ptymek/projekt_obpla_wip/SCREENY/MATRYCA_AKSJONOMETRIA.jpg

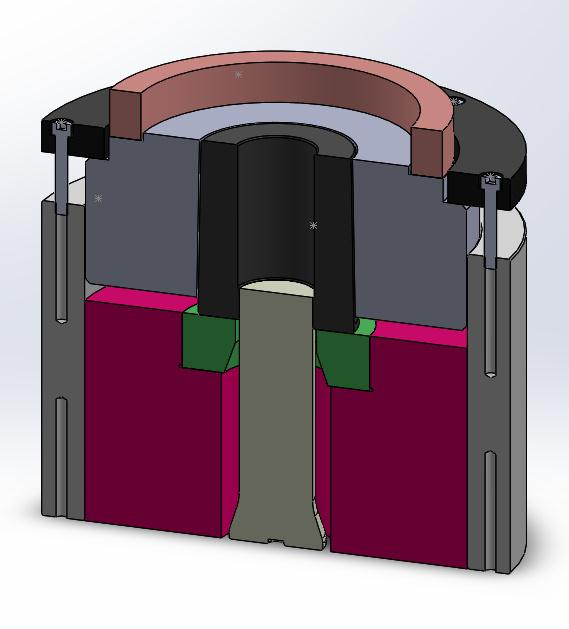
SCREENY/MATRYCA_AKSJONOMETRIA.jpg
