ptymek/projekt_obpla_wip/SCREENY/POZYCJA_WYPCHNIĘCIE_AKSJONOMETRIA.jpg

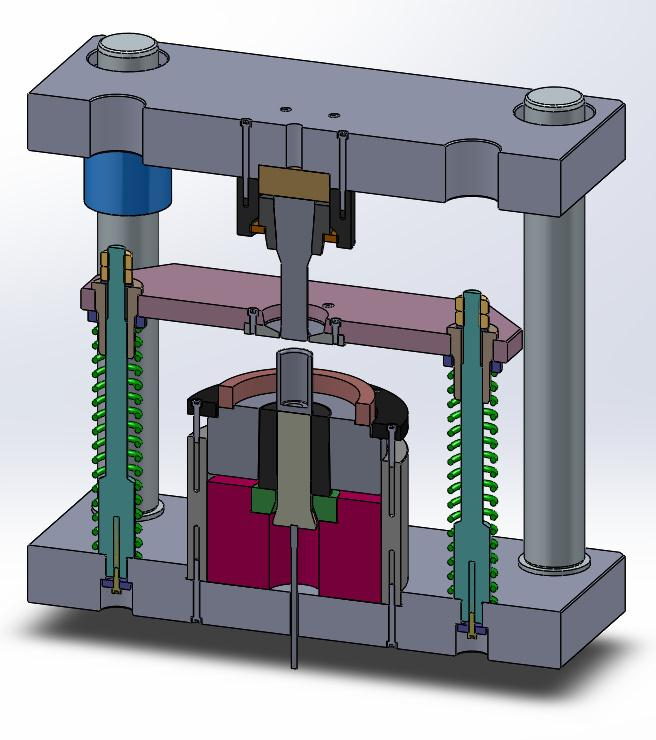
SCREENY/POZYCJA_WYPCHNIĘCIE_AKSJONOMETRIA.jpg
