ptymek/projekt_obpla_wip/PDF/PROiT-2014-bryly-r2.pdf

Projektowanie

TECHNOLOGIA KSZTAŁTOWANIA WYPRASEK NACZYNIOWYCH METODAMI OBRÓBKI PLASTYCZNEJ OBJĘTOŚCIOWEJ

### Materiały pomocnicze do projektowania

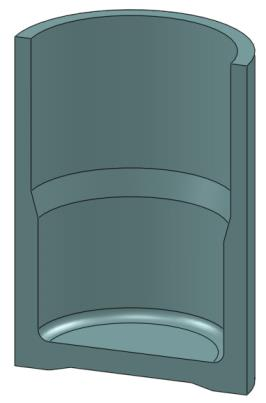
[picture p3: figure]
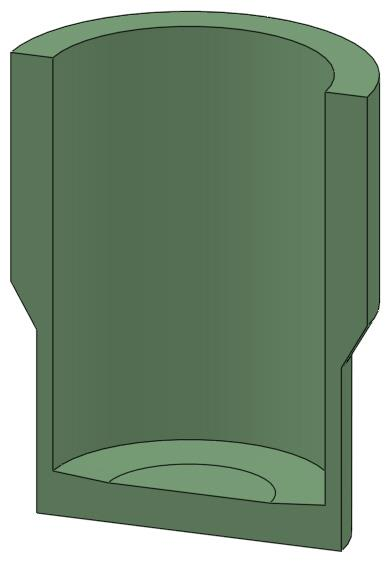
[picture p4: figure]

Wojciech Presz

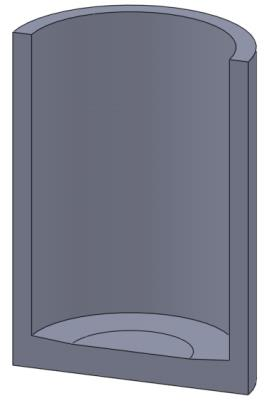
[picture p5: figure]
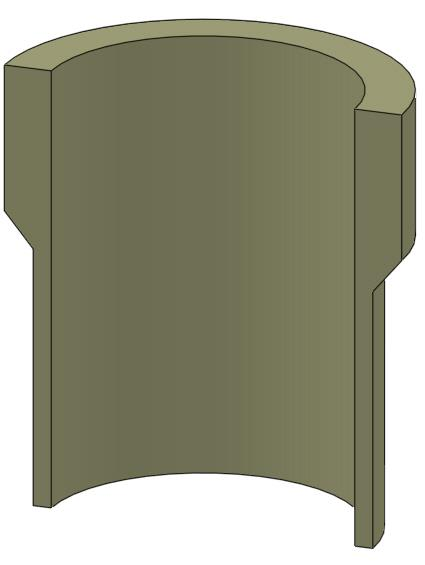
[picture p6: figure]

Uwaga! Dokument w fazie powstawania.

# Wersja 2014 r1

Instytut Technik Wytwarzania Politechniki Warszawskiej 2014

PROiT-2014-bryly-r2.doc | 2

Do realizacji projektu konieczny jest dostęp do programu SolidWorks wersja edukacyjna.

Nowoczesne projektowanie

Rysunek techniczny powstał jako forma zapisu otaczającego nas świata przestrzennego za pomocą rysunków płaskich. Umieszczane na papierze były następnie podstawą procesu wytwarzania na kolejnych stanowiskach roboczych. Konstruktor w przypadku złożonych urządzeń zmuszony był rozrysowywać wiele przekrojów, tak by zauważyć przestrzenne kolizje elementów. Umieszczane na rysunkach wykonawczych wymiary musiały być sprawdzane przez kolejne osoby, które starały się zauważyć często zdarzające się pomyłki. Na rysunkach zaznaczano także, inne prócz kształtu cechy przedmiotów: materiał, obróbkę cieplną, chropowatość poszczególnych powierzchni, tolerancje wymiarów i kształtów itp. Cechy te wiązane były z określonymi miejscami poszczególnych rysunków i przez niedopatrzenia mogły nie być przenoszone na kolejne arkusze.
Obecnie, stosowane jest powszechnie projektowanie parametryczne 3D, którego podstawą jest tworzenie konstrukcji przestrzennych w przestrzeni matematycznej. Tak zapisane konstrukcje umożliwiają automatyczne lub choćby wizualne wykrywanie kolizji przestrzennych, a więc praktycznie eliminują pomyłki rysunkowe i nie wymagają sprawdzania pod tym kątem. Automatyczne wymiarowanie eliminuje błędy wymiarowania poszczególnych rysunków wykonawczych, a cechy są przyporządkowywane poszczególnym powierzchniom lub bryłom, co powoduje ich automatyczne przenoszenie do tworów zależnych. Parametryzacja wymiarów i budowanie zależności pomiędzy nimi powoduje łatwość wprowadzania zmian konstrukcyjnych, a pakiety obliczeniowe podają wymagane parametry konstrukcji lub jej części: objętość, powierzchnię, ciężar itp. Przestrzenny zapis elementów konstrukcji: (poszczególnych części) pozwala także na bezpośrednie generowanie kodów do maszyn lub centrów obróbczych sterowanych numerycznie, co obecnie w niektórych wypadkach wręcz eliminuje konieczność powstawania tradycyjnych rysunków technicznych. Matematyczny zapis przestrzenny elementów pozwala także na bezpośrednie przenoszenie ich do programów obliczeniowych np. MES (metoda elementów skończonych) w celu obliczeń wytrzymałościowych.

Sposób realizacji projektu

Projekt ma być realizowany w oparciu o edukacyjną wersje programu SolidWorks (2013/2014) , w którym definiowane bryły posiadają łatwo zmienne parametry, co umożliwia proste wprowadzanie poprawek w trakcie procesu projektowania. Wybór akurat tego programu związany jest z jego powszechnością występowania i faktem, że posiada wymagane cechy. Nie oznacza natomiast jego wartościowania. Jest jednym z programów dobrze nadających się do nowoczesnego projektowania.
Wszystkie elementy oraz całość konstrukcji muszą być modelowane w przestrzeni i na tej podstawie sporządzane odpowiednie rysunki techniczne części. W trakcie projektowania Planu technologicznego (sekwencji kształtów procesu technologicznego) niezbędne jest obliczanie objętości kształtowanego materiału. Objętość ta obliczana (odczytywana) ma być za pomocą stosowanego programu.
Niedopuszczalne jest tworzenie rysunków, które nie są odwzorowaniem modeli przestrzennych.

### 1. Proces technologiczny

Wprowadzenie

W obrębie tego zadania przewidziane jest zaprojektowanie procesu technologicznego prowadzącego do powstania jednego z wyrobów reprezentatywnych pokazanych na rys. 1. Wyroby te zaliczane są do grupy wyrobów kształtowanych objętościowo.
Pierwszą | czynnością | przed | przystąpieniem | do | projektowania | procesu
technologicznego, jest zamodelowanie kształtu wyrobu według wymiarów podanych na stronie tytułowej, a następnie sporządzenie jego rysunku (odpowiedni zwymiarowany przekrój na płaszczyźnie rysunku z tabelką).
Procesy obróbki objętościowej rzadko prowadzą do uzyskania gotowego wyrobu. Najczęściej otrzymuje się wypraskę, która wymaga odpowiednich operacji dodatkowych takich jak obróbka (wyrównywanie) powierzchni swobodnych lub korygowanie wymiarów. Oznacza to, że końcowy kształt uzyskany w procesie technologicznym obróbki plastycznej różni się od kształtu wyrobu o odpowiednie naddatki technologiczne.
W następnym kroku projektowania należy więc kształt wyrobu odpowiednio zmodyfikować o naddatki i uzyskać kształt wypraski, która ma być końcowym efektem operacji plastycznego kształtowania.
Teraz na podstawie kształtu wypraski należy zaprojektować proces technologiczny składający się z następujących po sobie operacji technologicznych.
Operacja technologiczna związana jest z jednym stanowiskiem roboczym np. z prasą. Operacja może być prosta tzn. składać się z jednego zabiegu technologicznego lub złożona – składać się z kilku zabiegów technologicznych.
Zabieg technologiczny związany jest, z kolei, z kształtowaniem realizowanym pojedynczym narzędziem (lub ich parą np. stempel-matryca) w trakcie jednego ruchu roboczego maszyny.
Każda operacja technologiczna wymaga:
- zaprojektowania kształtu wejściowego do operacji oraz kształtu wyjściowego z niej,
- zaprojektowania narzędzi (np. stempel, matryca),
- zaprojektowania przyrządu umożliwiającego właściwą pracę narzędzi,
- doboru odpowiedniej maszyny (prasy).

Plan postępowania

1. Rysunek techniczny wyrobu
2. Rysunek techniczny planu operacyjnego z umieszczonym na końcu wyrobem
(na rysunku tym w miarę kolejnych faz procesu projektowania dodawane są kolejne kształty).
3. Analiza możliwości wykonania.
4. Obliczenie objętości materiału.
5. Ustalenie wymiarów wstępniaka i wrysowanie wstępniaka na początku planu operacyjnego.
6. Opracowanie procesu technologicznego (plan operacyjny)
7. Obliczenie sił i prac kształtowania w poszczególnych operacjach.
8. Rysunki narzędzi kształtujących.

9. Projekt przyrządu do wybranej operacji.
10. Dobór prasy do wybranej operacji.

Tablica 1. Klasy dokładności według ISO

Metoda
kształtowania | 5 | 6 | 7 | 8 | 9 | 10 | 11 | 12 | 13 | 14 | 15 | 16

Kucie matrycowe

Wyciskanie na gorąco | x | x | x | x | x | x | x
Wyciskanie na zimno | x | x | x | x | x | x
Wyciąganie | x | x | x | x | x
Dogniatanie | x | x | x | x | x | x
Matrycowanie | x | x | x | x
Młotkowanie | x | x | x | x | x | x
Toczenie | x | x | x | x | x | x | x
Szlifowanie | x | x | x | x

Tablica 2. Najmniejsza opłacalna produkcja technologią obróbki plastycznej

Masa wyrobu [kg] | Najmniejsza seria [szt.] | Rocznie [szt]
do 0.5 | 10000 | 30000
0.5 - 1 | 5000 | 15000
1.0 - 3.0 | 3000 | 9000
ponad 3.0 | 1000 | 2000

Przygotowanie wstępniaka

Cięcie plastyczne

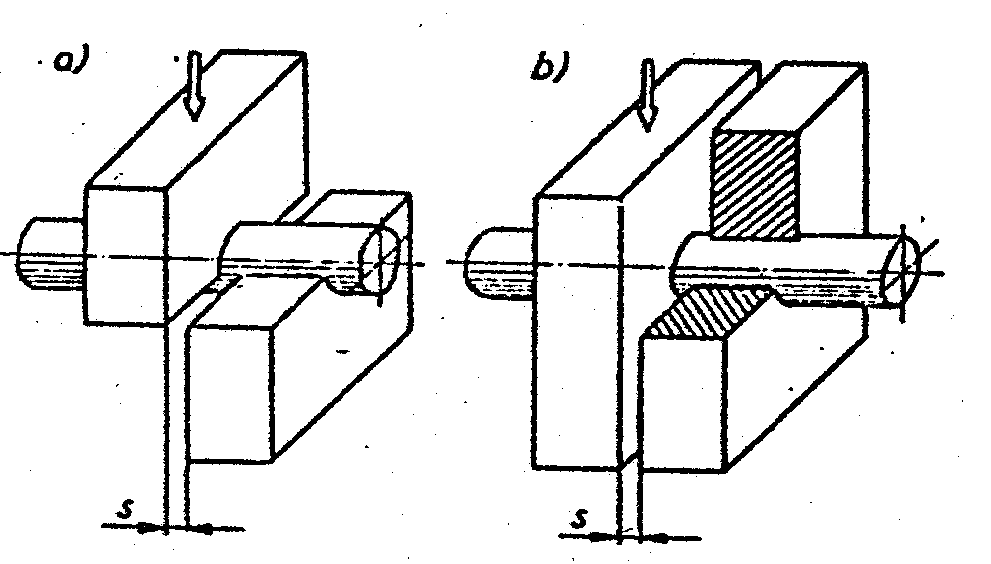
[picture p7: figure]

Wstępne spęczanie

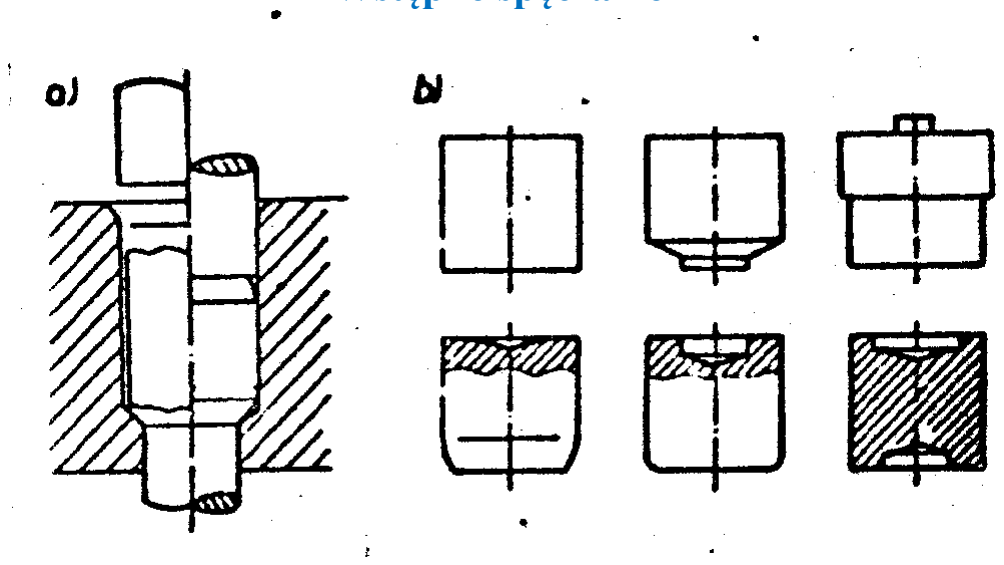
[picture p8: figure]

Toczenie

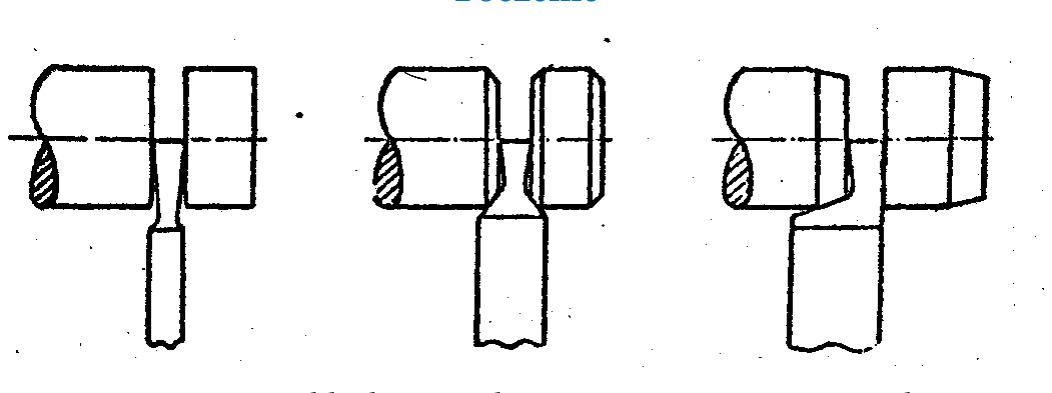
[picture p9: figure]

Rys..1. Przykłady metod przygotowania wstępniaka

Smarowanie

Dotyczy wstępniaka oraz w razie potrzeby, (trudne warunki) kształtów pośrednich.

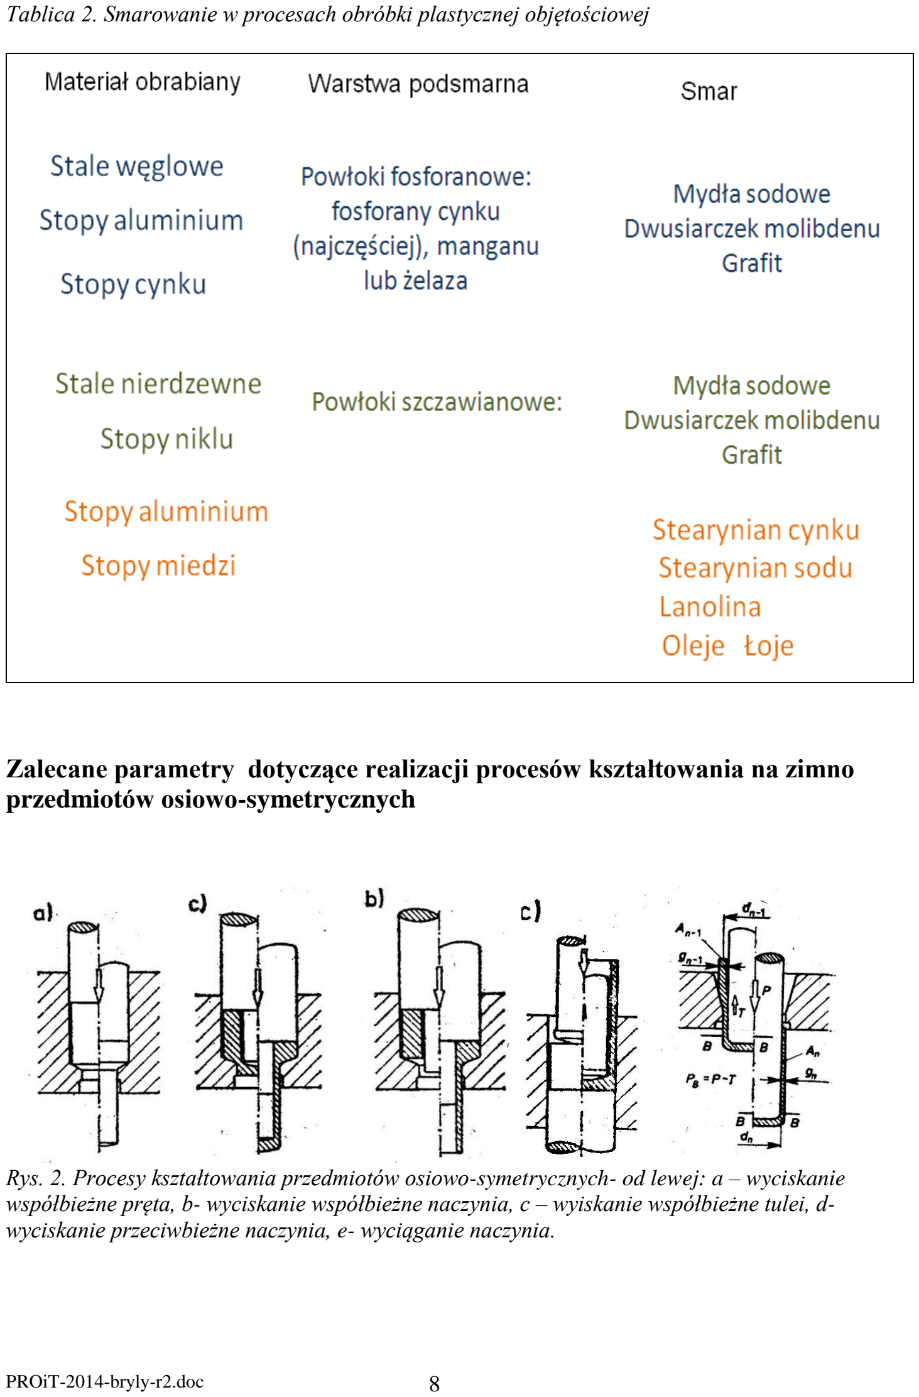
[picture p10: page 8]

Tablica 2. Smarowanie w procesach obróbki plastycznej objętościowej

Zalecane parametry dotyczące realizacji procesów kształtowania na zimno przedmiotów osiowo-symetrycznych

Rys. 2. Procesy kształtowania przedmiotów osiowo-symetrycznych- od lewej: a – wyciskanie współbieżne pręta, b- wyciskanie współbieżne naczynia, c – wyiskanie współbieżne tulei, d-wyciskanie przeciwbieżne naczynia, e- wyciąganie naczynia.

## Warunki ograniczające i sprawności procesów

Wyciskanie przeciwbieżne
Warunek 1: maksymalne odkształcenie

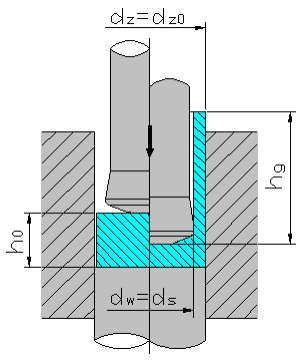
[picture p11: figure]
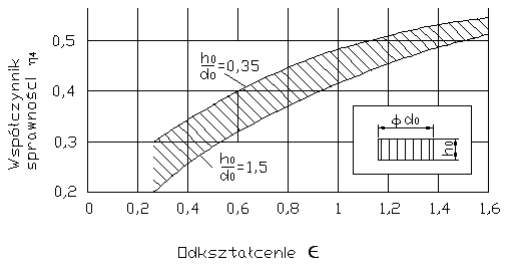
[picture p12: figure]

Rys. 3. Wpływ odkształcenia ε i względnej wysokości wstępniaka h0/d0 na wartość współczynnika sprawności η4 procesu przeciwbieżnego wyciskania stalowych naczyń.

d d

d
A A

A

S

S

2 | 2

0

2

0

0

0
ln | ln

=
ε = | (1)

Tablica.3. Orientacyjne wartości odkształcenia dla różnych materiałów możliwe do uzyskania w jednej operacji przeciwbieżnego wyciskania naczyń

Materiał | εA % | Materiał | εA %
max | min | | max | min
Aluminium: AR1, AR2, A00, A0, A1, A2 | 98 | 10 | Stale o szczególnie małej zawartości węgla: E04, E04A, E04J, E04JA | 70 | 15
Stopy aluminium: PA1, PA2, PA11, PA38, PA4, PA 43 | 95 | 10 | Stale niskowęglowe wyższej jakości: 08, 08YA, 10, 10YA, 15 | 65 | 20
Stopy aluminium: PA6, PA7, PA21, PA23, PA25, PA9 | 70 | 10 | Stale węglowe wyższej jakości: 20, 25, 35, 35YA | 65 | 20
Miedź: M1R, M1E, M2R, M2G, M3G, MOOB, MOB, MHDT | 75 | 30 | Stale stopowe:15H, 20H, 16HG, 15HGM, 15 HN | 60 | 20
Mosiądz: M90, M80, M70, M63, MN65 | 65 | 20
100% | 100% | 100% | 2

100%

| | | 0

2

0 | 0

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
- | = | • | =
= | • | =

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
A | n | S | S
ε A | (2)

Warunek 2: Zacieranie – powodujące przeciążenie narzędzi – ograniczenie względnej głębokości otworu

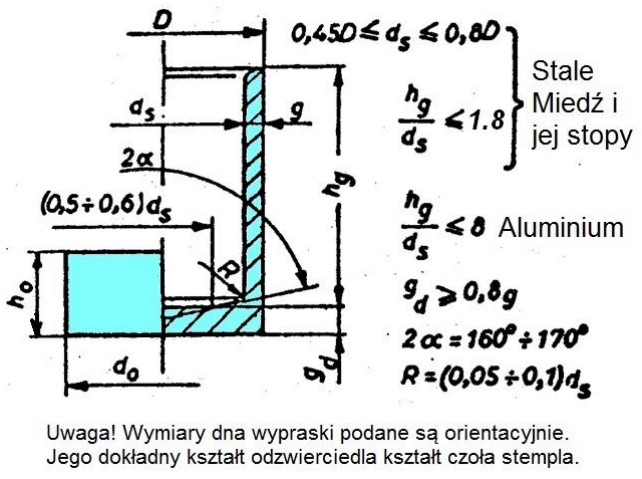
[picture p13: figure]

Rys.4. Zalecana względna głębokość otworu

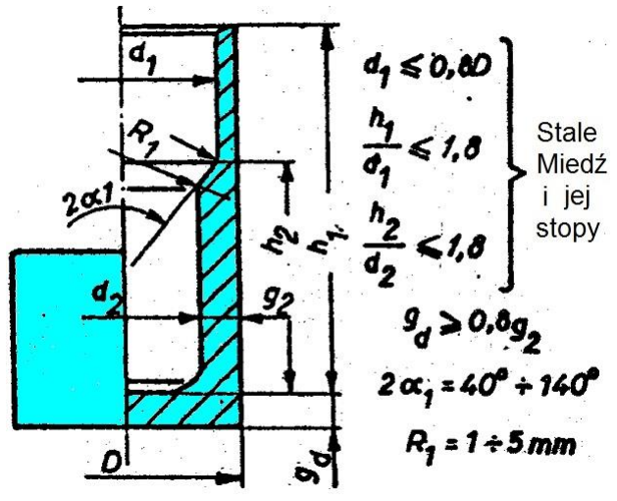
[picture p14: figure]

Rys.5. Zalecana względna głębokość otworu w wypadku stempla stopniowego

Wyciskanie współbieżne
Warunek 1: Maksymalne odkształcenie

Tablica 4. Przybliżone wartości współczynnika sprawności η2 dla współbieżnego wyciskania prętów i tulei za pomocą matrycy o kącie stożka roboczego 2α = 60° i przy bardzo dobrym smarowaniu /µ ≈ 0,03 ÷ 0,05/.

Strain ε | Efficiency η2 | Strain ε | Efficiency η2
h 0 = 1 d 0 | h 1 0 0 = d 0 | | h 0 = 1 d 0 | h 1 0 0 = d 0
0,4 0,6 0,8 1,0 1,2 | 0,54 0,61 0,67 0,71 0,73 | 0,46 0,52 0,56 0,59 0,61 | 1,4 1,6 1,8 2,0 2,2 | 0,75 0,77 0,78 0,79 0,80 | 0,63 0,65 0,66 0,67 0,68

Tablica 5. Maksymalne odkształcenia ((3) i (4)) możliwe do uzyskania w jednej operacji wyciskania współbieżnego
Material | εA % | ε | Material | εA % | ε

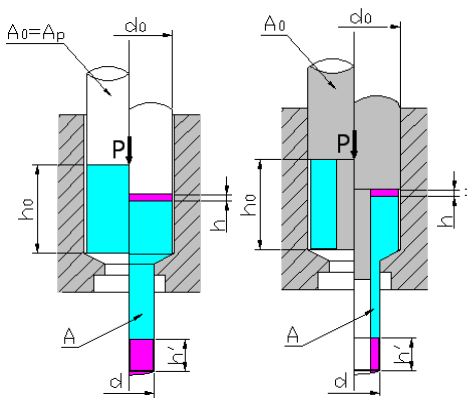
[picture p15: figure]

Aluminum: AR1, AR2, A00, A0, A1, A2 | 98 | 3,9 | Mild steel: E04, E04A, E04J, E04JA | 75 | 1,4
Aluminium alloy: PA1, PA2, PA11, PA38, PA4, PA 43 | 95 | 3,0 | Low carbon steel: 08, 08YA, 10, 10YA, 15 | 70 | 1,2
Aluminum alloy: PA6, PA7, PA21, PA23, PA25, PA9 | 70 | 1,2 | Low carbon steel: 20, 25, 35, 35YA | 60 | 0,9
Copper: M1R, M1E, M2R, M2G, M3G, MOOB, MOB, MHDT | 80 | 1,6 | Alloy steel:15H, 20H, 16HG, 15HGM, 15 HN | 55 | 0,8
Brass: M90, M80, M70, M63, MN65 | 70 | 1,2 | Alloy steel: 30H, 40H, 35HN, 1H13, 1H18N9T | 50 | 0,7

A

A0
ε = ln | (3)

100%

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
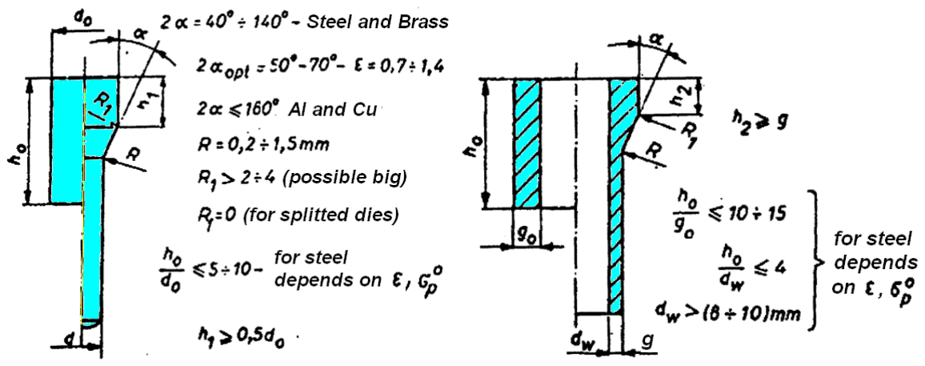
[picture p16: figure]

Rys.6. Zalecane wymiary narzędzi

Wyciąganie
Warunek 1: Maksymalne odkształcenie

Tablica 6. Odkształcenie (5,6) możliwe do uzyskania w jednej operacji

Material | εA % | ε | Material | εA % | ε
Aluminum: AR1, AR2, A00, A0, A1, A2 | 30 | 0,35 | Mild steel: E04, E04A, E04J, E04JA | 40 | 0,5
Aluminum alloy: PA1, PA2, PA11, PA38, PA4, PA 43 | 30 | 0,35 | Low carbon steel: 08, 08YA, 10, 10YA, 15 | 35 | 0,43
Aluminum alloy: PA6, PA7, PA21, PA23, PA25, PA9 | 30 | 0,35 | Low carbon steel: 20, 25, 35, 35YA | 35 | 0,43
Copper: M1R, M1E, M2R, M2G, M3G, MOOB, MOB, MHDT | 40 | 0,5 | Alloy steel:15H, 20H, 16HG, 15HGM, 15 HN | 30 | 0,35
Brass: M90, M80, M70, M63, MN65 | 35 | 0,43 | Alloy steel: 30H, 40H, 35HN, 1H13, 1H18N9T | 30 | 0,35

d d

d d
A

A

w

w
2 | 2
2 | 2
0 | 0
ln | ln

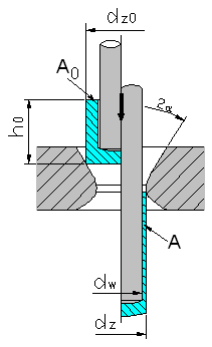
[picture p17: figure]

ε = | = | (5)
100 | 1 | 100 | 1 | 100 2

0

2 | 2
0 | 0

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
- | = | -
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
- | = | -
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
Sprawność η3 zależy od wartości odkształcenia ε, kąta matrycy 2α oraz współczynnika tarcia µ. Podobnie jak dla przepychania i wyciskania, zwiększenie wartości odkształcenia ε powoduje wzrost η3.
Dla wyciągania stalowych naczyń o fosforanowanych i namydlanych powierzchniach współczynnik sprawności procesu wynosi:
η3 = 0,35 ÷ 0,6 – przy odkształceniu ε=0,15
η3 = 0,6 ÷ 0,85 – przy odkształceniu ε=0,5
Większe wartości η3 odpowiadają wyciąganiu przy optymalnym kącie /2α/opt , dla którego siła wyciągania jest najmniejsza. Kąt ten zależy również od ε, a jego wartość wynosi: /2α/opt = 12° -przy odkształceniu ε = 0,15
/2α/opt = 30° -przy odkształceniu ε = 0,5
W praktyce może wystąpić konieczność przeprowadzenia procesu wyciągania przy kątach 2α > /2α/opt .Dolne granice η3 odpowiadają w przybliżeniu dwukrotnemu powiększeniu kąta stożka roboczego matrycy.
Uwaga! W wypadku wyciągania innych materiałów niż stal przyjąć można te same wartości sprawności.

Wyciąganie dwuzabiegowe

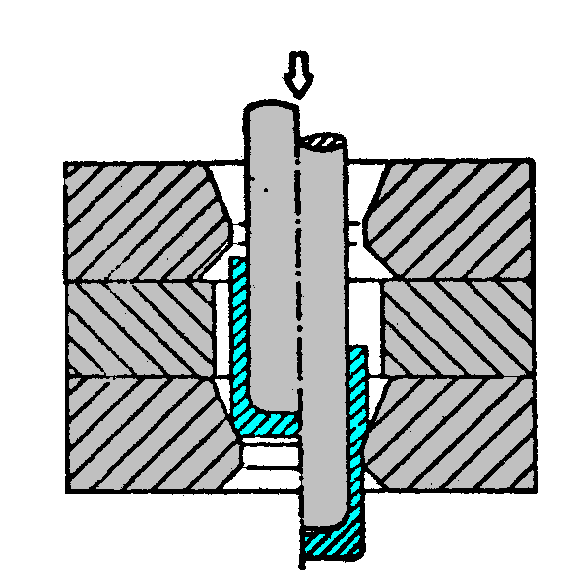
[picture p18: figure]
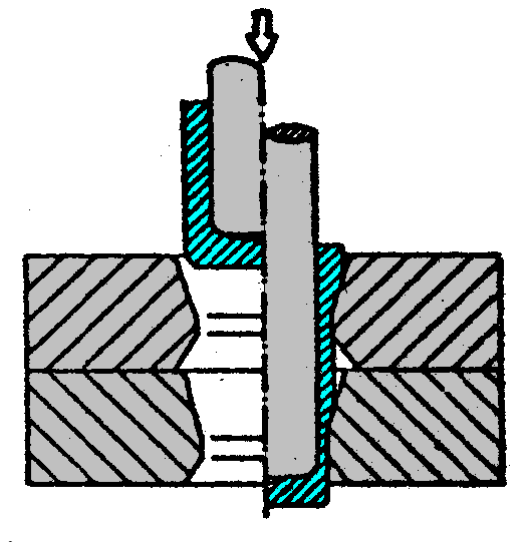
[picture p19: figure]

Fig. 11. Two steps drawing processes.

Większość materiałów w tablicy można kształtować w dwóch operacjach wyciągania bez zastosowania wyżarzania rekrystalizującego. Całkowite odkształcenie możliwe do uzyskania jest wówczas większe i np. dla stali niskowęglowej wynosi około εA = 50%, ε = 0,7. Stosuję się zwykle równy podział tego odkształcenia. Dobre wyniki uzyskuje się również, wtedy gdy w pierwszej operacji odkształcenie jest nieco większe – np. podział 0.4 i 0.3.

`

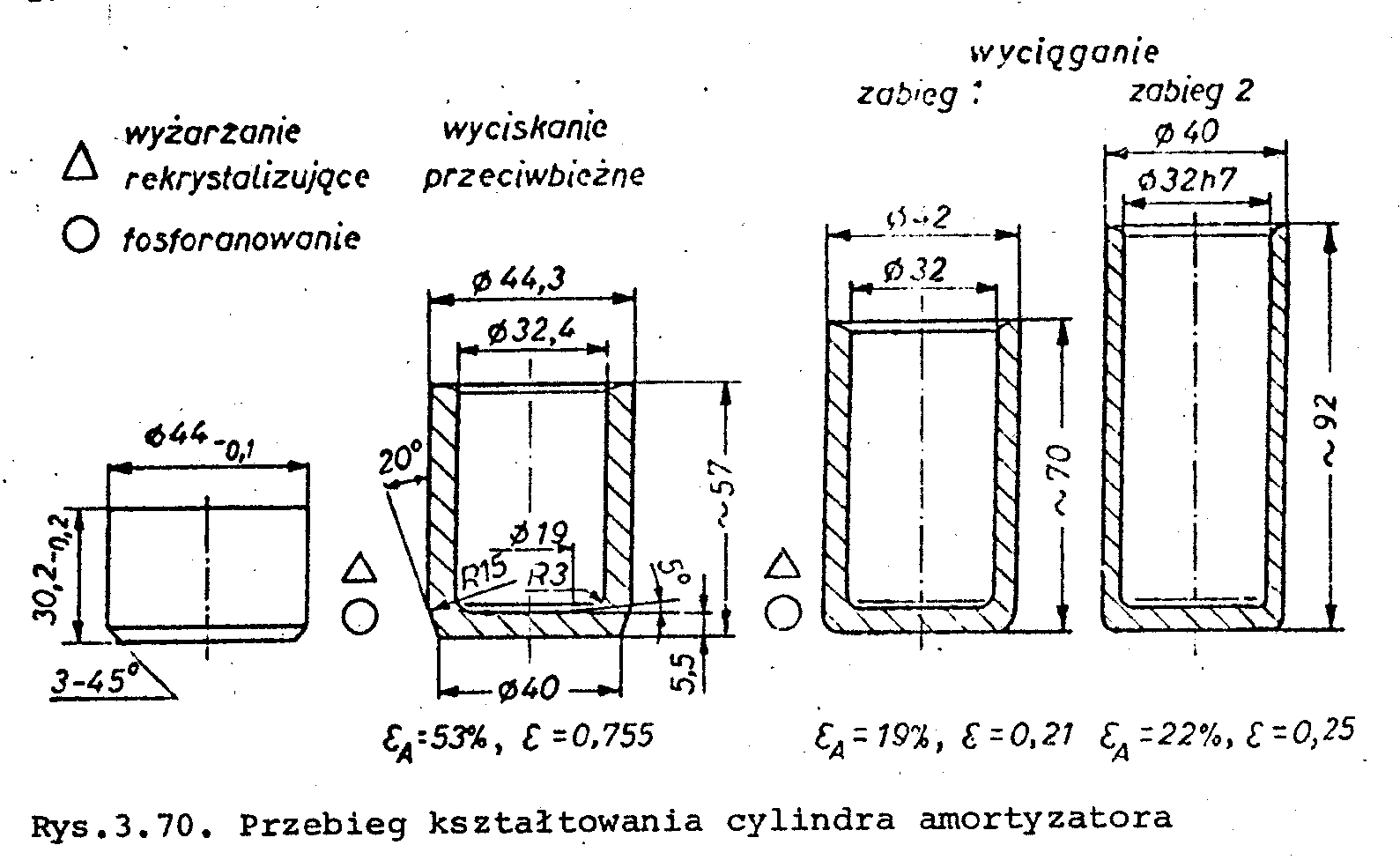
[picture p20: figure]

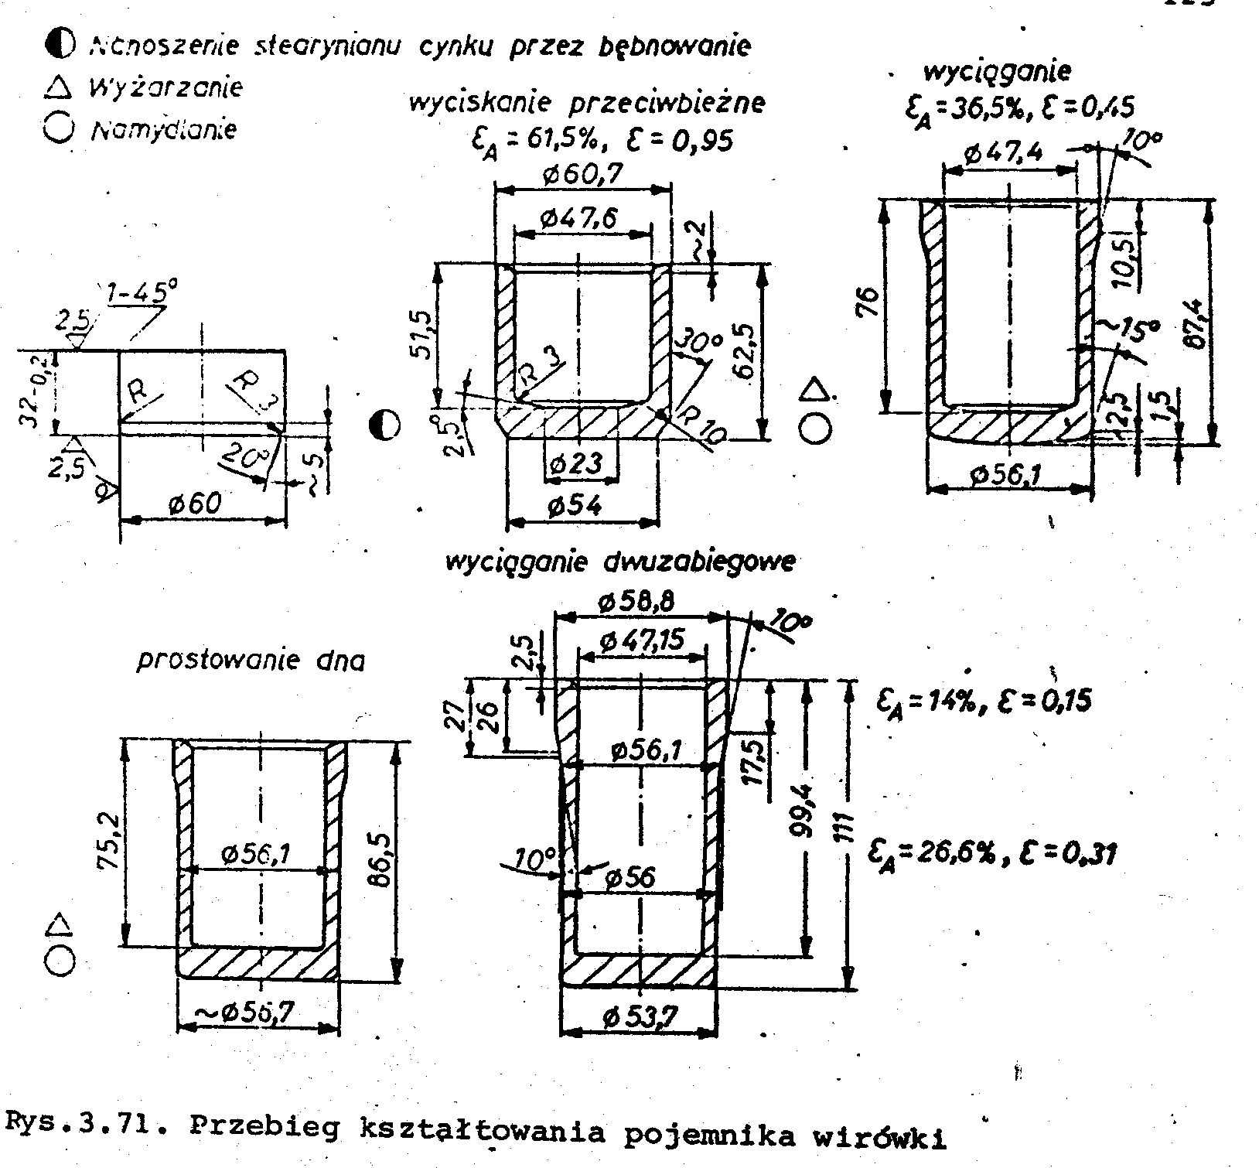
[picture p21: figure]

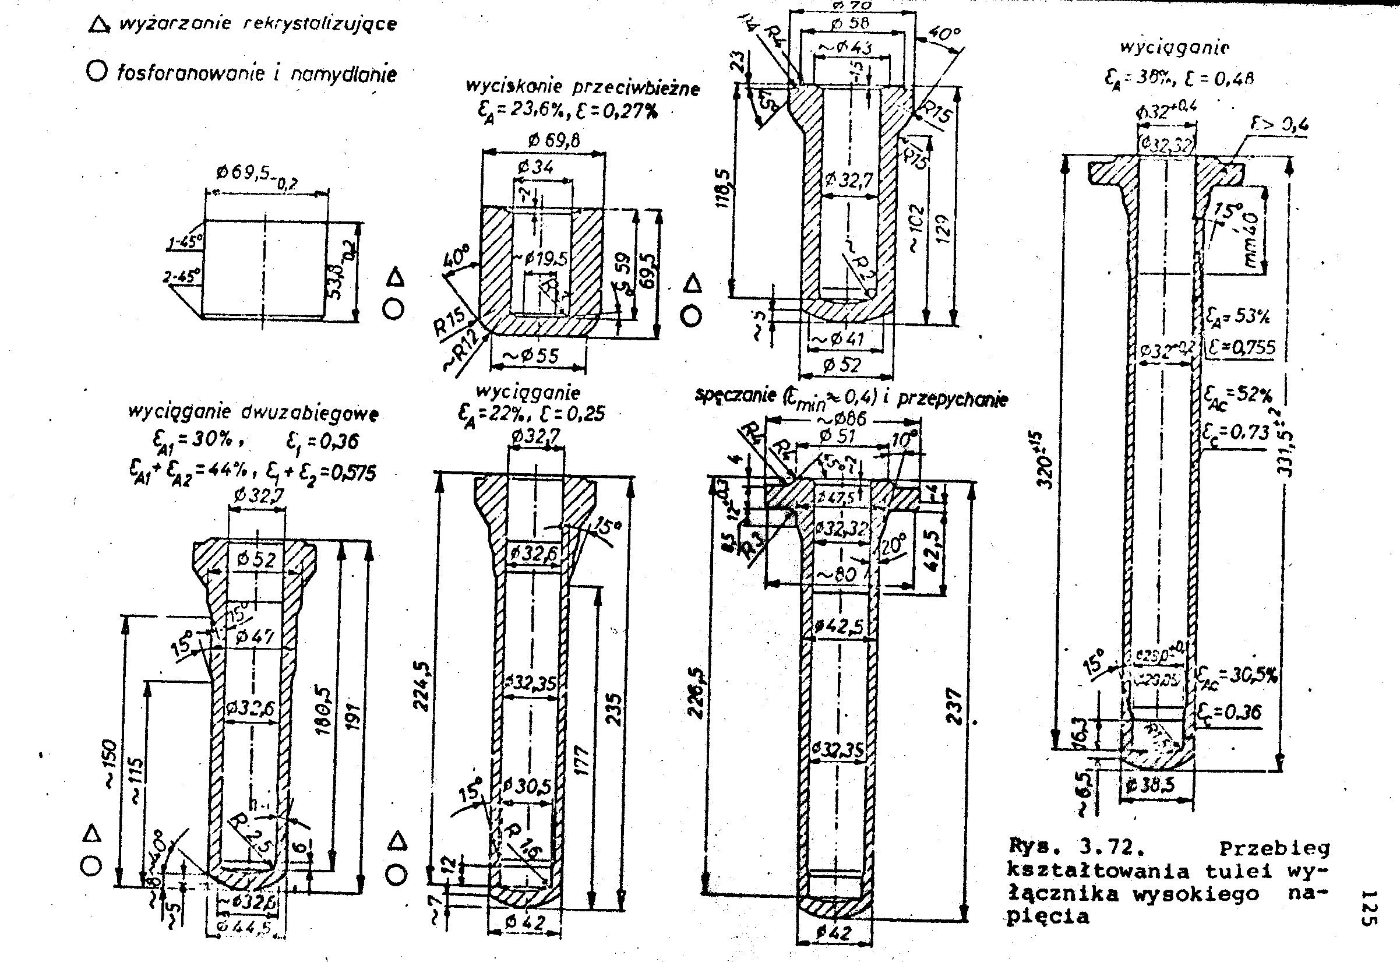
[picture p22: figure]

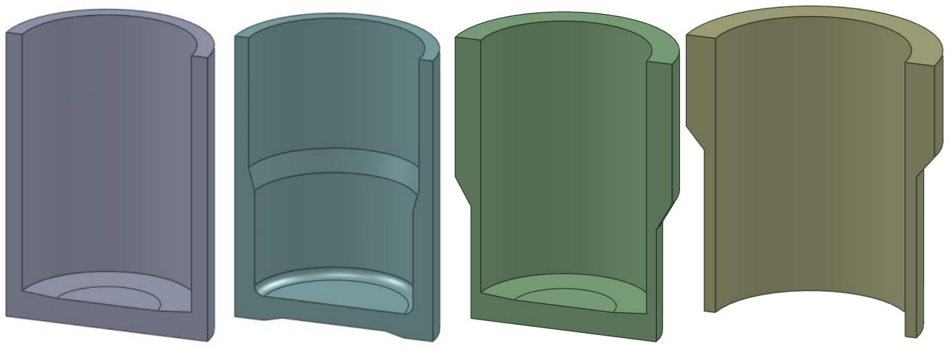
[picture p23: figure]
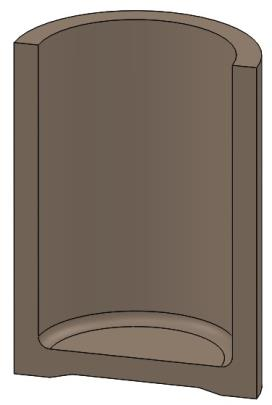
[picture p24: figure]

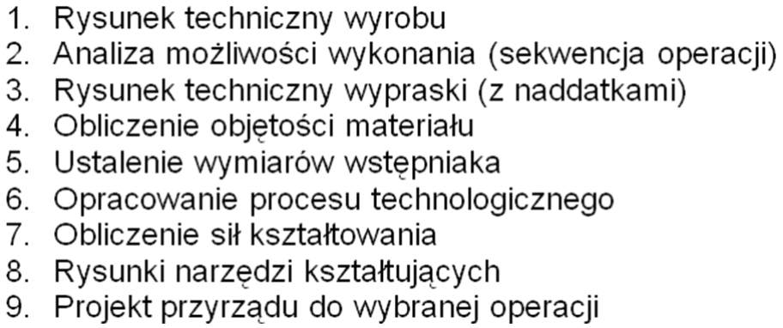
[picture p25: figure]
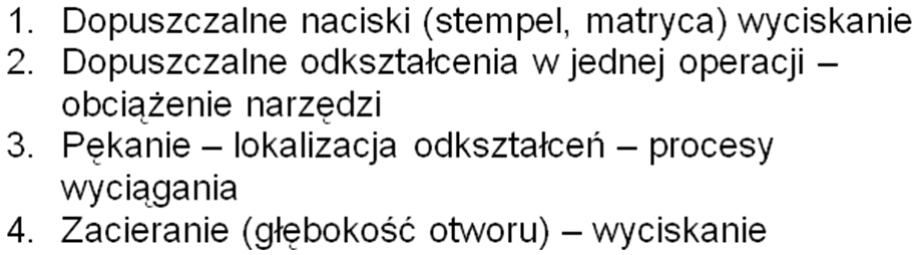
[picture p26: figure]

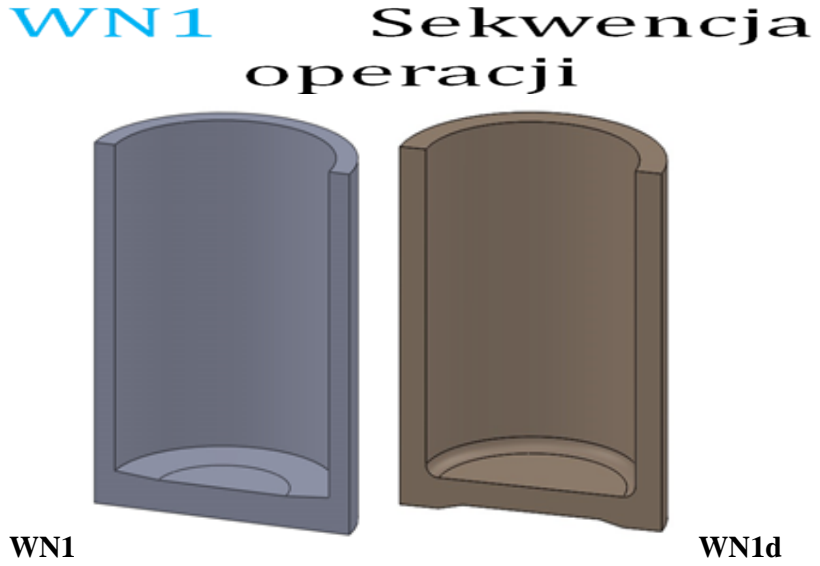
[picture p27: figure]
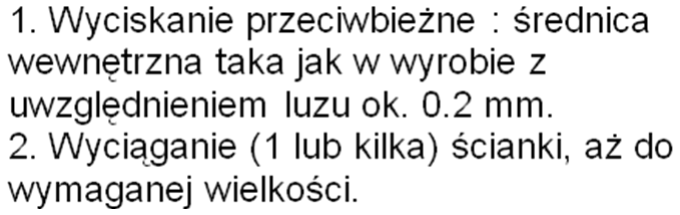
[picture p28: figure]

W wersji WN1d dodatkowo: Prostowanie dna.

Wyciskanie przeciwbieżne naczyń

Liczba

Nacisk na
stempel

przy
l/d | [MPa]
wyprasek | 1 | 2 | 3 | 4
do 1000 | 2800 | 2600 | 2300 | 1900
1000 do 3000 | 2600 | 2400 | 2100 | 1700
3000 do 5000 | 2300 | 2150 | 1900 | 1600
5000 do 10000 | 2000 | 1900 | 1700 | 1500
10000 do 20000 | 1700 | 1600 | 1500 | 1350
20000 do 40000 | 1500 | 1450 | 1300 | 1200

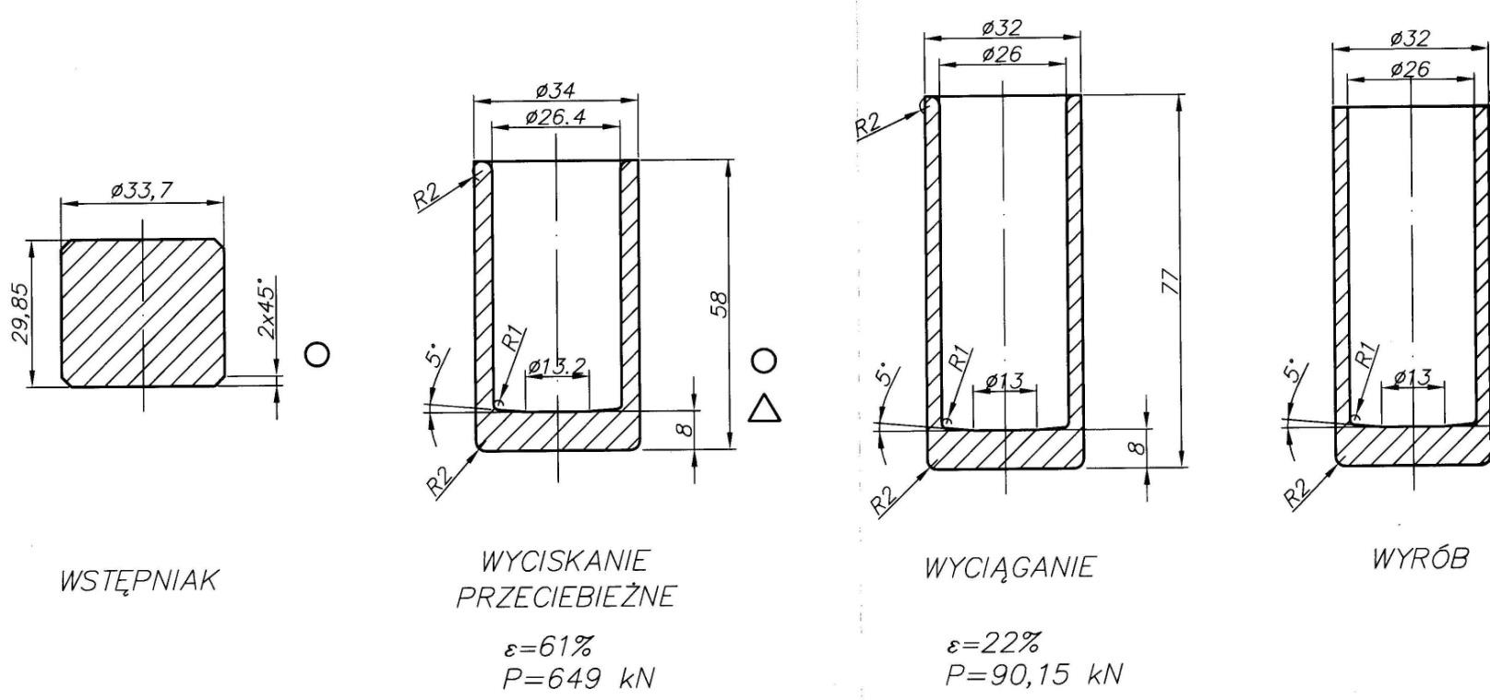
[picture p29: figure]
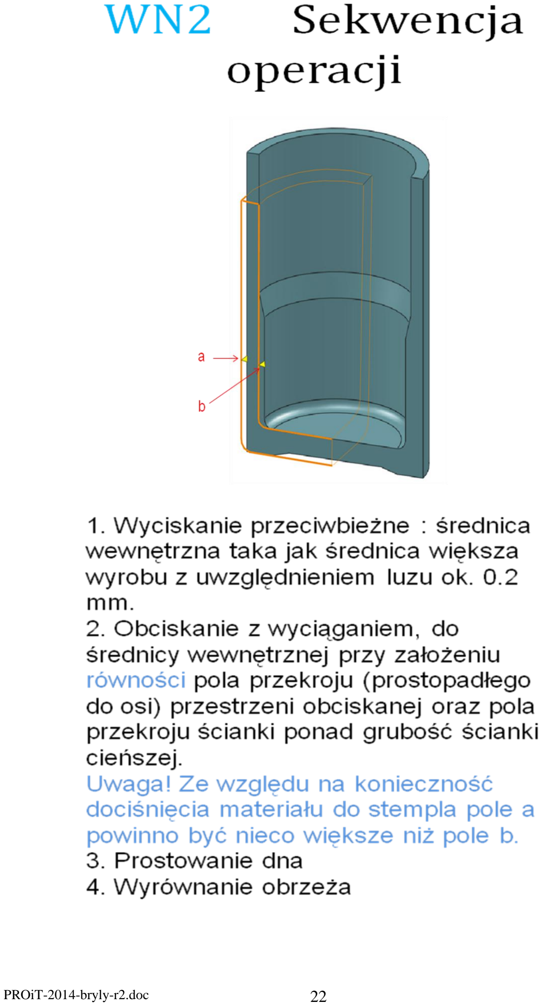
[picture p30: page 22]

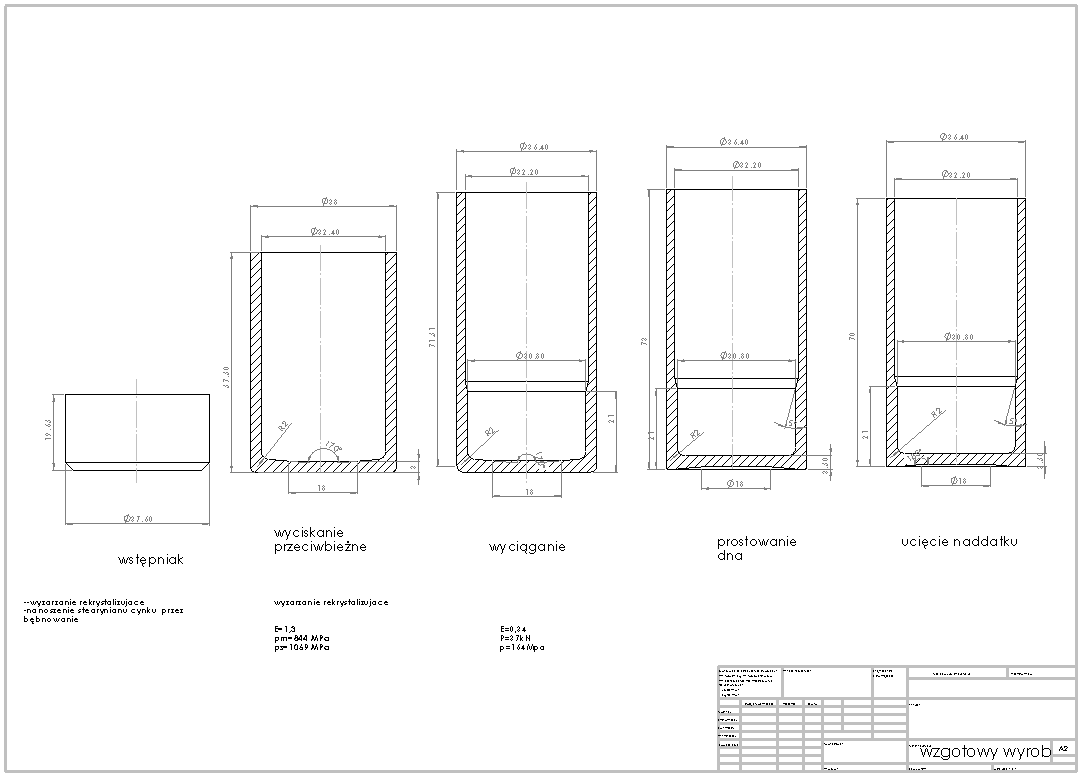
[picture p31: figure]

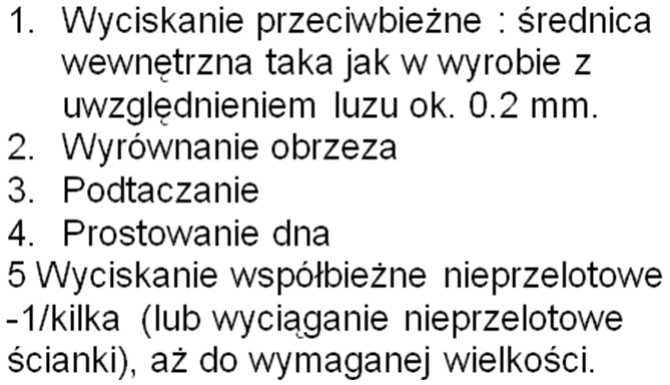
[picture p32: figure]

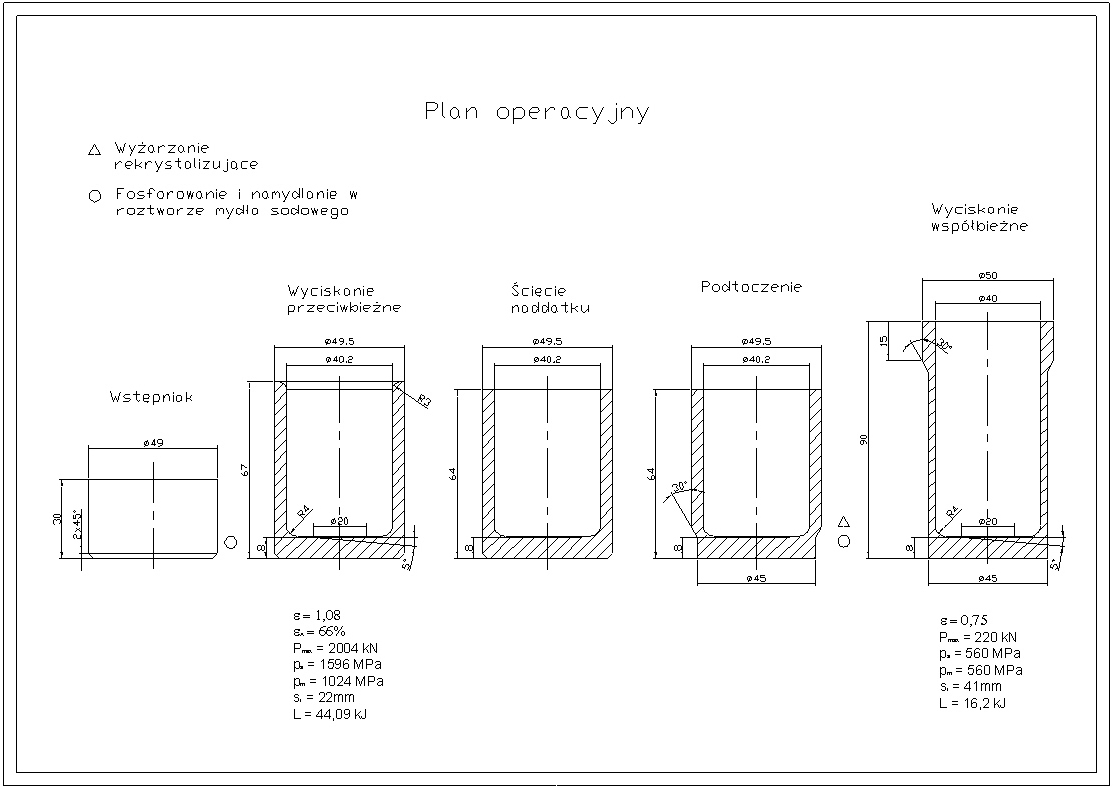
[picture p33: figure]

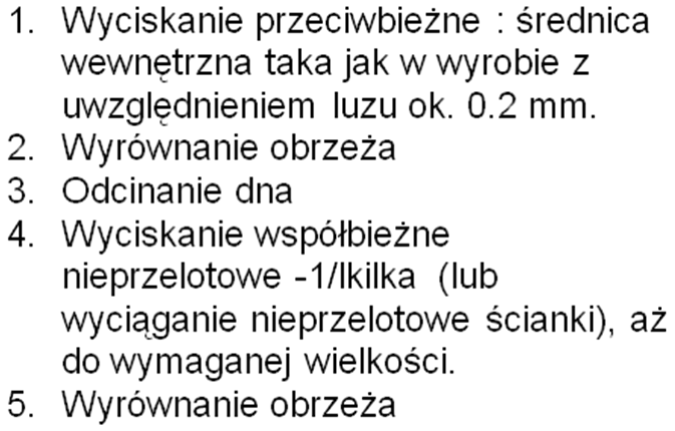
[picture p34: figure]

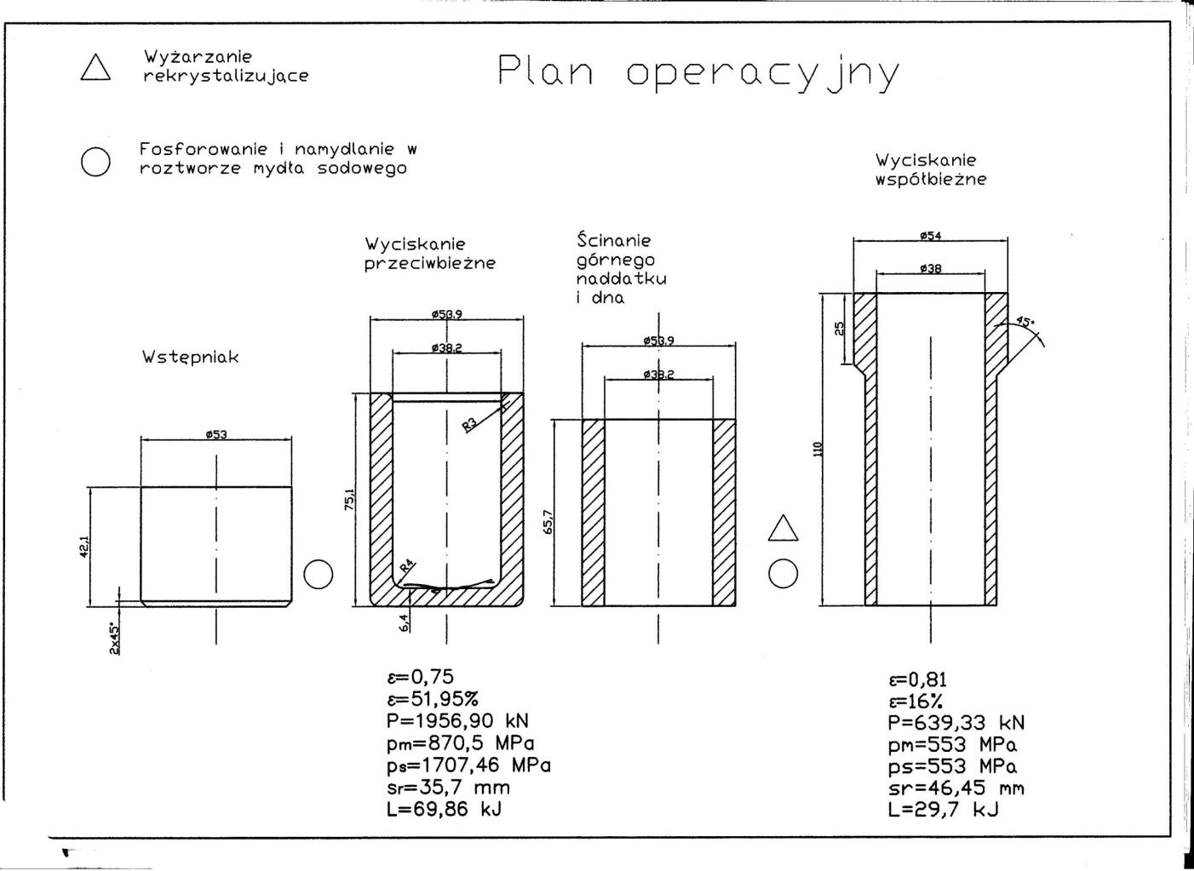
[picture p35: figure]

Uwaga! Na rysunku brakuje operacji wyrównania obrzeża. Ostatni kształt jest kształtem po wyrównaniu, to znaczy, że nie ma kształtu po wyciskaniu współbieżnym.

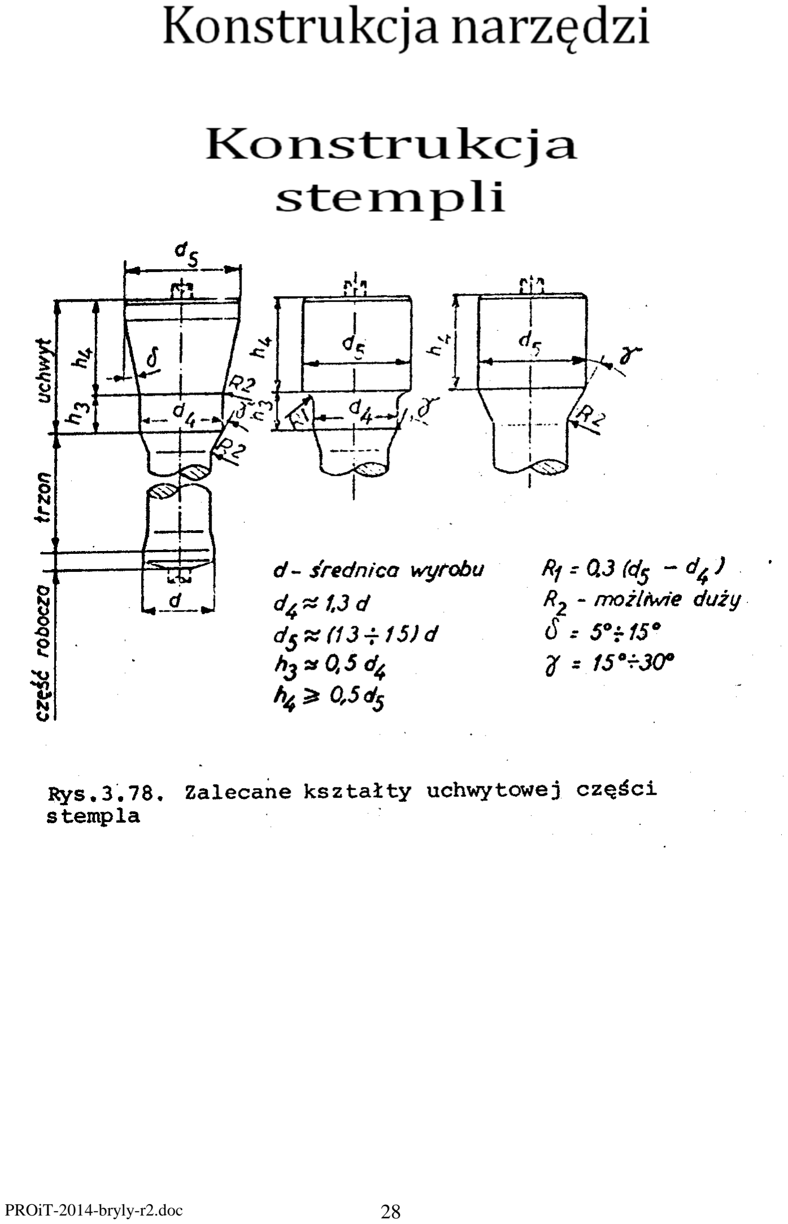
[picture p36: page 28]
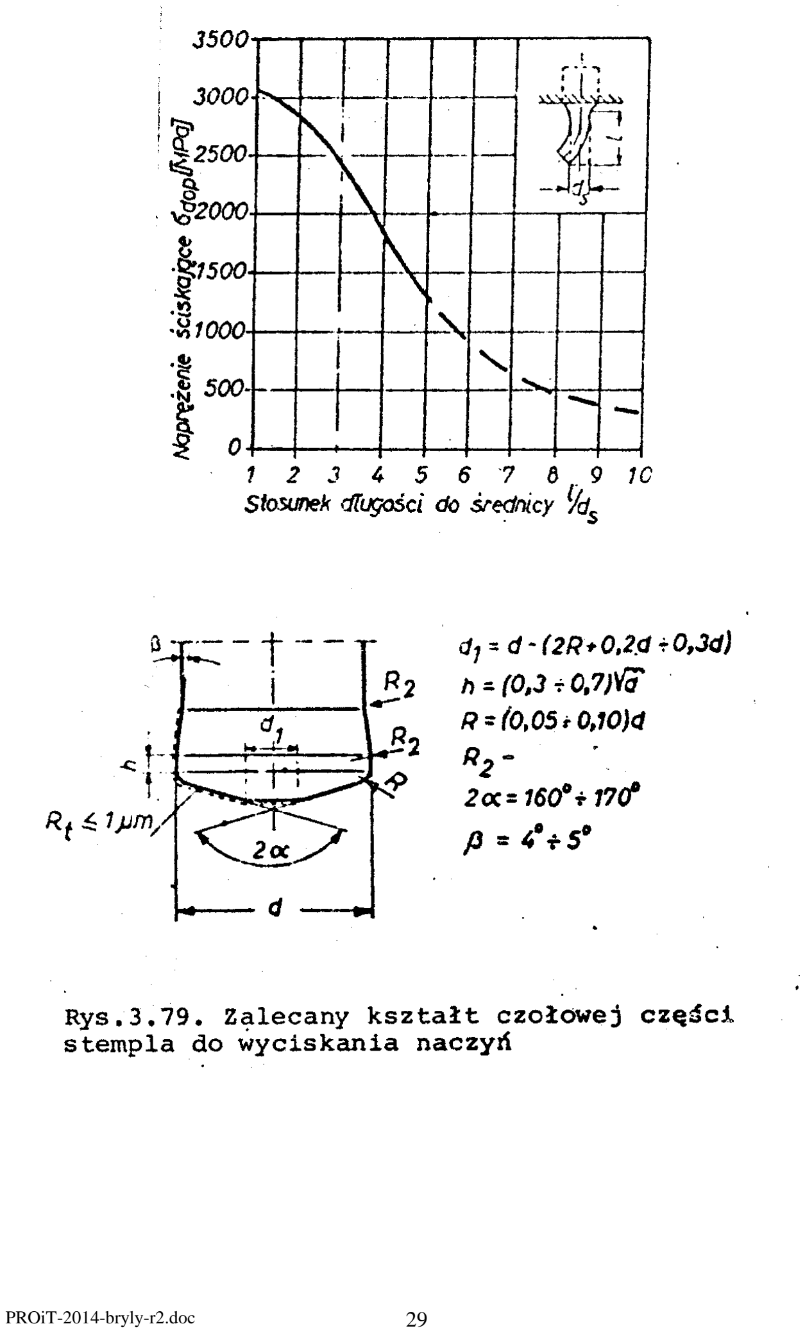
[picture p37: page 29]

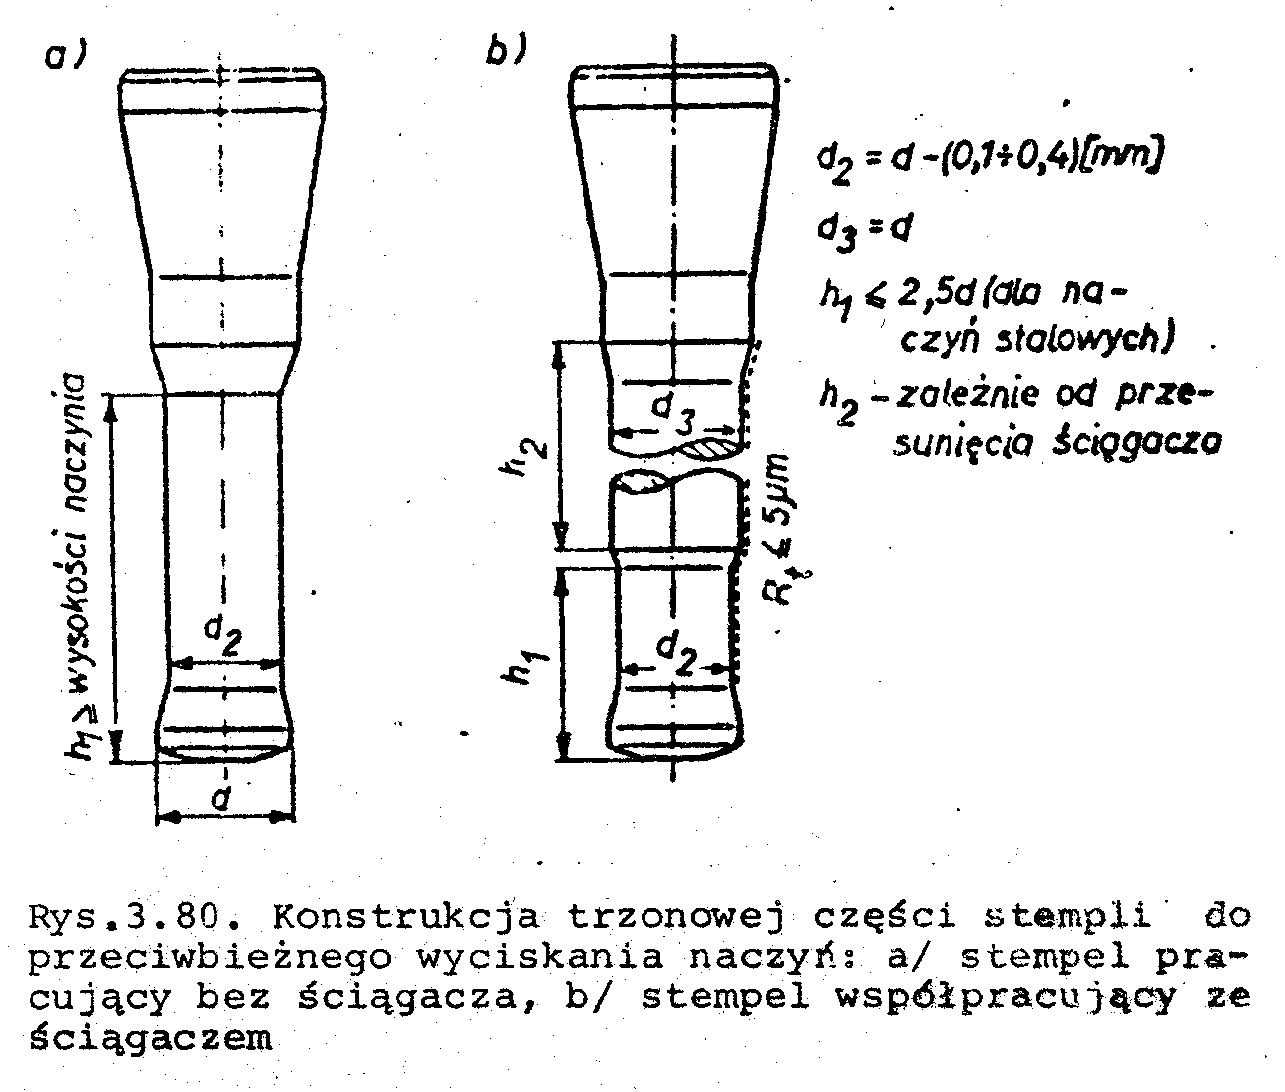
[picture p38: figure]

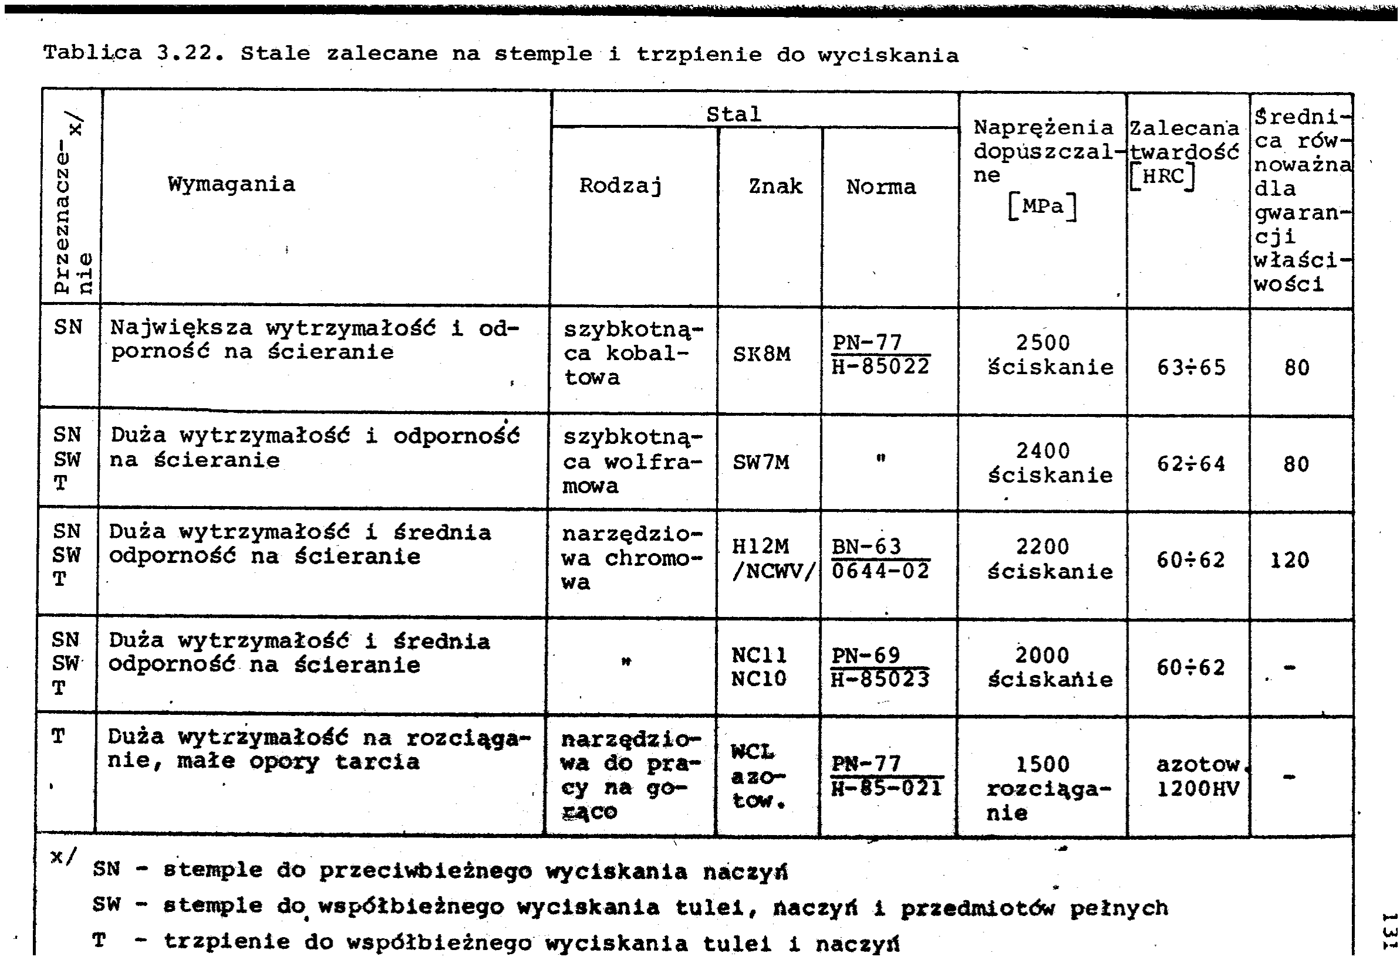
[picture p39: figure]

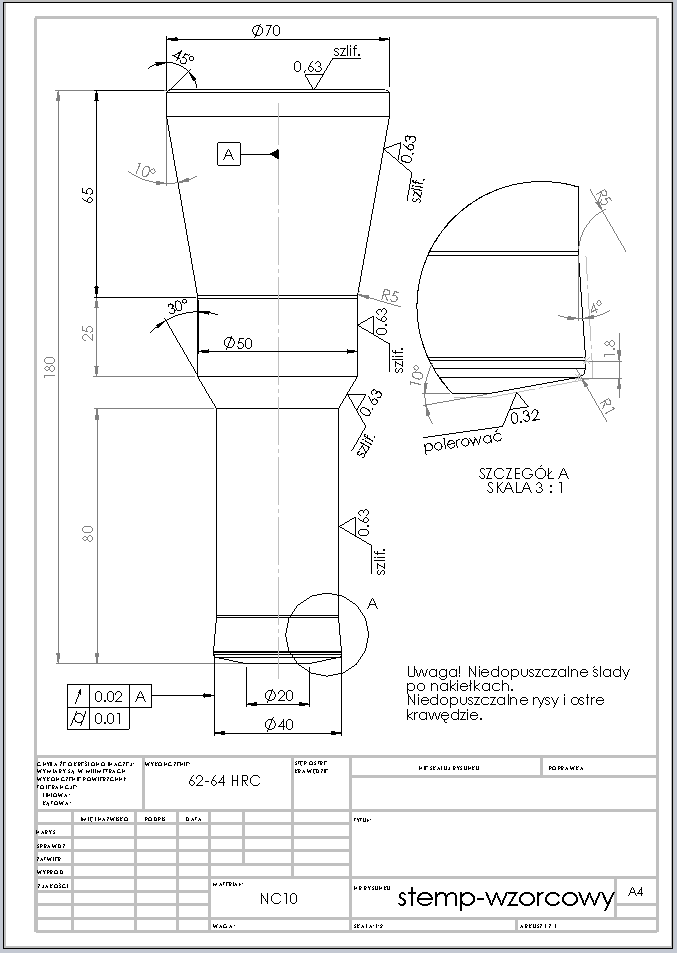
[picture p40: figure]
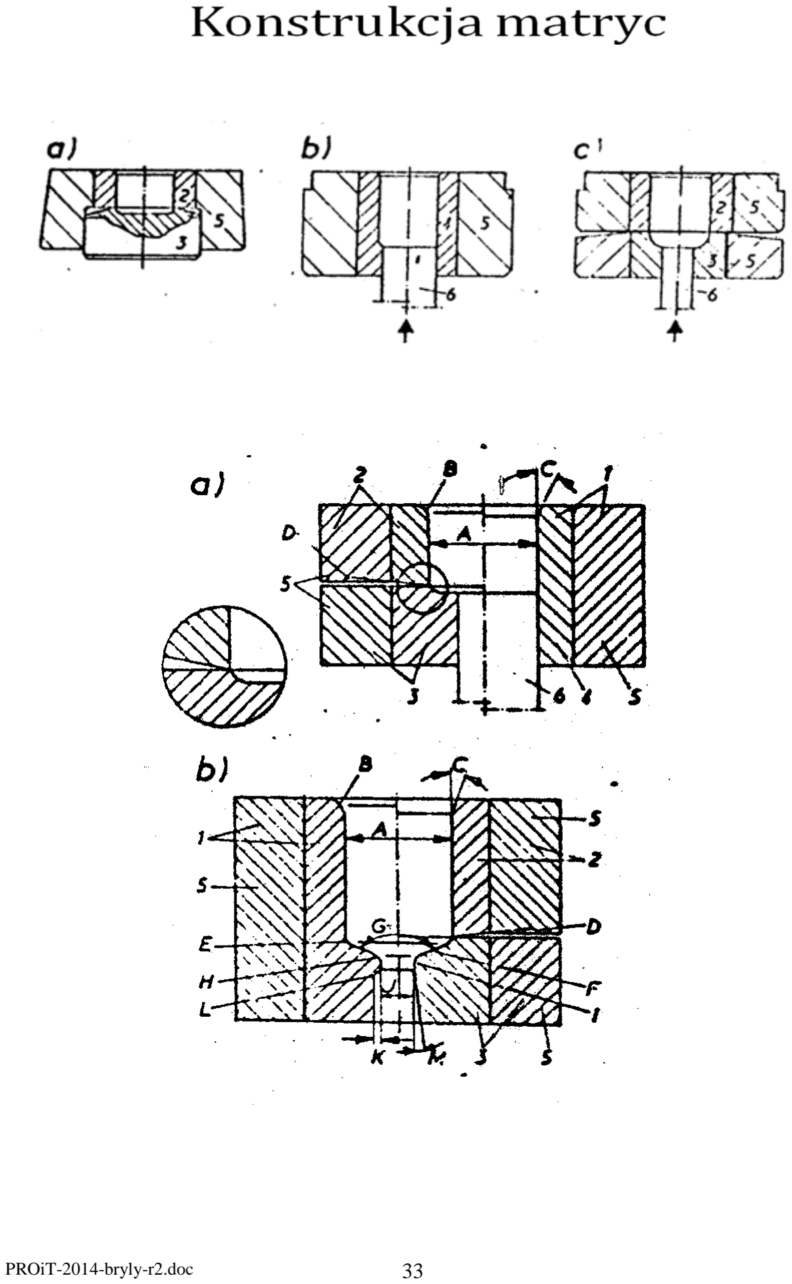
[picture p41: page 33]
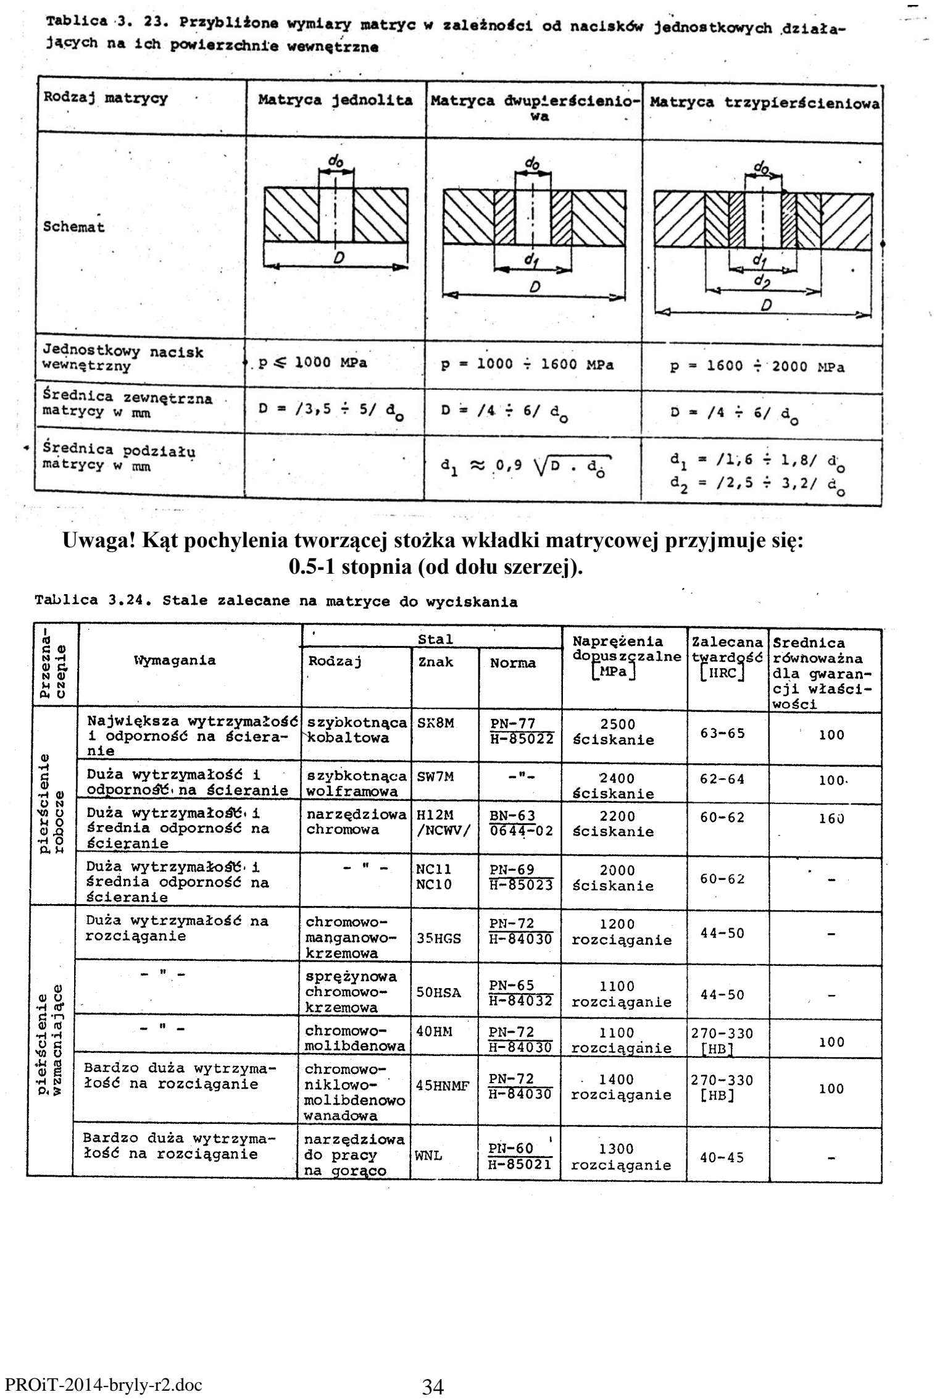
[picture p42: page 34]

Uwaga! Kąt pochylenia tworzącej stożka wkładki matrycowej przyjmuje się: 0.5-1 stopnia (od dołu szerzej).

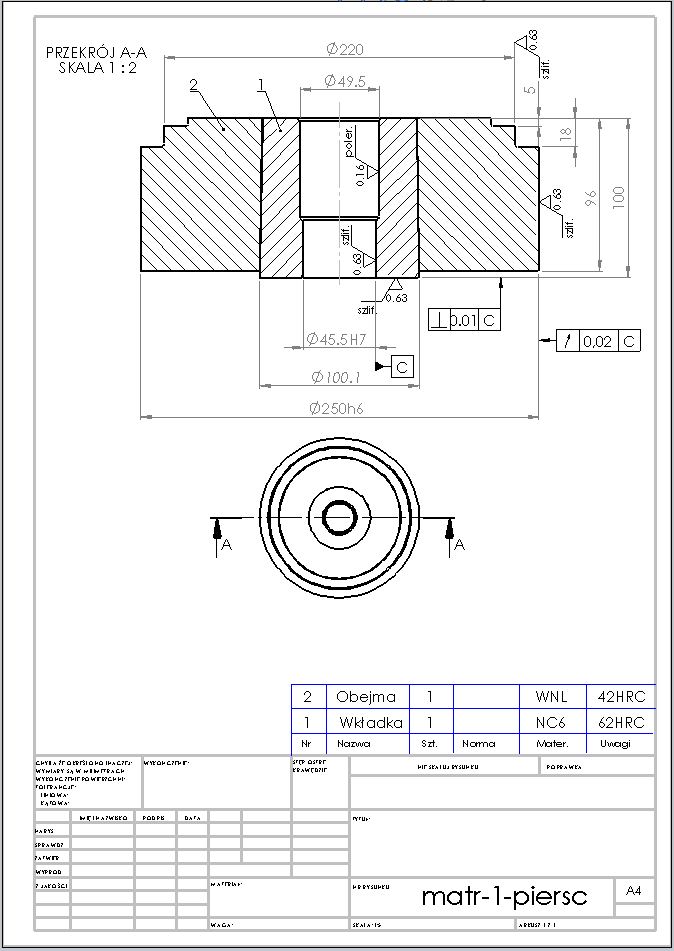
[picture p43: figure]

Przedstawiony powyżej rysunek wykonawczy jest rysunkiem odnoszącym się do końcowych wymiarów zmontowanej matrycy. Proces montażu powoduje nieznaczne i trudne do przewidzenia zmiany jej wymiarów. Po montażu następuje więc korekta ostatecznym szlifowaniem.

Konstrukcja przyrządów

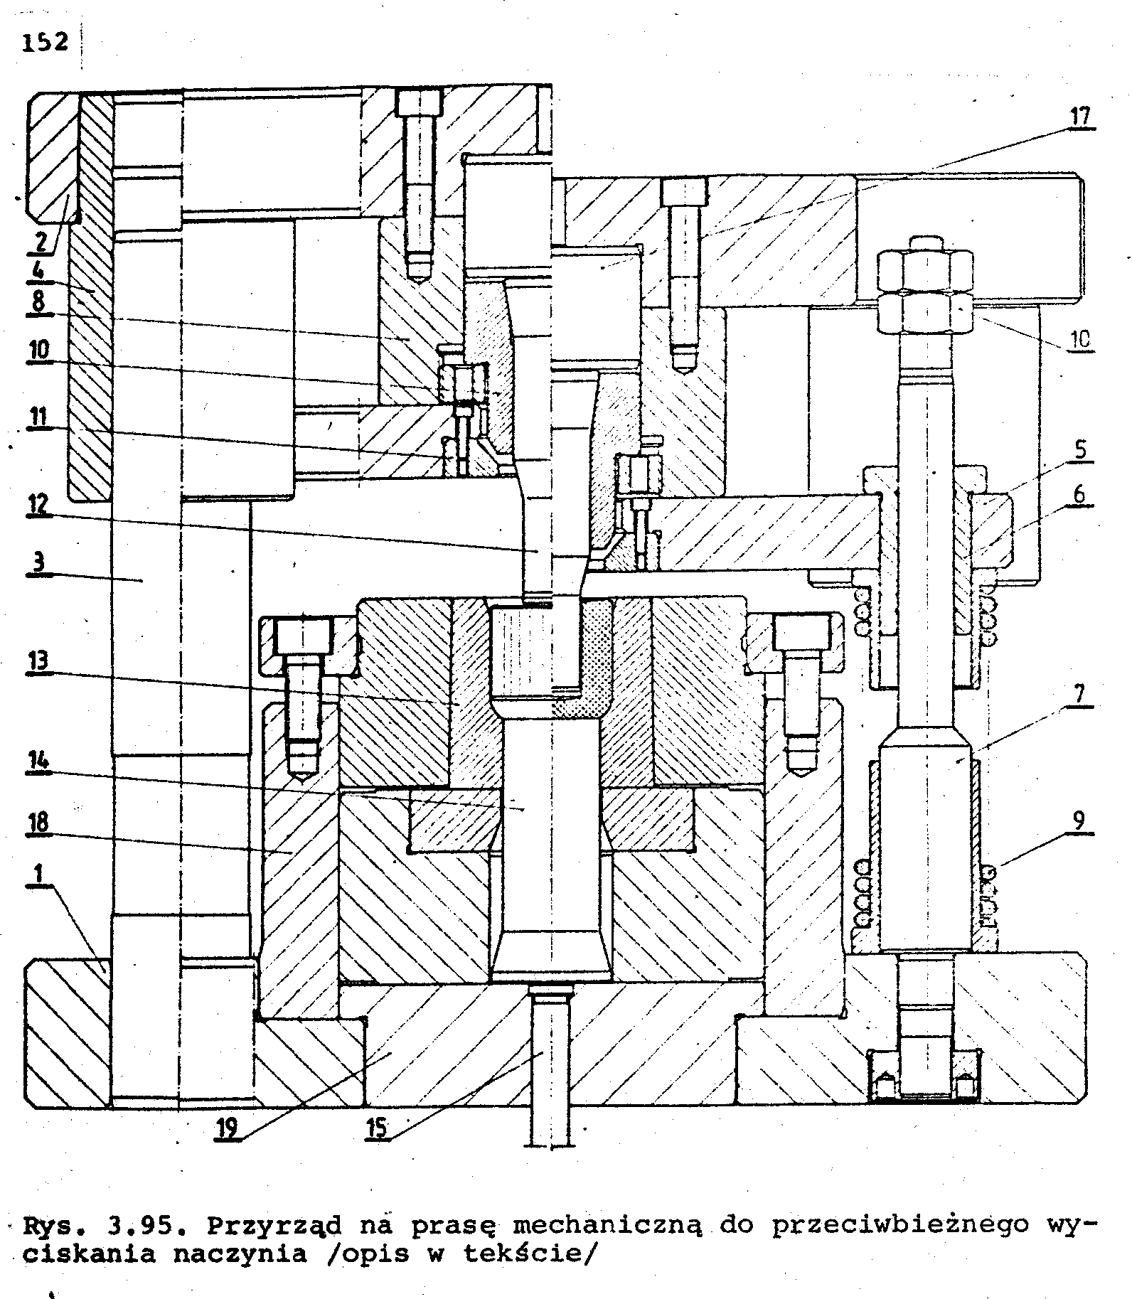
[picture p44: figure]

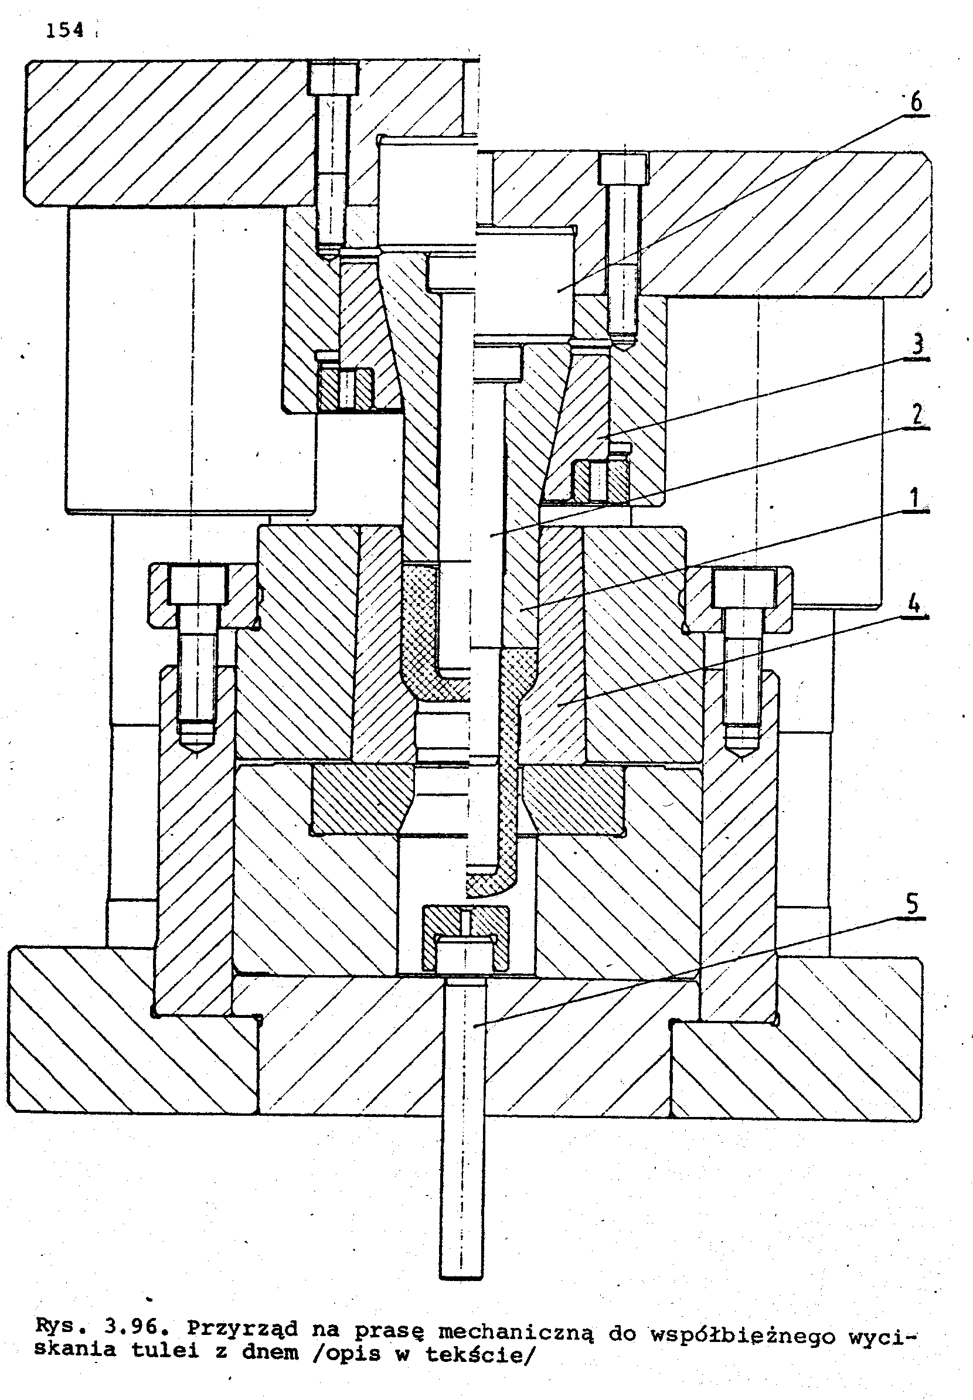
[picture p45: figure]

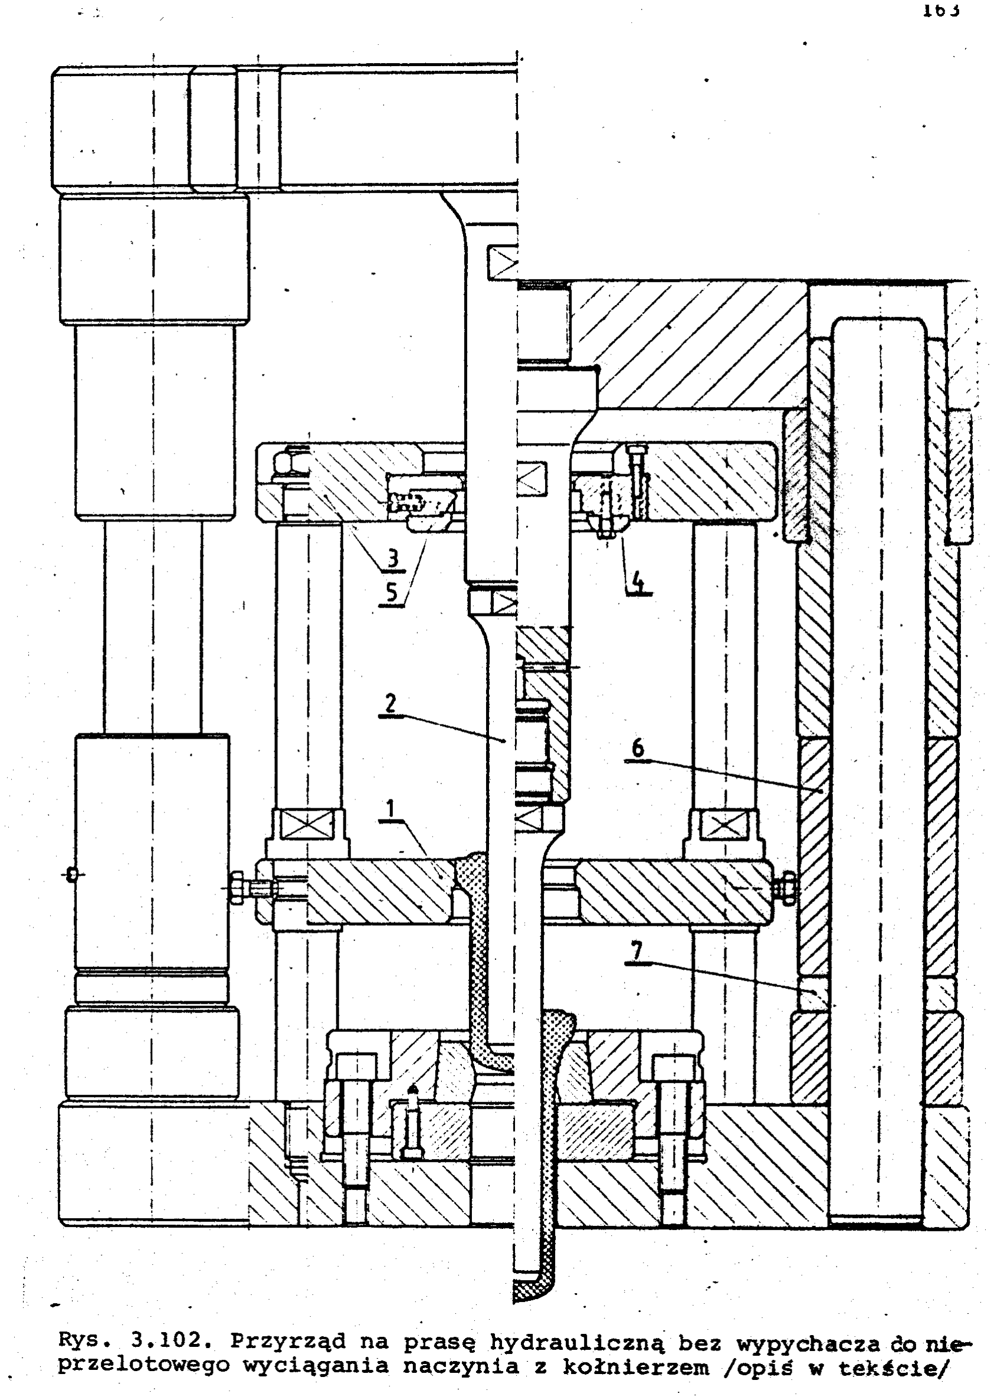
[picture p46: figure]

# Przykładowy projekt

# Wypraska typ WN3

### 1 Dane wstępne

Wyrób – wypraska naczyniowa

Typ wypraski – WN 3

- Średnica zewnętrzna w części kołnierza – d1=50 mm
- Średnica zewnętrzna wypraski - d2 = 45mm
- Średnica wewnętrzna wypraski - d3 = 40mm
- Wysokość całkowita wypraski – h1 = 90 mm
- Wysokość kołnierza – h2 = 15mm
- Grubość dna – g = 8mm

Materiał S10C (stal niskowęglowa)

Stal S10C charakteryzuje się krzywą umocnienia: σp=580•ε

0,28

### 1.1 Rysunek gotowego wyrobu

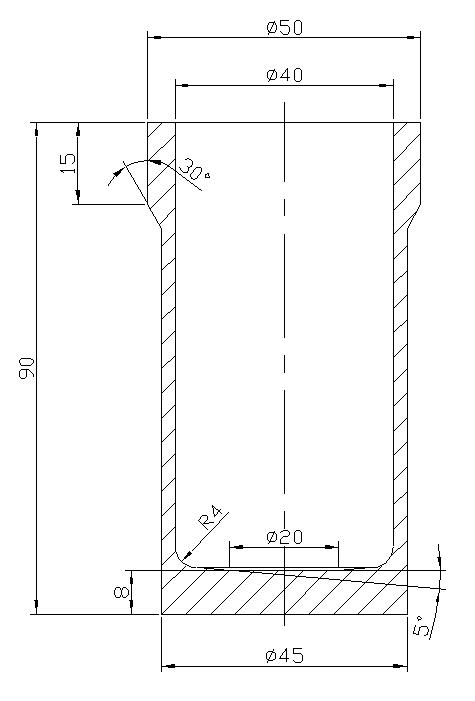
[picture p47: figure]

Rys. 2. Rysunek wykonawczy wypraski naczyniowej

### 1.2 Dobranie procesów technologicznych

Aby uzyskać gotowy wyrób należało rozważyć zastosowanie procesu wyciskania przeciwbieżnego naczynia, a następnie proces wyciskania współbieżnego. Naczynie otrzymane w procesie wyciskania przeciwbieżnego powinno mieć średnicę wewnętrzną dw równą średnicy wewnętrznej gotowego wyrobu ( z zachowaniem luzu dla wykonania operacji wyciskania współbieżnego), a średnicą zewnętrzną równą średnicy zewnętrznej kołnierza wyrobu (pomniejszonej o luz umożliwiający włożenie do matrycy w przyrządzie do wyciskania współbieżnego)

### 2 Założenia do projektu procesu plastycznego kształtowania na zimno

W celu zaprojektowania procesu kształtowania plastycznego obliczono objętość gotowego wyrobu, wysokość wstępniaka, oraz dobrano najmniejszą liczbę operacji.

### 2.1 Obliczanie objętości wypraski

### 2.1.1 Obliczanie objętości gotowego wyrobu (V)

Obliczono objętość gotowego wyrobu (na podstawie modelu 3d)
V= 46478 mm³

### 2.1.2 Obliczanie objętości wypraski z której ukształtowano gotowy wyrób (V wypraski 1)

Z uwagi na zachodzący proces wyżarzania rekrystalizacyjnego i straty na utlenianie powiększono objętość materiału, z którego zostanie ukształtowany wyrób o 5%.
V wypraski 1 = 1,05 V = 48802 mm³
2.1.3 | Obliczanie | wysokości | wypraski | uzyskanej | w | procesie | wyciskania
przeciwbieżnego (hg)

Wypraska uzyskana w procesie technologicznym zostaje poddana operacjom ścięcia naddatku wypraski oraz podtoczenia. Poniżej przedstawiono rysunek wypraski poddanej tym operacjom, z której zostanie wykonany wyrób gotowy. Wymiary jej obliczono z warunku stałej objętości.

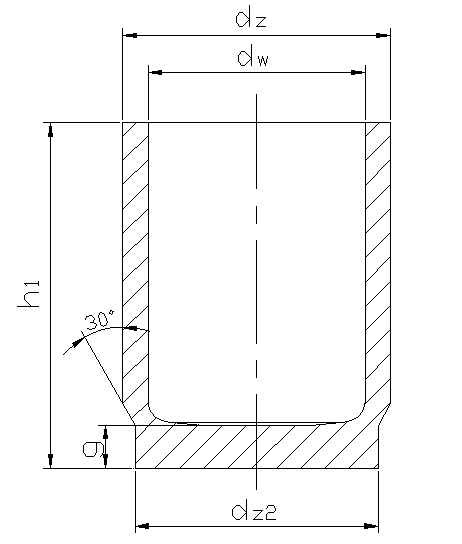
[picture p48: figure]

Rysunek 3. Rysunek wypraski przygotowanej do wyciskania współbieżnego.
W celu obliczenia wysokości wypraski założono wartości dz i dw, które powinny odpowiadać wymiarom gotowej wypraski w części kołnierzowej, z zachowaniem niezbędnych luzów dla wykonania wyciskania współbieżnego:

dz = 49,5 mm

dw = 40,2 mm

dz2=45 mm

g= 8 mm

Z warunku stałości objętości obliczono wysokość wypraski:

Wysokość wypraski wynosi: hg= 56 mm

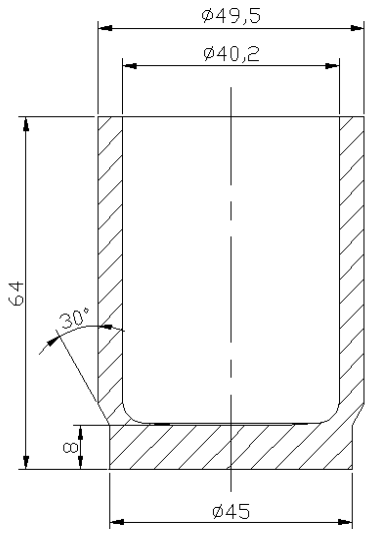
[picture p49: figure]

Rysunek 4. Rysunek wypraski przygotowanej do operacji wyciskania współbieżnego.

### 2.1.3 Obliczanie objętości wypraski uzyskanej w wyniku wyciskania

przeciwbieżnego (Vwypraski2)

Ponieważ w wyniku procesu wyciskania przeciwbieżnego materiał wypływa do góry powstaje nierówna górna powierzchnia wyrobu, założono operacje planowania nierównej powierzchni.

Obliczono objętość naddatku, zakładając wysokość naddatku równą 3mm.

Vnaddatku= 1966 mm³

Aby wypraskę uzyskaną w operacji wyciskania przeciwbieżnego dalej kształtować w procesie wyciskania współbieżnego należy podtoczyć ją tak, aby możliwe było poprawne ułożenie w matrycy.

Obliczono objętość podtoczonego naddatku:

Vpodtoczenia=5902 mm³

Poniżej pokazano rysunek wypraski uzyskanej w wyniku operacji wyciskania przeciwbieżnego, przed operacjami usunięcia naddatku i podtoczenia.

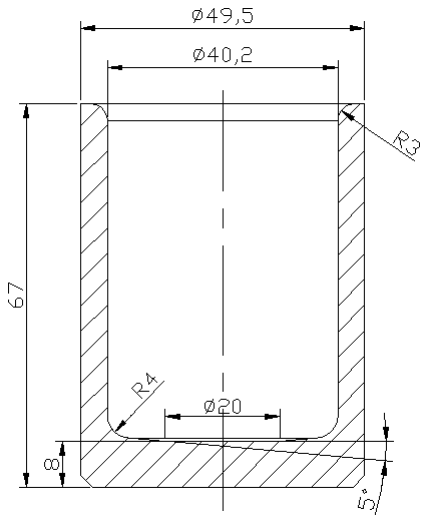
[picture p50: figure]

Rysunek 5. Wypraska uzyskana w wyniku procesu wyciskania przeciwbieżnego wraz z naddatkami. Objętość powyższej wypraski wynosi:

Vwypraski2=56670 mm³

### 2.1.3 Obliczanie wysokości wstępniaka (h0)

Założono średnicę wstępniaka z uwzględnieniem luzu na włożenie do matrycy:
d0 = 49 mm oraz jednostronną fazę 2-45.

Obliczono wysokość wstępniaka z warunku stałej objętości:

Vw=Vwypraski2 h0 = 30mm

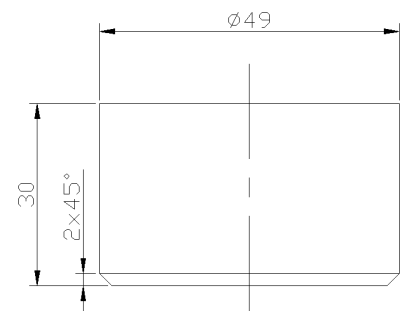
[picture p51: figure]

Rysunek 6. Wstępniak.

### 2.2 Dobór liczby operacji

Aby | uzyskać | wymagany | wyrób | należy | zastosować | operacje | wyciskania
przeciwbieżnego, ścięcia naddatku, podtoczenia oraz wyciskania współbieżnego. Poniżej rozpatrzono warunki wykonania operacji wyciskania przeciwbieżnego i współbieżnego.

### 2.1.3 Operacja wyciskania przeciwbieżnego

Aby wypraska została wykonana w jednej operacji musi być spełniony warunek względnej

głębokości gniazda wypraski:
≤ 1,8
d

h

s

g

1,39
40,2

56
= | =
d

h

s

g

Warunek został spełniony.
Ponadto odkształcenie względne procesu nie może przekroczyć wartości dopuszczalnych

εAproc≤εAdop

100 | 100 66% | 70%
49,5

40,2

2

2

2

0

2
ε = | · | = | · | = | < ε = Adop

s
A
d

d

Warunek został spełniony. Wypraska zostanie wykonana w jednej operacji.

### 2.1.3 Operacja wyciskania współbieżnego

Aby wypraska mogła być wykonana w jednej operacji musi być spełniony następujący warunek: εproc≤εdop

ln | ln | 0,75
45 40,2

50 40

2 | 2
2 | 2
2 | 2

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
d | d
z | w
z | w
ε proc

### εdop=1,2

Warunek został spełniony

### 3 Obliczenia do poszczególnych operacji

W kolejnej części projektu wykonano obliczenia odkształcenia plastycznego, wartości sił kształtowania, jednostkowych nacisków oraz pracy plastycznego odkształcenia dla przewidywanych operacji.

### 3.1 Operacja wyciskania przeciwbieżnego

### 3.1.1 Obliczenie odkształcenia plastycznego

Odkształcenie w mierze logarytmicznej:

ln | ln | ln 2,9 1,08
49,5 40,2

49,5

2 | 2

2

2 | 2

0

2
0 | = | =

=

=
d d

d

s

ε procesu

### 3.1.2 Obliczenie siły kształtowania (P)

η

W
P Ap
=

W – praca jednostkowa odkształcenia plastycznego η - sprawność procesu
Ap – przekrój wypychacza (na niego działa siła) Ap=A0 – dla operacji wyciskania przeciwbieżnego gdzie A0 – przekrój otworu matrycy
A | d | 49,5 1924mm
2 | 2 | 2
0 | 0 4 | 4
= | · | = | · | =
π | π

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
+ | +
mm

Nmm
n

c
w

n
3
1 | 0,28 1
500
1 0,28

580
1
ε | 1,08

Uwzględniając ε=1,08
Na podstawie wykresu z [1] : η=0,48;

0,61
49

30

0

0
= =
d

h

Siła w operacji wyciskania przeciwbieżnego będzie równa:

2004167[ ] 2004[ ]
0,48
500 P =1924· | = | N = | kN

### 3.1.3 Obliczenie nacisków na matrycę (pm) i na stempel (ps)

Obliczenie nacisków na matrycę (pm)

MPa W
pm
1042
0,48

500
= | = | =
η
Ponieważ pm >1000 – stosujemy jeden pierścień wzmacniający [1] D= (4÷6) d0
D=(198 ÷294) mm
Założono w przyrządzie gniazdo pod matrycę o średnicy 250 mm
Następnie obliczono średnicę podziałową między pierścieniem roboczym i wzmacniającym:
0,9 | 99,6 100[ | ]
1 | 0 d = | D·d = | ≅ | mm

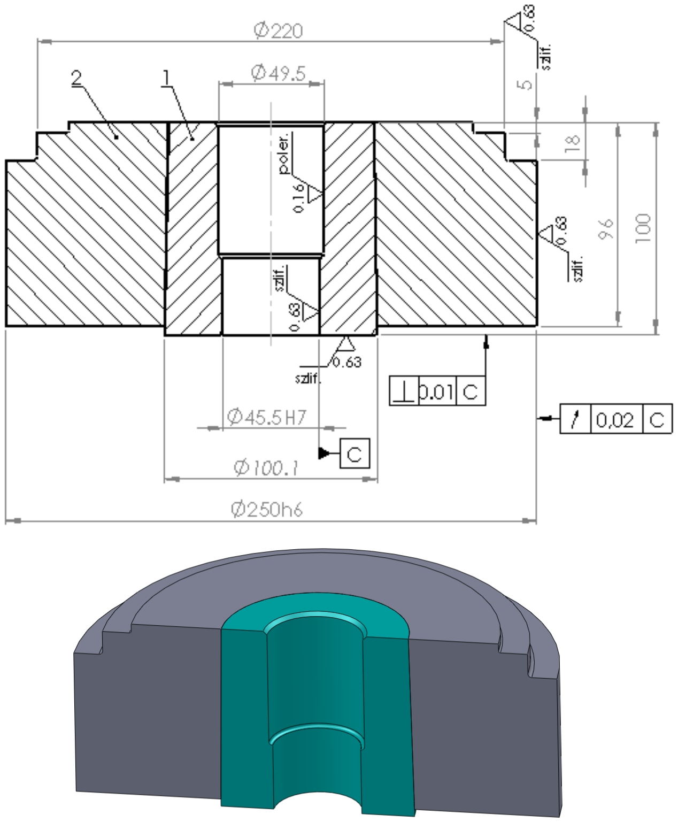
[picture p52: figure]

Rysunek 7. Matryca do wyciskania przeciwbieżnego.

Obliczenie nacisków na stempel (ps) Z warunku równowagi sił:

MPa
d

d
p p

s

s | m
1042 | 1596
40

49,5

2

2

2

2

0
= | = | =

gdzie psdop =1600 MPa przy wykonywaniu 20 000 sztuk wyrobu (z uwzględnieniem wytrzymałości zmęczeniowej stempla)

### 3.2 Operacja wyciskania współbieżnego

### 3.2.1 Obliczenie odkształcenia plastycznego

Odkształcenie w mierze logarytmicznej:
εproc=0,75
3.2.2 Obliczenie siły kształtowania (P) w opercji wyciskania współbieżnego.

η

W
P Ap
=

Przekrój na który działa siła :
Ap

## (dz d w

) (50 40 ) 707mm
2 | 2 | 2 | 2 | 2
4 | 4
= | - | = | - | =
π | π

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
+ | +
mm

Nmm
n

c
w

n
3
1 | 0,28 1
313,6
1 0,28

580
1
ε | 0,75

η=0,56

396[ ]
0,56

313,6
P = 707 · | = | kN

### 3.2.3 Obliczenie nacisków na matrycę (pm) i na stempel (ps)

Dla wyciskania współbieżnego pm = ps
Obliczenie nacisków na matrycę:
MPa W
pm
| | 560
| 0,56

313,6
= | = | =
η
pm = ps =560 MPa

### 3.3 Obliczenie pracy całkowitej

Pracę obliczono ze wzoru:
L = P sr

### 3.3.1 Obliczenie pracy przy wyciskaniu przeciwbieżnym

Do obliczenia pracy wyznaczono wielkość skoku roboczego: sr = h0 – gd = 30 – 8 =22 mm
L = 2004167 22 = 44092 J = 44,09 kJ

### 3.3.1 Obliczenie pracy przy wyciskaniu współbieżnym

sr = h – h1 = 56 – 15 = 41 mm
L= 3 6 000 41 = 16236 J = 16,236 kJ

### 3.4 Plan operacyjny

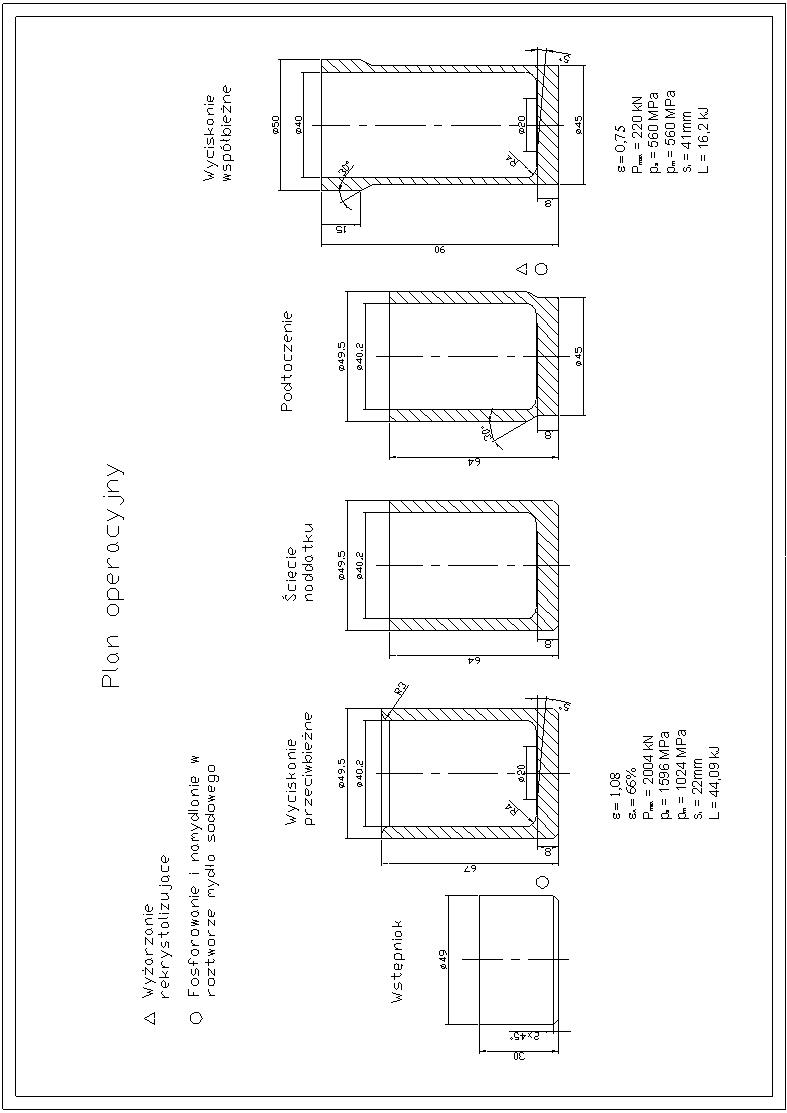
[picture p53: page 47]

Rys.8 Plan operacyjny

### 3 Technologiczny schemat realizacji wyciskania przeciwbieżnego

### 4.1 Rysunek narzędzia : matrycy i stempla

W celu zaprojektowania stempla przyjęto następujące założenia [1]:
h1 ≥ wysokości naczynia
h1 ≥ 67 mm
przyjęto:
h1 = 80 mm
ds – średnica stempla
ds = 40mm
Dane do narysowania matrycy zostały obliczone w punkcie 3.1.3.

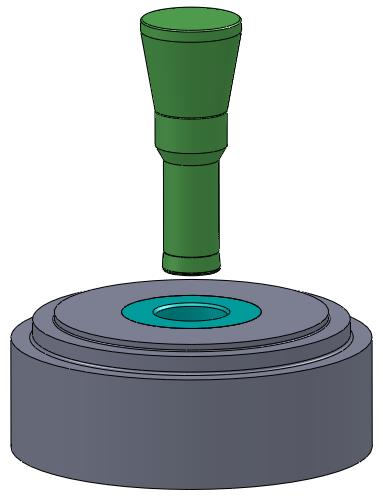
[picture p54: figure]

Rys.9. Konstrukcja stempla i matrycy

Rys. 10. Matryca składana

Rys. 11. Stempel

Projektowanie przyrządu

Przyrządy służą do posadowienia narzędzi, i wzajemnego ich pozycjonowania w trakcie realizacji operacji. Najczęściej składa się je, odpowiednio do potrzeb z dostępnych na rynku elementów. Przyrząd składa z płyty dolnej, w której mocowana jest matryca i wypychacz, płyty górnej, w której mocowany jest stempel oraz płyty ściągacza, w której mocowany jest ściągacz. Wzajemne pozycjonowanie płyt zapełniają słupy i prowadnice. Ilość słupów i rodzaj ich prowadzenia zależy od prowadzonego procesu, dostępnej maszyny itp. Przykłady płyt oferowanych przez jednego z producentów oraz jednego ze sposobów prowadzenia pokazane są na rys. 1.

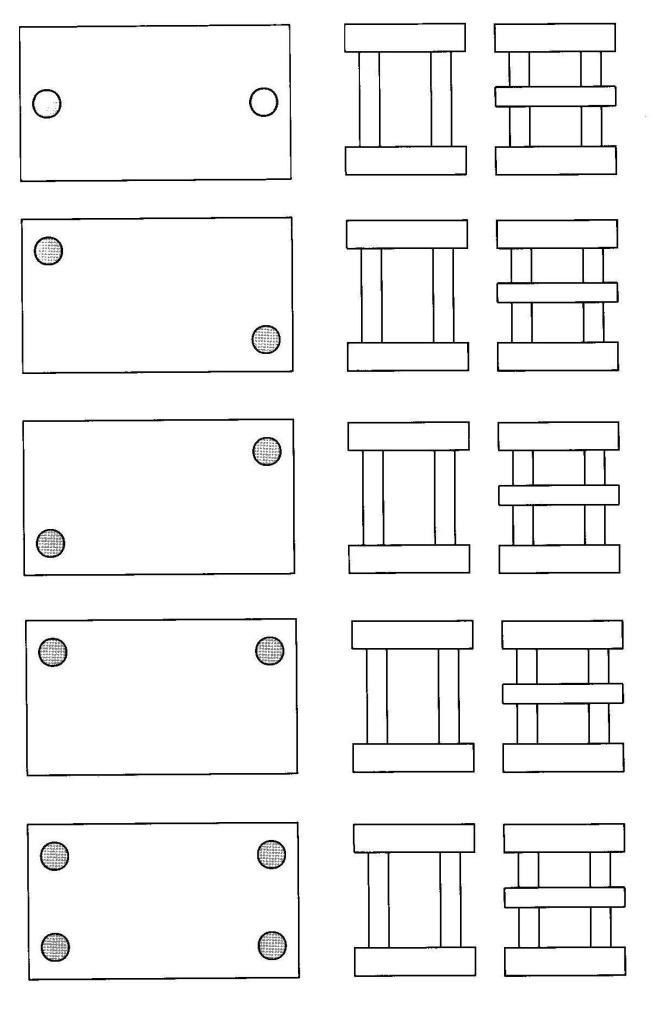
[picture p55: figure]
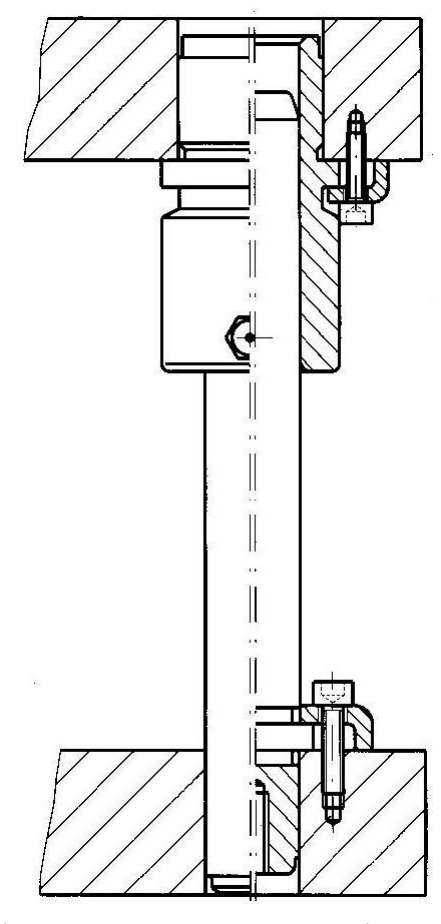
[picture p56: figure]

Rys. 12. Przykłady płyt i jeden ze sposobów ich wzajemnego prowadzenia

W projekcie należy zaprojektować (model 3d) przyrząd będący miejscem posadowienia narzędzi: stempla i matrycy oraz zapewniający wzajemne ich pozycjonowanie. W przyrządzie tym ma być realizowana operacja wyciskania przeciwbieżnego naczynia. Przebieg tej operacji oraz obowiązująca konstrukcja przyrządu pokazuje rys. 2.

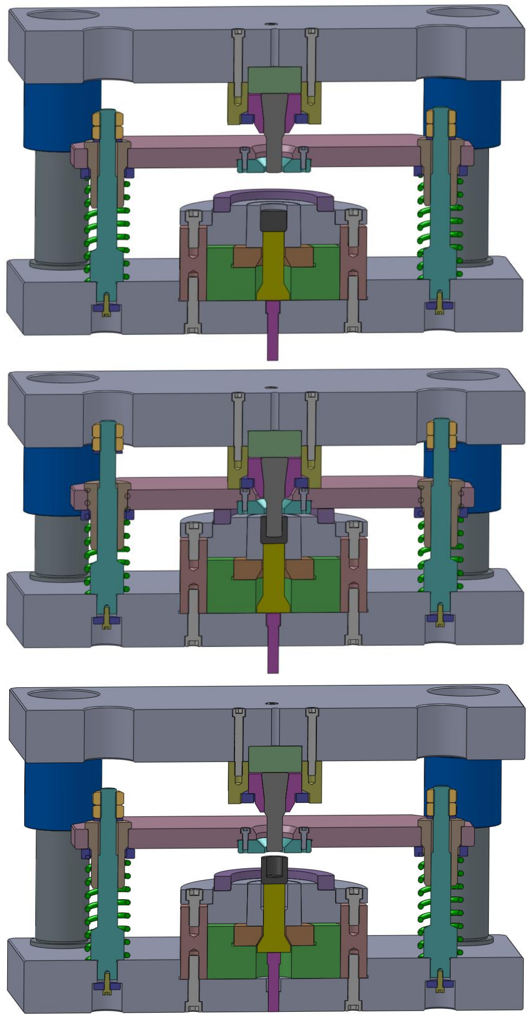
[picture p57: figure]

Rys.13. Operacja wyciskania przeciwbieżnego naczynia: załadowanie wstępniaka (górne położenia suwaka prasy), wyciśnięcie naczynia (dolne położenie suwaka prasy), wycofanie stempla z jednoczesnym wypchnięciem naczynia z matrycy i zepchnięciem naczynia ze stempla

W sposób dokładny (tak jak do wykonania) mają być zaprojektowane narzędzia oraz ich posadowienia. Oznacza to, zaprojektowanie wszystkich elementów włącznie ze śrubami, kołkami, podkładkami itp. Poszczególne części mają mieć podcięcia obróbkowe, fazy, promienie, gwinty itp. Na rys. 3 pokazane są posadowienia, których wszystkie części mają być zaprojektowane szczegółowo (3d – do wykonania).

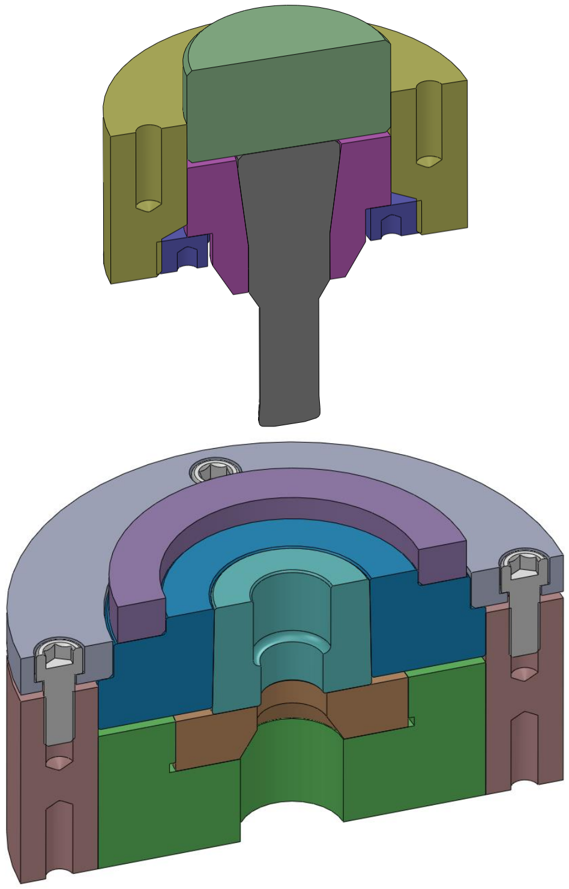
[picture p58: figure]

Rys. 14. Posadowienia stempla i matrycy (obowiązuje konstrukcja dokładna – śruby, podcięcia, fazy)

Przyrząd, w którym umieszczone mają być posadowienia z narzędziami należy otrzymać od prowadzącego w formie złożenia 3d umozliwiającego realizacje ruchów roboczych, kolizji itp.

### 4.2 Ruch narzędzia dla operacji wyciskania przeciwbieżnego

Podstawą do wyznaczenia niezbędnych do ustawienia prasy ruchów procesu jest symulacja pracy przyrządu w przestrzeni programu. Zapisem skrajnych położeń przyrządu jest rysunek zbiorczy (rys.4). Na nim zaznacza się poszukiwane wymiary to znaczy: gabaryty przyrządu w górnym położeniu (H, A, B), skok prasy (S), ruch roboczy (Sr), ruch wypychacza (Sw).

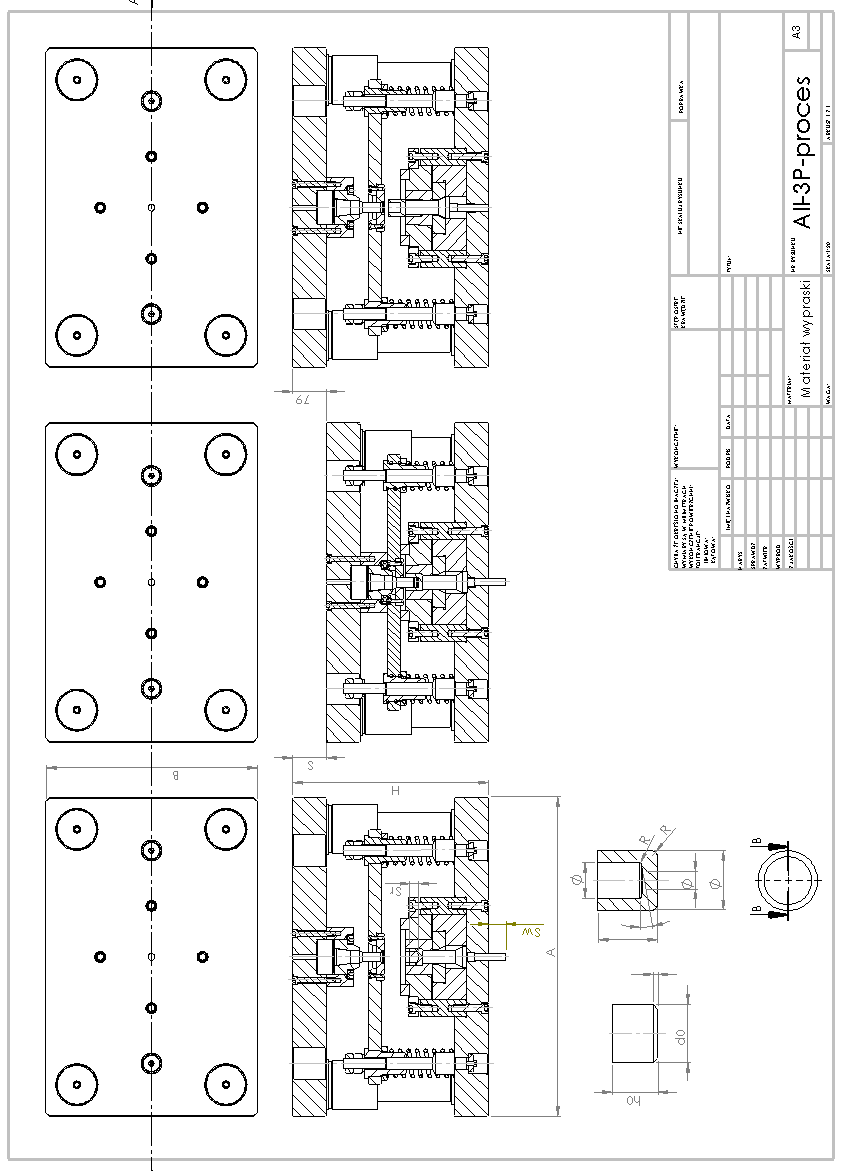
[picture p59: figure]

Rys.15. Proces wyciskania przeciwbieżnego

### 4.2.1 Wyznaczenie skoku prasy dla operacji wyciskania przeciwbieżnego

Skok prasy wyznaczony z symulacji ruchów przyrządu rys.4.

S = 128 mm. Skok prasy.
Sr=22 mm. Skok roboczy, w czasie którego występuje siła procesu - konieczny do wyznaczenia pracy procesu).

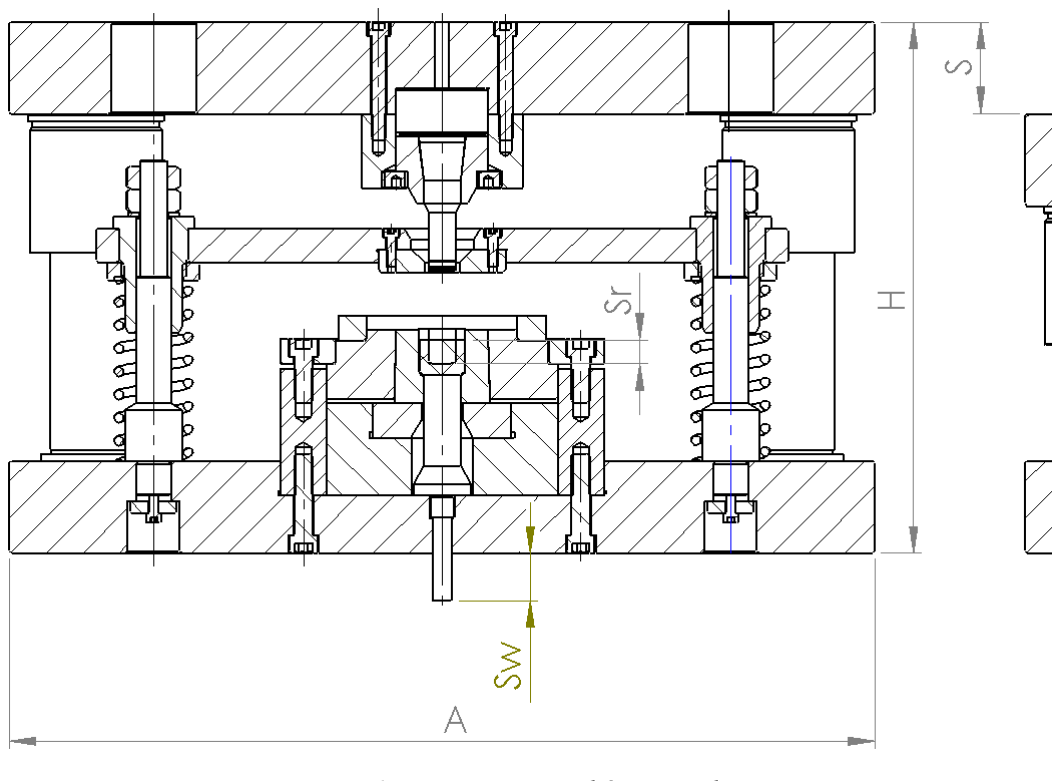
[picture p60: figure]

Rys.16. Wyznaczenie ruchów narzędzi

### 4.2.2 Wyznaczenie skoku wypychacza dla operacji wyciskania przeciwbieżnego

Skok wypychacza maszyny musi być wystarczająco duży, aby usunąć wypraskę z przyrządu, rys.5. W przypadku wyciskania przeciwbieżnego wynosi on:
sw = 64 mm

Dobór prasy

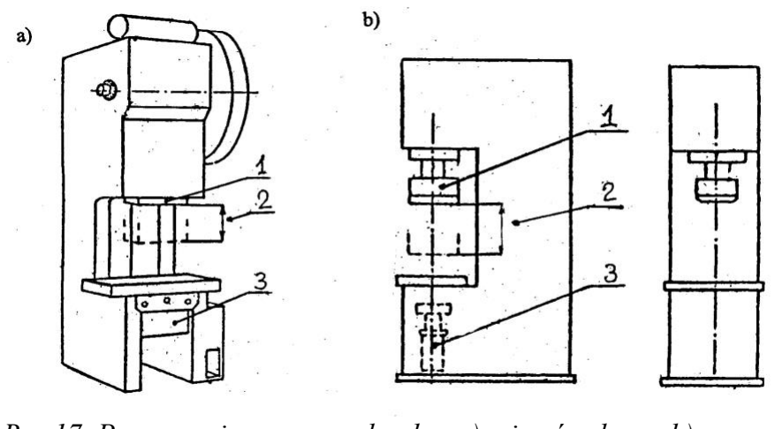
[picture p61: figure]

Tablica 12a. Parametry wybranych pras mimośrodowych
Wielkość | Symb. | Jedn. | Typ prasy
| | | PMS10 C | PMS16 C | PMS25 C | PMS40 C | PMS63 C | PMS10 0D | PMS16 0B
Nacisk nominalny | Pn | kN | 100 | 160 | 250 | 400 | 630 | 1000 | 1600
Wysięg | W | mm | 160 | 180 | 220 | 250 | 280 | 315 | 400
Skok nastawny suwaka | S | mm | 6-70 | 6-80 | 8-90 | 8-100 | 8-110 | 10-110 | 20-140
Liczba skoków | ns | 1/min | 160;180 | 140;165 | 80;115; 145 | 60;90; 120 | 65;85; 110 | 60 | 40
Odl. suwaka od stołu dla R=0 i Smax | O | mm | 270 | 220 | 250 | 280 | 315 | 305 | 440
Nastawność suwaka | R | mm | 56 | 63 | 70 | 80 | 90 | 85 | 120
Wymiary stołu | BxL | mm | 430X31 5 | 500x355 | 630x450 | 710x500 | 800x560 | 900x620 | 1140x76 0
Średnica otworu w stole | D/D1 | mm | 140/160 | 160/180 | 200/220 | 220/250 | 250/280 | 325/365 | 450/490
Grubość płyty mocującej | H | Mm | 56 | 63 | 70 | 80 | 90 | 100 | 125
Średn. otw. w płycie mocuj. | D2 | Mm | 60 | 80 | 100 | 110 | 120 | 180 | 250
Średnica otw. W suwaku | d | mm | 25 | 32 | 32 | 40 | 40 | 50 | 50
Praca użytec zna | Ruch poj. | | kGm | 40 | 45 | | | 230 | 240 | 1200
| Ruch ciągły | | kGm | 45 | 20 | | | 120 | 120 | 660
wypyc hacz | Nacisk | | kN | 10 | 16 | 16 | | 63 | 49 | 160
| Skok | | mm | 30 | 35 | | | 50 | 50 | 75

Rys.17. Prasa wysięgowa z poduszką: a) mimośrodowa, b) hydrauliczna, 1-suwak, 2-skok suwaka, 3-poduszka

`
+Tablica 12b - Parametry wybranych pras hydraulicznych
Wielkość | Wiel. | Jedn. | Model prasy PYE S/1-M
10 | 25 | 40 | 63 | 100 | 160 | 250
Nacisk | Pn | | 100 | 250 | 400 | 630 | 1000 | 1600 | 2500
Siła powrotu | Pp | | 21 | 50 | 85 | 100 | 200 | 340 | 380
Prędkość stempla Odjazd Średnia Dojazd | | Mm/s | 110 | 115 | 110 | 63 | 320 | 200 | 210
| | | 42 | 32 | 26 | 18 | 14 | 9 | 9
| | | 450 | 450 | 450 | 380 | 200 | 125 | 110
Skok | S | Mm | 400 | 500 | 500 | 500 | 500 | 500 | 500
Wysięg | | Mm | 250 | 360 | 360 | 360 | 360 | 360 | 360
Wys. Zabudowy | | Mm | 630 | 800 | 800 | 800 | 800 | 800 | 800
Wym. Stołu [A x B] | A | Mm | 500 | 630 | 630 | 750 | 750 | 900 | 900
| B | | 400 | 500 | 500 | 560 | 560 | 630 | 630
Kanały T stołu | | Mm | 18 | 18 | 22 | 22 | 22 | 22 | 28
Śr. Otwóru stołu C | | Mm | 140 | 180 | 200 | 200 | 200 | 200 | 200
Wys. Stołu od podłoża | | Mm | 710 | 710 | 710 | 710 | 710 | 800 | 800
Wym. Suwaka [D x E] | D | Mm | 360 | 450 | 450 | 530 | 530 | 750 | 750
| E | | 280 | 360 | 360 | 400 | 400 | 450 | 450
Otw. cent. w suwaku | d | Mm | 25 | 32 | 40 | 40 | 50 | 50 | 65
Kanały T w suwaku | K | Mm | - | 18 | 22 | 22 | 22 | 22 | 28
Podłączenie | | kW | 5,25 | 8,75 | 12,6 | 12,6 | 16,6 | 16,6 | 20,1
Masa własna | | Kg | 1300 | 2200 | 3150 | 4100 | 5040 | 7000 | 8000
Gabaryty prasy Szerokość Głębokość Wysokość | | Mm | 1000 | 1000 | 1100 | 1150 | 1150 | 1250 | 1250
| | Mm | 1260 | 1550 | 1750 | 1850 | 1850 | 2200 | 2200
| | Mm | 2300 | 2650 | 2800 | 2950 | 3100 | 3450 | 3450

Tablica 13 a. Zalecane materiały na matryce i pierścienie wzmacniające

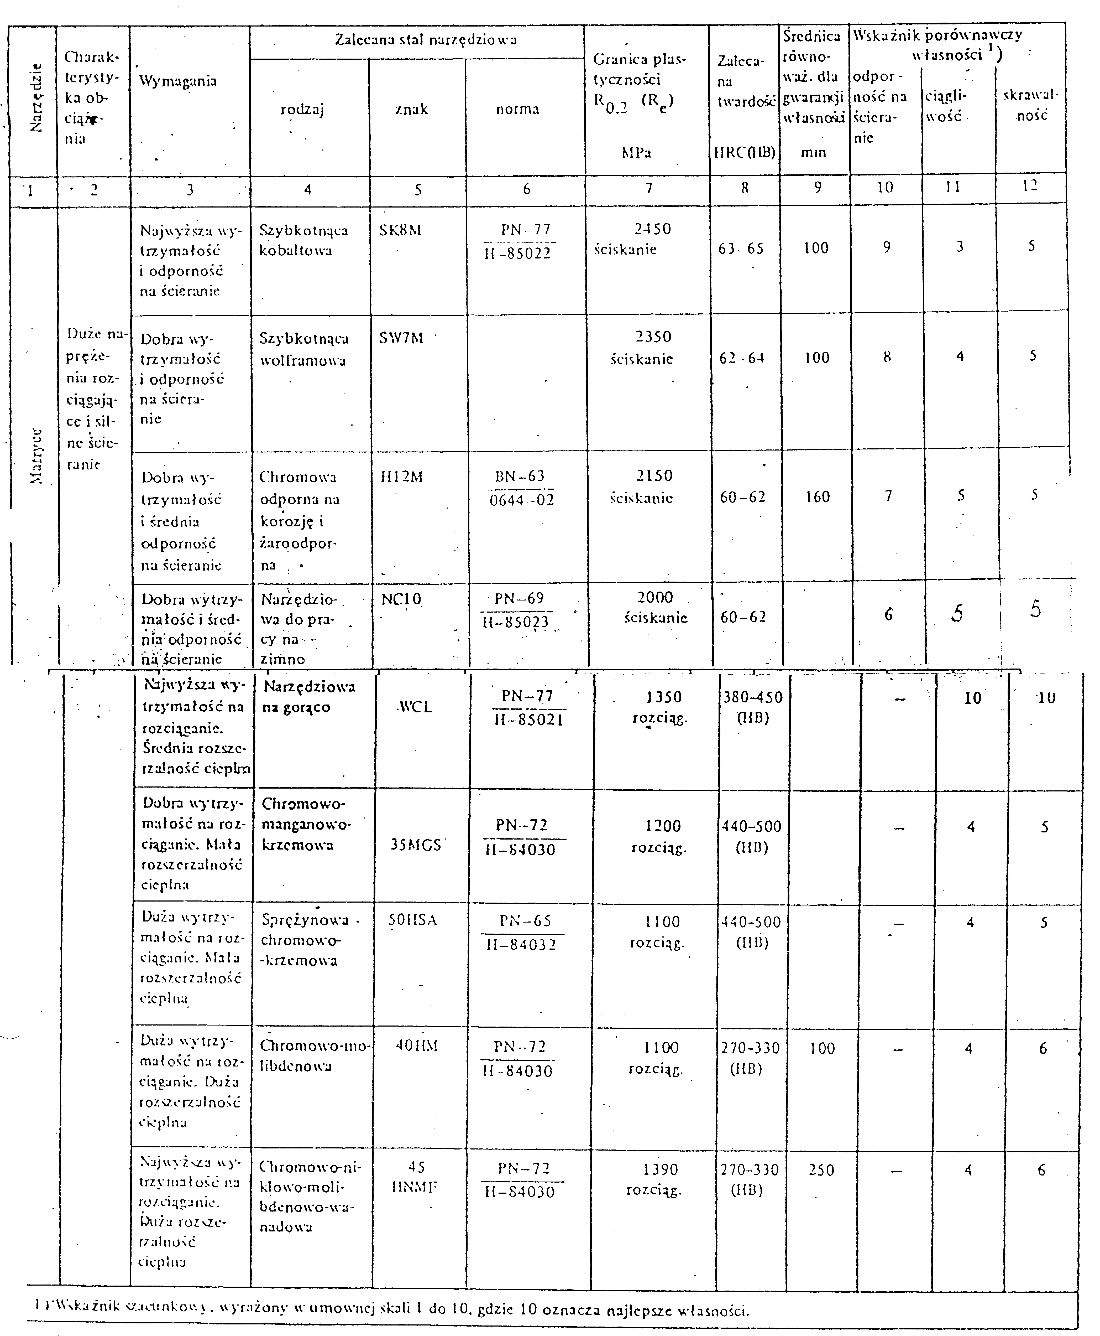
[picture p62: figure]

Tablica 13 b. Zalecane materiały na części tłoczników.

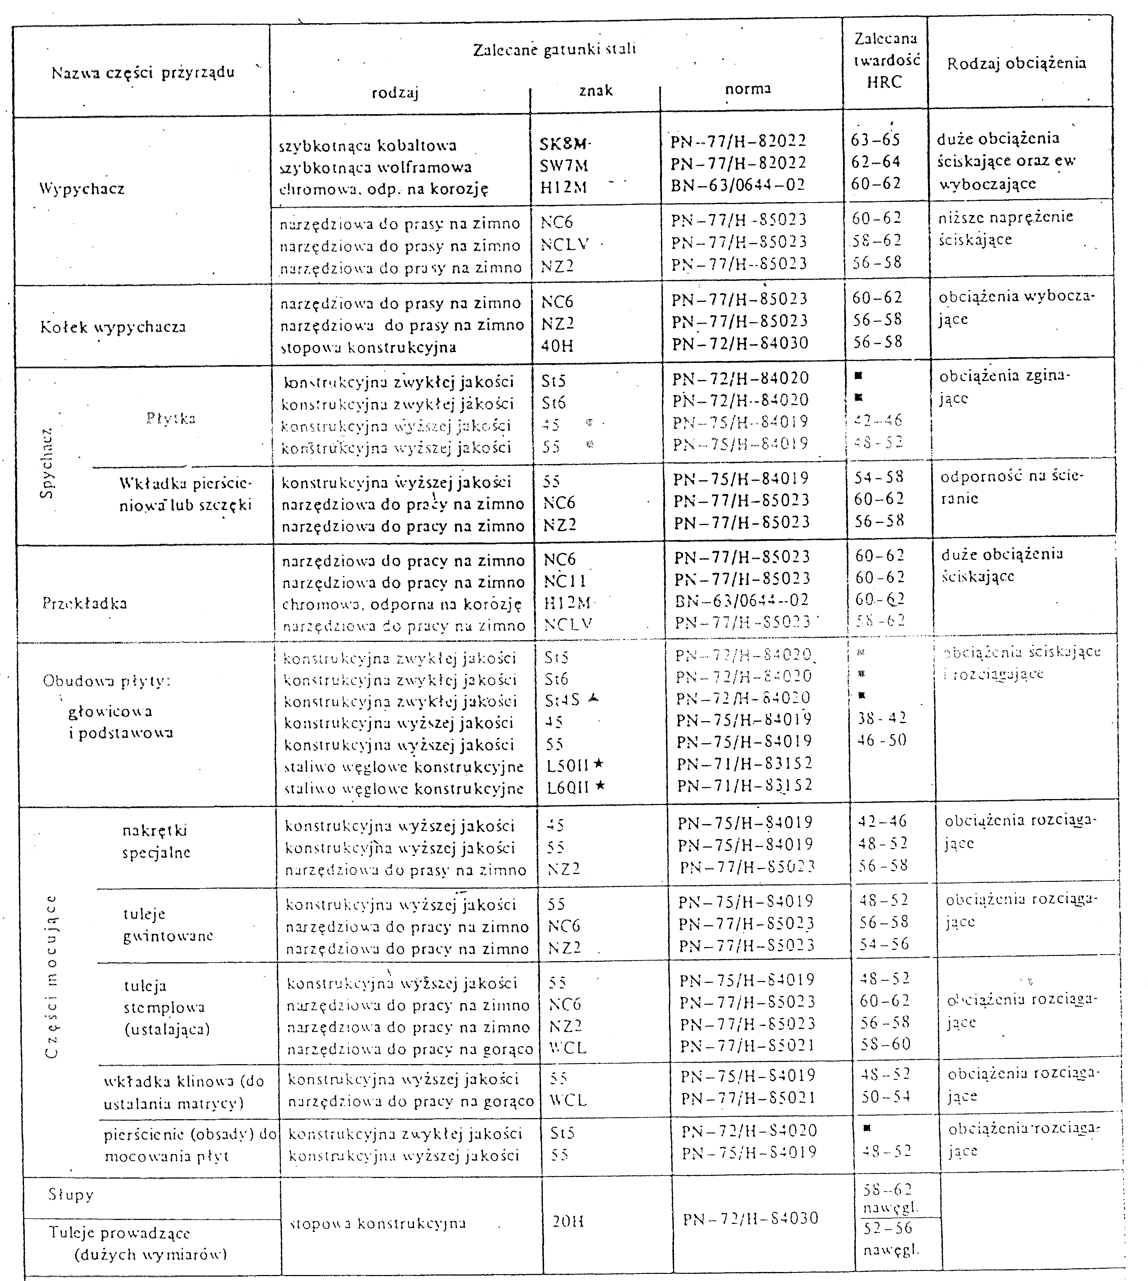
[picture p63: figure]
