ptymek/projekt_obpla_wip/SCREENY/DOLNA_PRZEKRÓJ.jpg

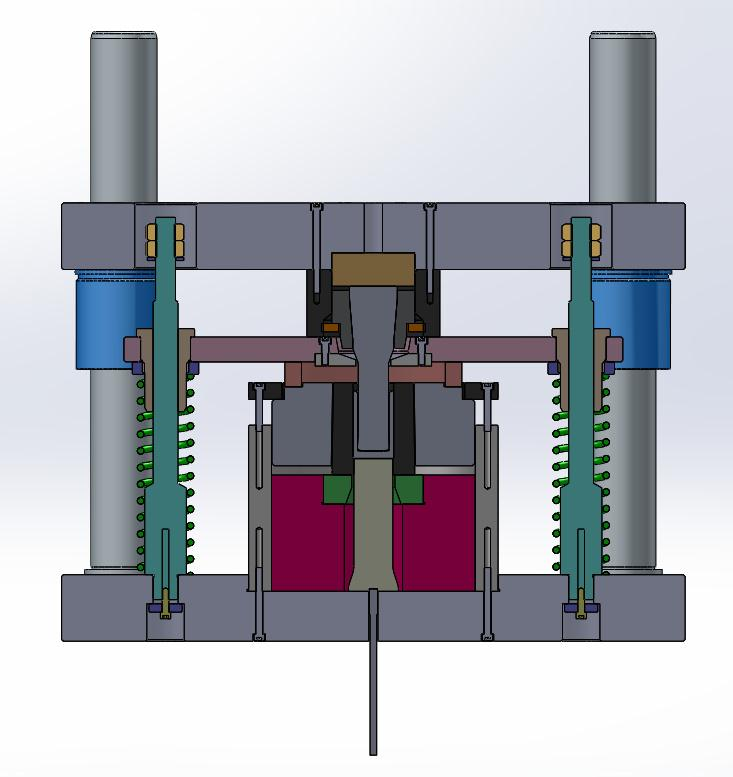
SCREENY/DOLNA_PRZEKRÓJ.jpg
