ptymek/projekt_obpla_wip/SCREENY/GÓRNA_PRZEKRÓJ.jpg

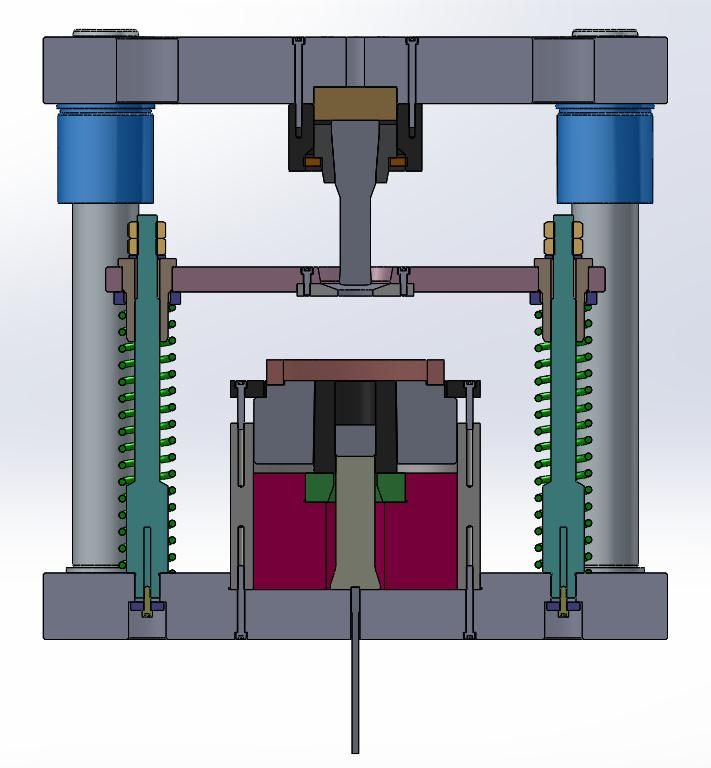
SCREENY/GÓRNA_PRZEKRÓJ.jpg
