ptymek/projekt_obpla_wip/SCREENY/POZYCJA_DOLNA_AKSJONOMETRIA.jpg

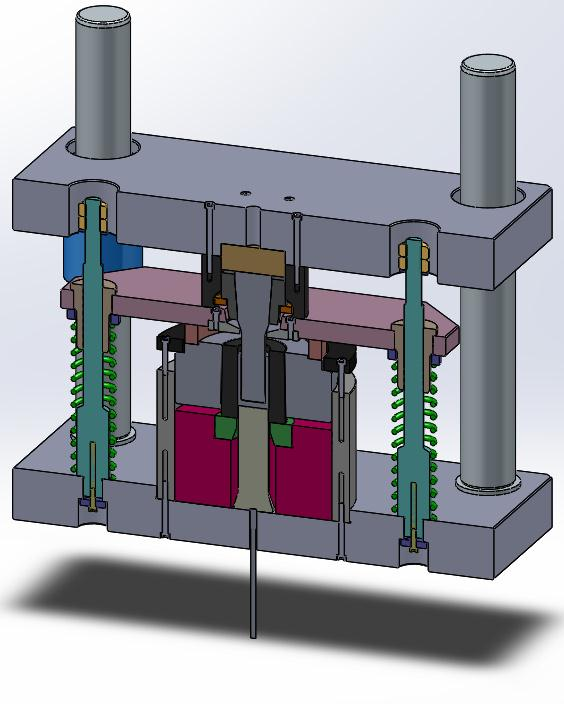
SCREENY/POZYCJA_DOLNA_AKSJONOMETRIA.jpg
