ptymek/projekt_obpla_wip/SCREENY/POZYCJA_GÓRNA_AKSJONOMETRIA.jpg

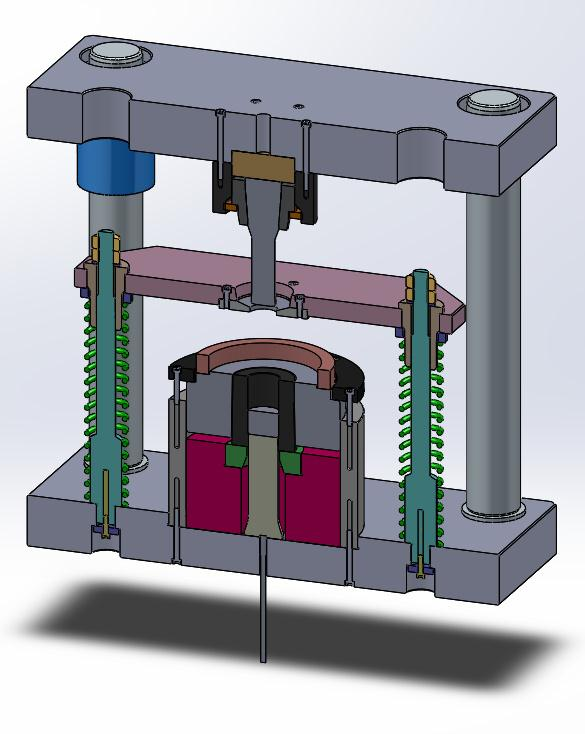
SCREENY/POZYCJA_GÓRNA_AKSJONOMETRIA.jpg
