ptymek/projekt_obpla_wip/SCREENY/STEMPEL_AKSJONOMETRIA.jpg

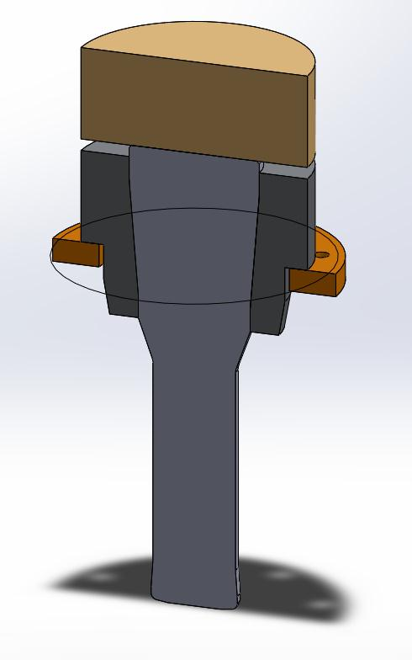
SCREENY/STEMPEL_AKSJONOMETRIA.jpg
