ptymek/projekt_obpla_wip/CZĘŚĆI/MATRYCA_ZŁOŻENIE__GÓRNA.SLDASM

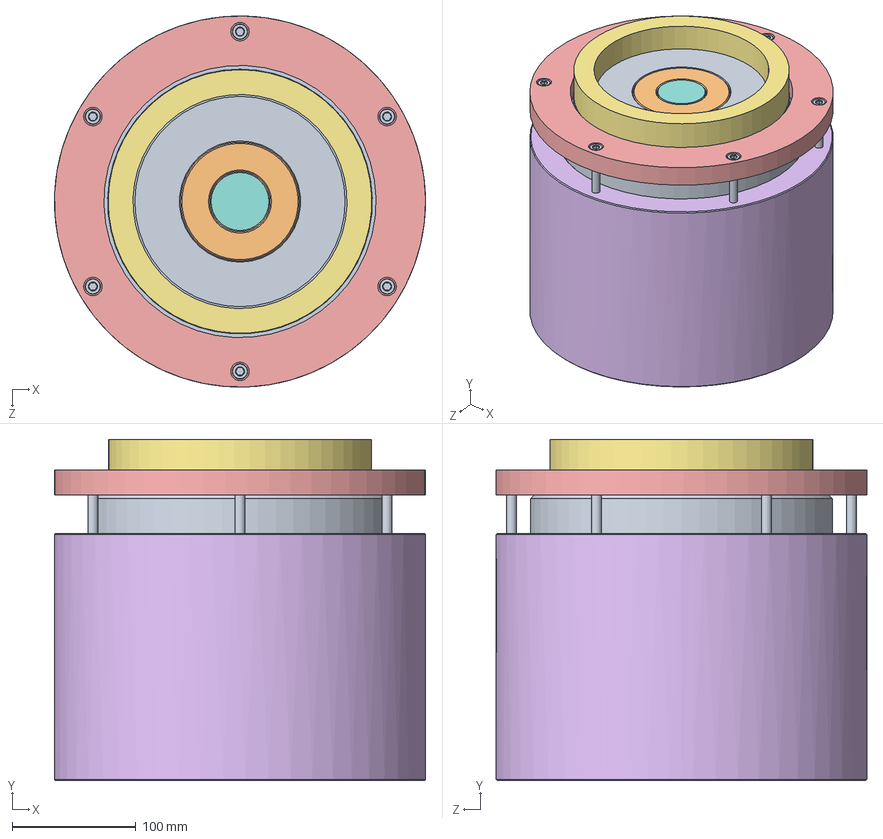
[picture p69: CAD file, 2019-07-03]
CZĘŚĆI/MATRYCA_ZŁOŻENIE__GÓRNA.SLDASM
300.0 x 276.0 x 299.9 mm
MATRYCA_PIERŚCIEŃ_ZEWN
MATRYCA_PIERŚCIEŃ_WEWN
WKŁADKA_PODTRZYMUJACA_MATRYCA_MIEKKA
WKŁADKA_PODTRZYMUJACA_MATRYCA_HARTOWANA
MOCOWANIE_MATRYCA_PŁYTA_OBEJMA_4
TULEJA_SCIAGAJACA
TULEJA_DYSTANSOWA
WYPYCHACZ
M8x50 x 6
