ptymek/projekt_obpla_wip/MODELE/POZYCJA_GÓRNA.SLDASM

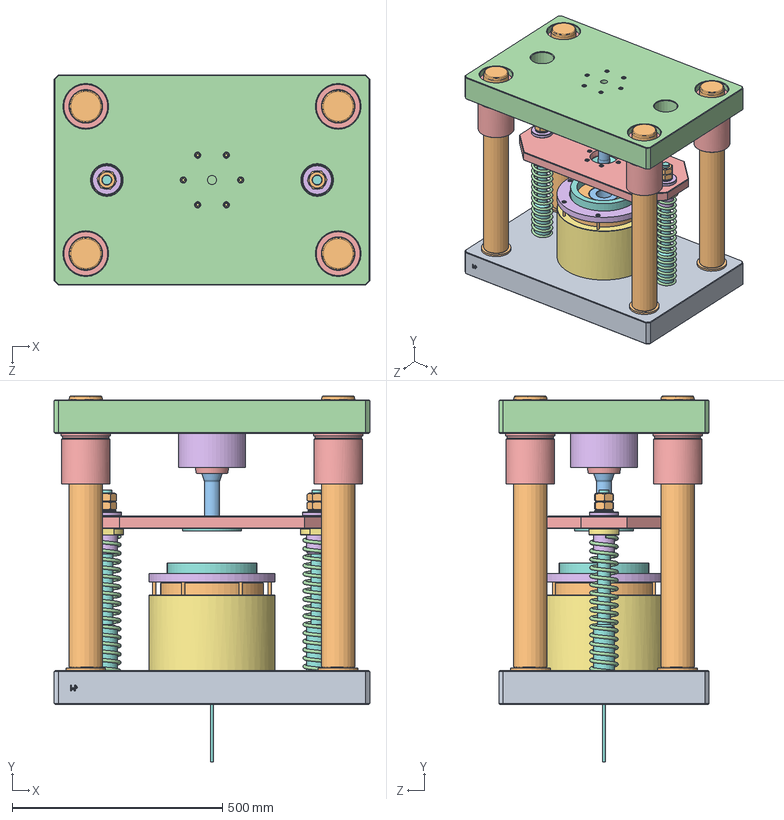
[picture p70: CAD file, 2019-07-03]
MODELE/POZYCJA_GÓRNA.SLDASM
750.0 x 870.0 x 500.0 mm
plyta-dolna_wp
slup-80 x 4
sr-am-M12x30 x 4
płyta-gorna-wp
tuleja-prowadzaca_80 x 4
TULEJA_STEMPEL_SCIAGACZ
M8x100 x 8
slup-sciagacza x 2
moc-slupa-sciag x 2
nakretka-m-24 x 4
podk-M24 x 2
sprezynka x 2
plyta-sciagacza-wp
tulejka-sciagacza x 2
nakr-sciagacza x 2
PŁYTA_SCIAGACZA_DOLNY_DYSTANS
M8x25 x 6
MATRYCA_PIERŚCIEŃ_ZEWN
MATRYCA_PIERŚCIEŃ_WEWN
WKŁADKA_PODTRZYMUJACA_MATRYCA_MIEKKA
WKŁADKA_PODTRZYMUJACA_MATRYCA_HARTOWANA
MOCOWANIE_MATRYCA_PŁYTA_OBEJMA_4
TULEJA_SCIAGAJACA
TULEJA_DYSTANSOWA
WYPYCHACZ
M8x50 x 6
STEMPEL
STEMPEL_TULEJA_DYSTANSOWA
DOCISK_STEMPLA
NAKRETKA_SCIAGAJACA_STEMPEL
M8x80 x 6
POPYCHACZ_WYPYCHACZA
WSTĘPNIAK
