ptymek/projekt_obpla_wip/CZĘŚĆI/STEMPEL_ZŁOŻENIE.SLDASM

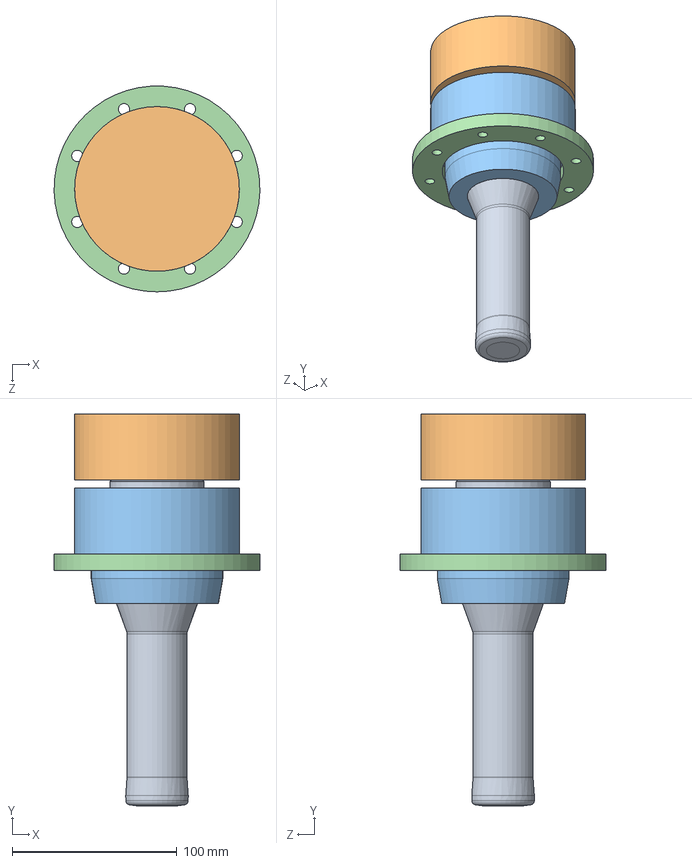
[picture p71: CAD file, 2019-07-03]
CZĘŚĆI/STEMPEL_ZŁOŻENIE.SLDASM
124.9 x 238.0 x 124.9 mm
STEMPEL
STEMPEL_TULEJA_DYSTANSOWA
DOCISK_STEMPLA
NAKRETKA_SCIAGAJACA_STEMPEL
