ptymek/projekt_obpla_wip/Przyrzad-W_Presz 2014/Zsp_3_slupa-sciagacza-wp-scisniety.SLDASM

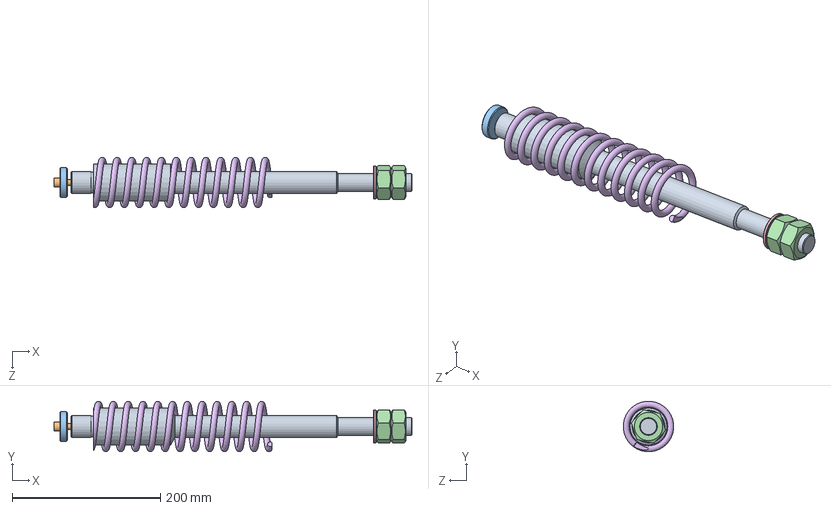
[picture p72: CAD file, 2019-07-03]
Przyrzad-W_Presz 2014/Zsp_3_slupa-sciagacza-wp-scisniety.SLDASM
483.0 x 68.0 x 68.0 mm
slup-sciagacza
M8x100
moc-slupa-sciag
nakretka-m-24 x 2
podk-M24
sprezynka-skurczona
