ptymek/projekt_obpla_wip/Przyrzad-W_Presz 2014/Zsp_4_plyty-sciagacza-wp.SLDASM

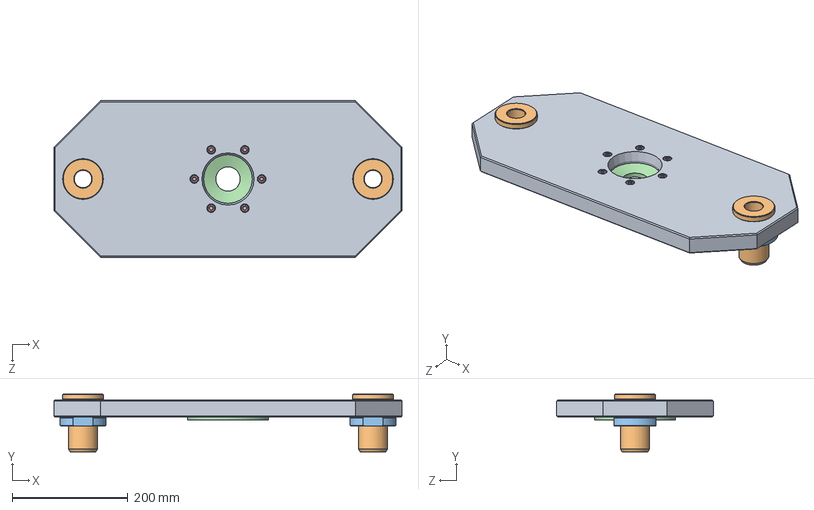
[picture p75: CAD file, 2019-07-03]
Przyrzad-W_Presz 2014/Zsp_4_plyty-sciagacza-wp.SLDASM
600.0 x 100.0 x 270.0 mm
plyta-sciagacza-wp
tulejka-sciagacza x 2
nakr-sciagacza x 2
PŁYTA_SCIAGACZA_DOLNY_DYSTANS
M8x25 x 6
