ptymek/projekt_obpla_wip/Przyrzad-W_Presz 2014/Zsp_2_plyty_gornej-wp.SLDASM

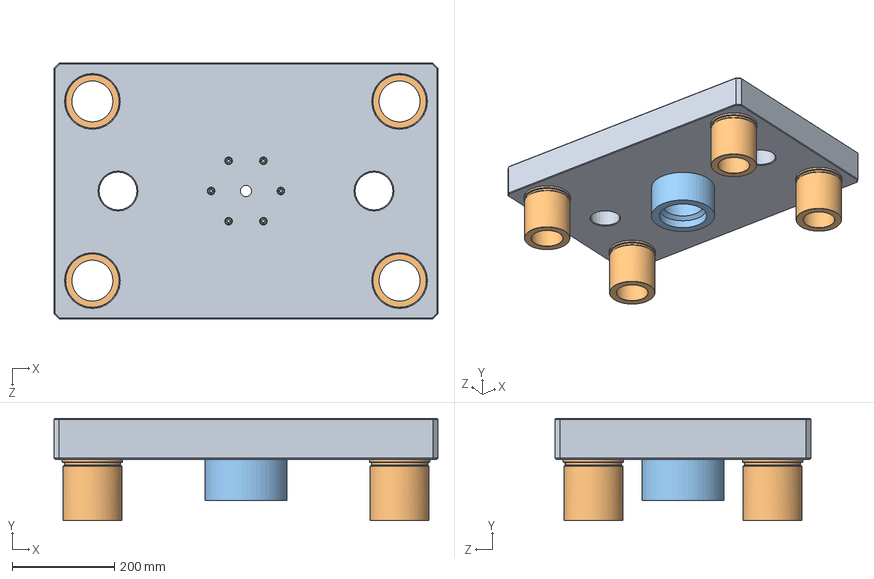
[picture p76: CAD file, 2019-07-03]
Przyrzad-W_Presz 2014/Zsp_2_plyty_gornej-wp.SLDASM
750.0 x 200.0 x 500.0 mm
płyta-gorna-wp
tuleja-prowadzaca_80 x 4
TULEJA_STEMPEL_SCIAGACZ
M8x100 x 6
