ptymek/projekt_obpla_wip/Przyrzad-W_Presz 2014/Pzsp_1_1_slup80-z-mocowaniem.SLDASM

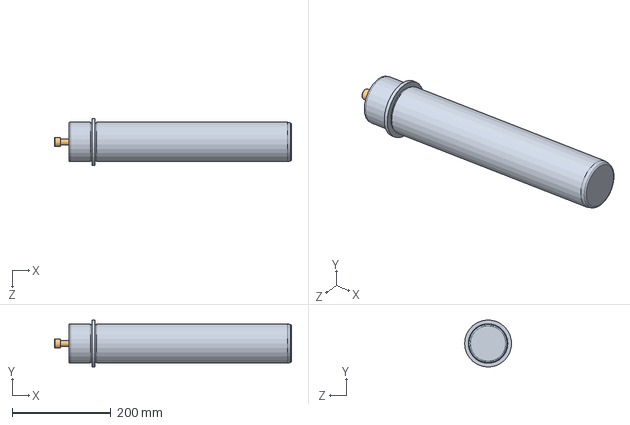
[picture p78: CAD file, 2019-07-03]
Przyrzad-W_Presz 2014/Pzsp_1_1_slup80-z-mocowaniem.SLDASM
479.0 x 94.9 x 94.7 mm
slup-80
sr-am-M12x30
