ptymek/projekt_obpla_wip/Przyrzad-W_Presz 2014/Przyrzad_Bulk_W-Presz-2012.SLDASM

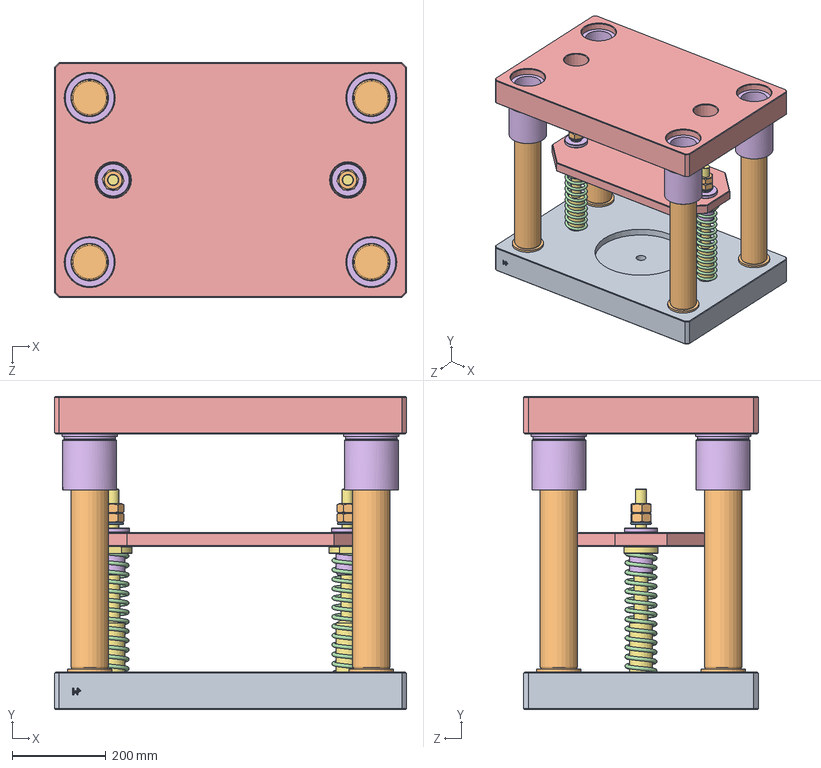
[picture p79: CAD file, 2019-07-03]
Przyrzad-W_Presz 2014/Przyrzad_Bulk_W-Presz-2012.SLDASM
750.0 x 667.4 x 500.0 mm
plyta-dolna_wp
slup-80 x 4
FPM-80 x 4
sr-am-M12x30 x 4
płyta-gorna-wp
tuleja-prowadzaca_80 x 4
slup-sciagacza x 2
M8x25 x 2
moc-slupa-sciag x 2
nakretka-m-24 x 4
podk-M24 x 2
sprezynka x 2
plyta-sciagacza-wp
tulejka-sciagacza x 2
nakr-sciagacza x 2
