ptymek/projekt_obpla_wip/CZĘŚĆI/MATRYCA_ZŁOŻENIE_TECHNICZNY.SLDASM

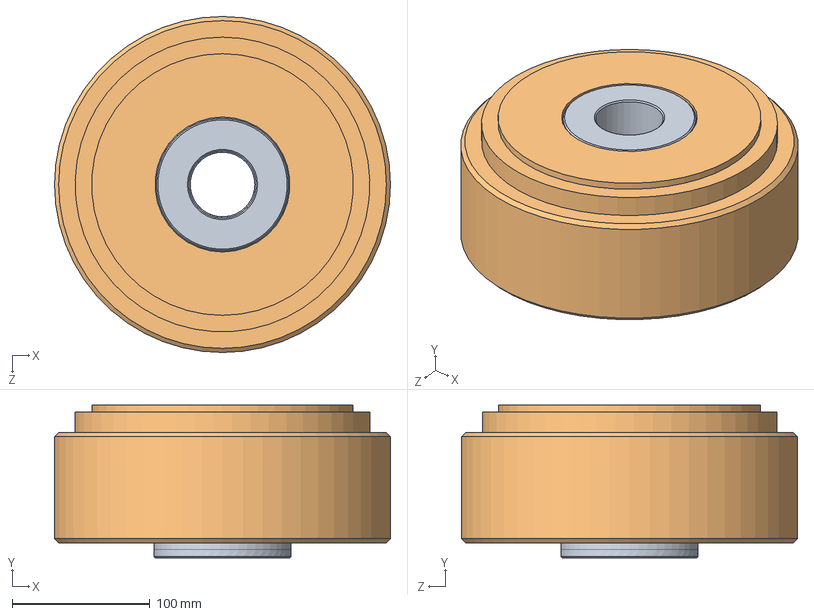
[picture p80: CAD file, 2019-07-03]
CZĘŚĆI/MATRYCA_ZŁOŻENIE_TECHNICZNY.SLDASM
244.0 x 111.0 x 244.0 mm
MATRYCA_PIERŚCIEŃ_WEWN
MATRYCA_PIERŚCIEŃ_ZEWN
