ptymek/projekt_obpla_wip/Przyrzad-W_Presz 2014/Zsp_1_plyty_dolnej-wp.SLDASM

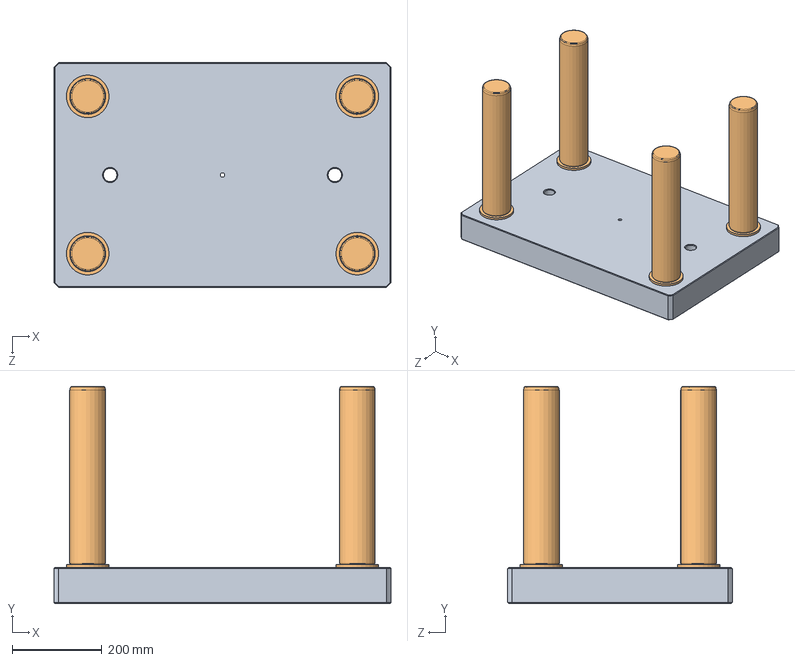
[picture p81: CAD file, 2019-07-03]
Przyrzad-W_Presz 2014/Zsp_1_plyty_dolnej-wp.SLDASM
750.0 x 483.0 x 500.0 mm
plyta-dolna_wp
slup-80 x 4
sr-am-M12x30 x 4
