ptymek/projekt_obpla_wip/CZĘŚĆI/MOCOWANIE_MATRYCA_PŁYTA_OBEJMA_4.SLDPRT

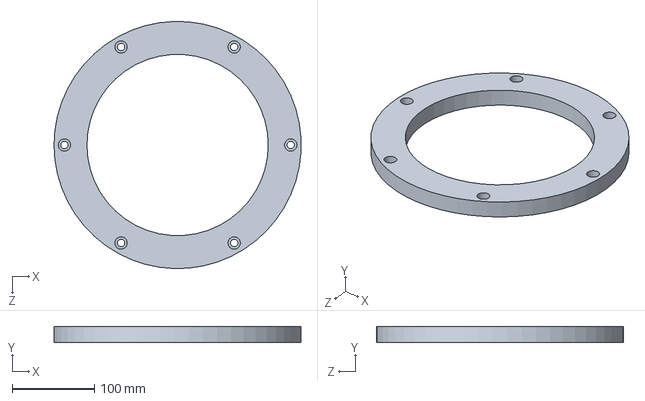
[picture p82: CAD file, 2019-07-03]
CZĘŚĆI/MOCOWANIE_MATRYCA_PŁYTA_OBEJMA_4.SLDPRT
299.7 x 20.0 x 299.9 mm
