ptymek/projekt_obpla_wip/MODELE/WYCIĄGANIE.SLDPRT

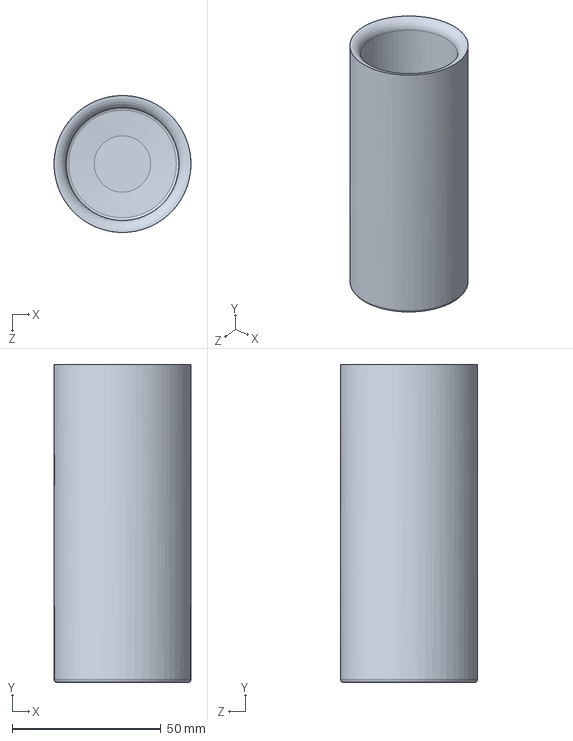
[picture p83: CAD file, 2019-07-03]
MODELE/WYCIĄGANIE.SLDPRT
46.1 x 107.0 x 46.0 mm
