ptymek/projekt_obpla_wip/Przyrzad-W_Presz 2014/sprezynka.SLDPRT

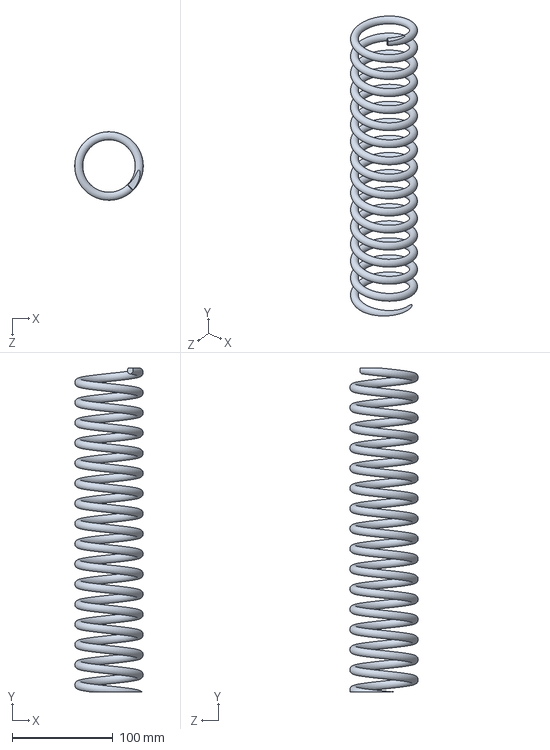
[picture p84: CAD file, 2019-07-03]
Przyrzad-W_Presz 2014/sprezynka.SLDPRT
68.0 x 321.4 x 68.0 mm
