ptymek/projekt_obpla_wip/CZĘŚĆI/PŁYTA_SCIAGACZA_DOLNY_DYSTANS.SLDPRT

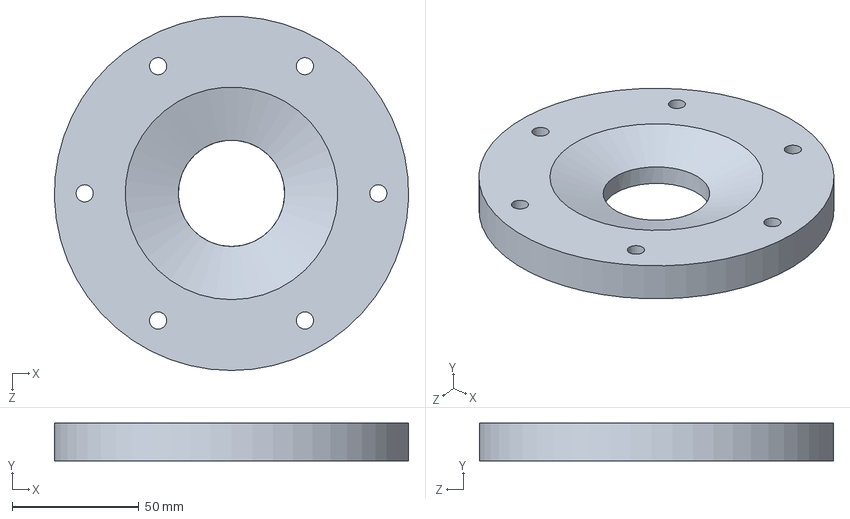
[picture p85: CAD file, 2019-07-03]
CZĘŚĆI/PŁYTA_SCIAGACZA_DOLNY_DYSTANS.SLDPRT
139.9 x 15.0 x 139.9 mm
