ptymek/projekt_obpla_wip/MODELE/WSTĘPNIAK.SLDPRT

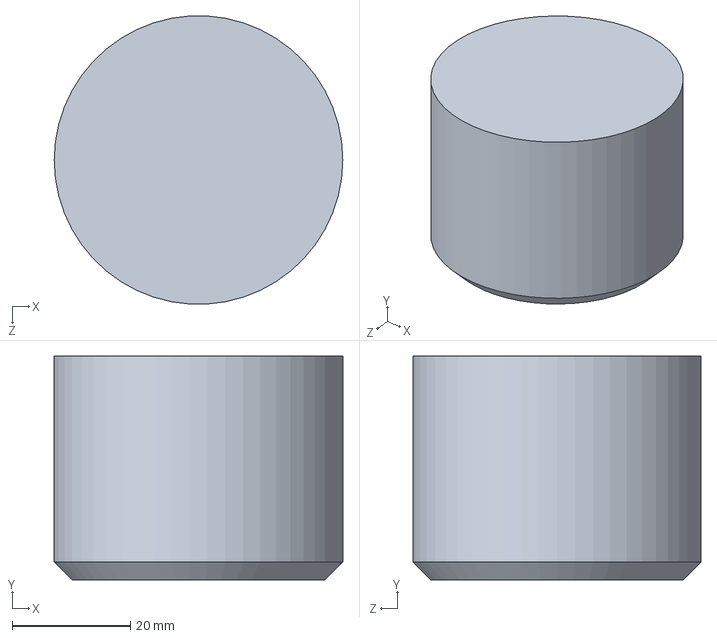
[picture p86: CAD file, 2019-07-03]
MODELE/WSTĘPNIAK.SLDPRT
48.8 x 37.9 x 48.8 mm
