ptymek/projekt_obpla_wip/Przyrzad-W_Presz 2014/tuleja-prowadzaca_80.SLDPRT

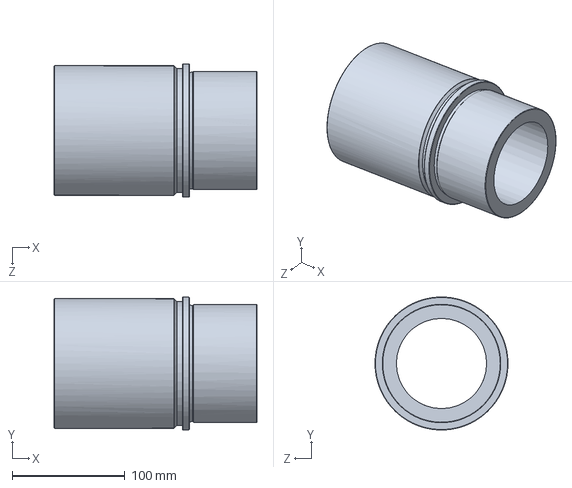
[picture p87: CAD file, 2019-07-03]
Przyrzad-W_Presz 2014/tuleja-prowadzaca_80.SLDPRT
180.0 x 117.8 x 118.0 mm
