ptymek/projekt_obpla_wip/CZĘŚĆI/MATRYCA_PIERŚCIEŃ_WEWN.SLDPRT

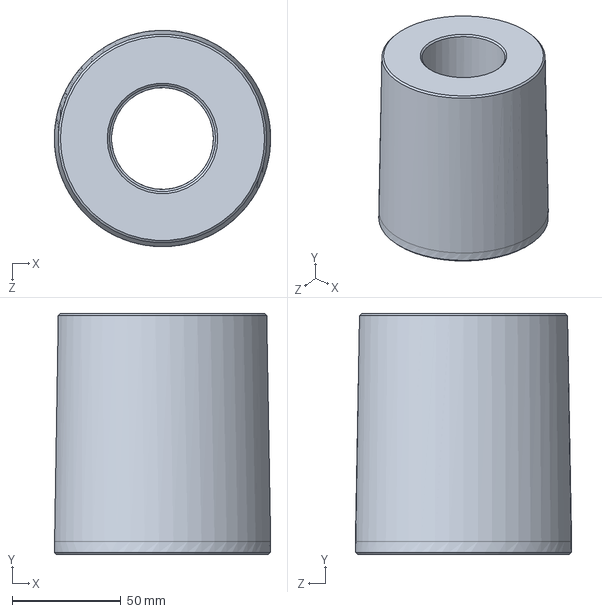
[picture p88: CAD file, 2019-07-03]
CZĘŚĆI/MATRYCA_PIERŚCIEŃ_WEWN.SLDPRT
99.7 x 111.0 x 99.6 mm
