ptymek/projekt_obpla_wip/Przyrzad-W_Presz 2014/nakr-sciagacza.SLDPRT

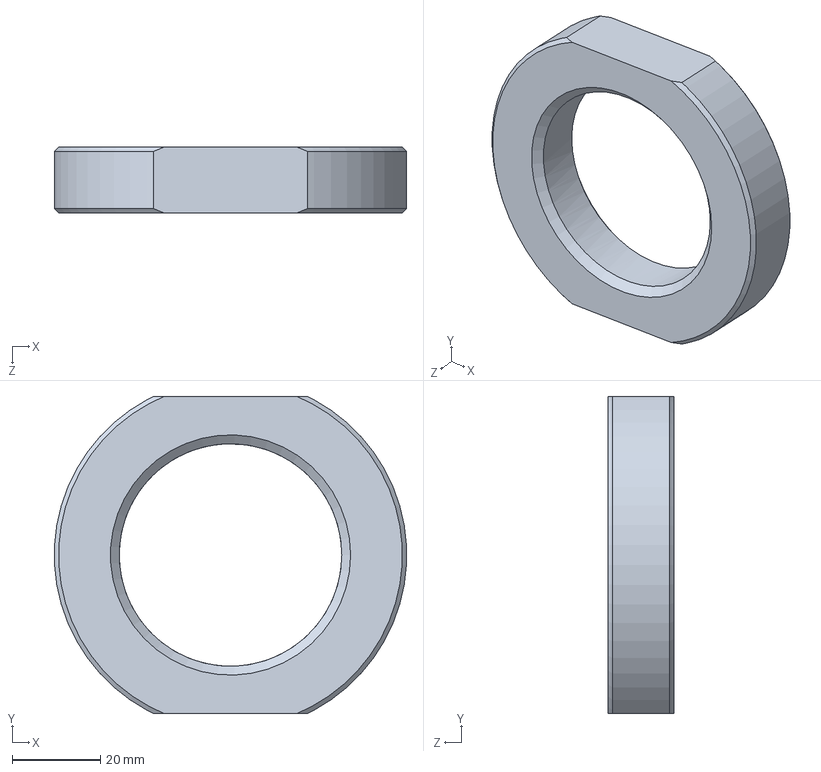
[picture p89: CAD file, 2019-07-03]
Przyrzad-W_Presz 2014/nakr-sciagacza.SLDPRT
79.9 x 72.0 x 15.0 mm
