ptymek/projekt_obpla_wip/Przyrzad-W_Presz 2014/slup-sciagacza.SLDPRT

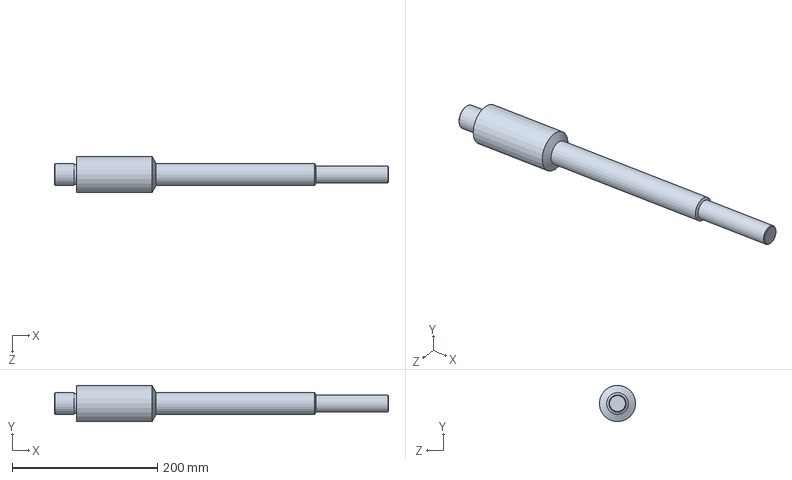
[picture p90: CAD file, 2019-07-03]
Przyrzad-W_Presz 2014/slup-sciagacza.SLDPRT
460.0 x 50.0 x 50.0 mm
