ptymek/projekt_obpla_wip/CZĘŚĆI/NAKRETKA_SCIAGAJACA_STEMPEL.SLDPRT

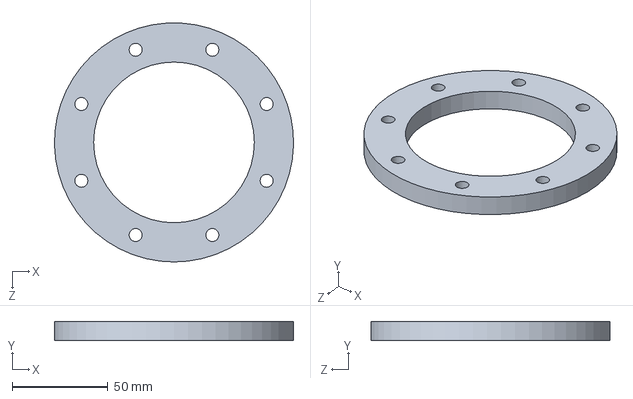
[picture p91: CAD file, 2019-07-03]
CZĘŚĆI/NAKRETKA_SCIAGAJACA_STEMPEL.SLDPRT
124.9 x 10.0 x 124.9 mm
