ptymek/projekt_obpla_wip/CZĘŚĆI/TULEJA_SCIAGAJACA.SLDPRT

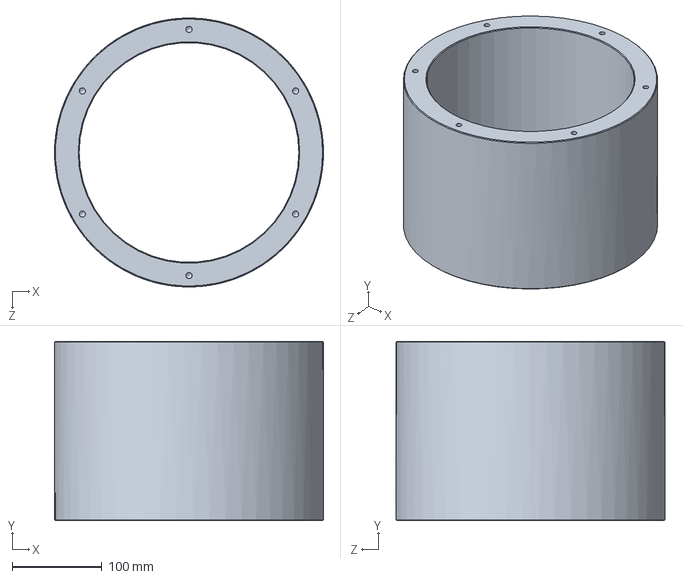
[picture p92: CAD file, 2019-07-03]
CZĘŚĆI/TULEJA_SCIAGAJACA.SLDPRT
300.0 x 200.0 x 299.9 mm
