ptymek/projekt_obpla_wip/MODELE/GOTOWY_WYRÓB.SLDPRT

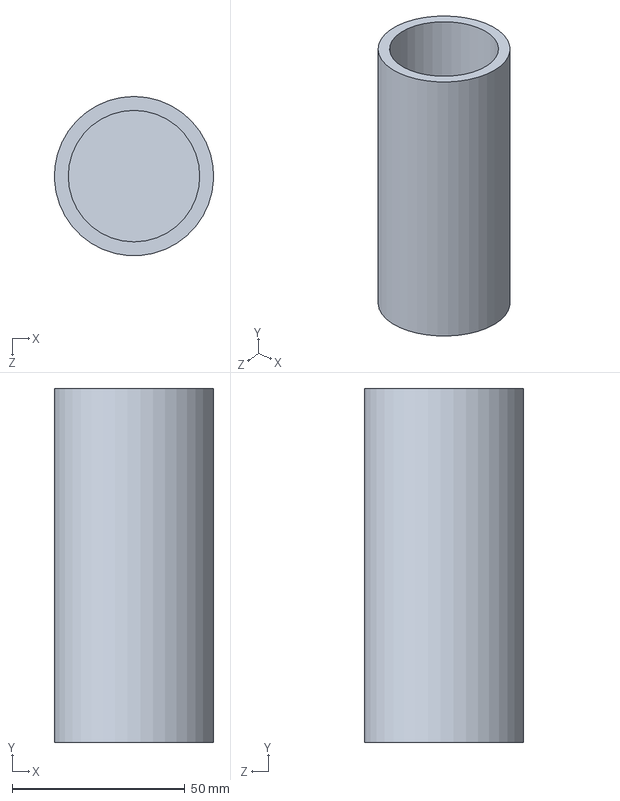
[picture p93: CAD file, 2019-07-03]
MODELE/GOTOWY_WYRÓB.SLDPRT
46.0 x 102.4 x 46.0 mm
