ptymek/projekt_obpla_wip/Przyrzad-W_Presz 2014/nakretka-m-24.SLDPRT

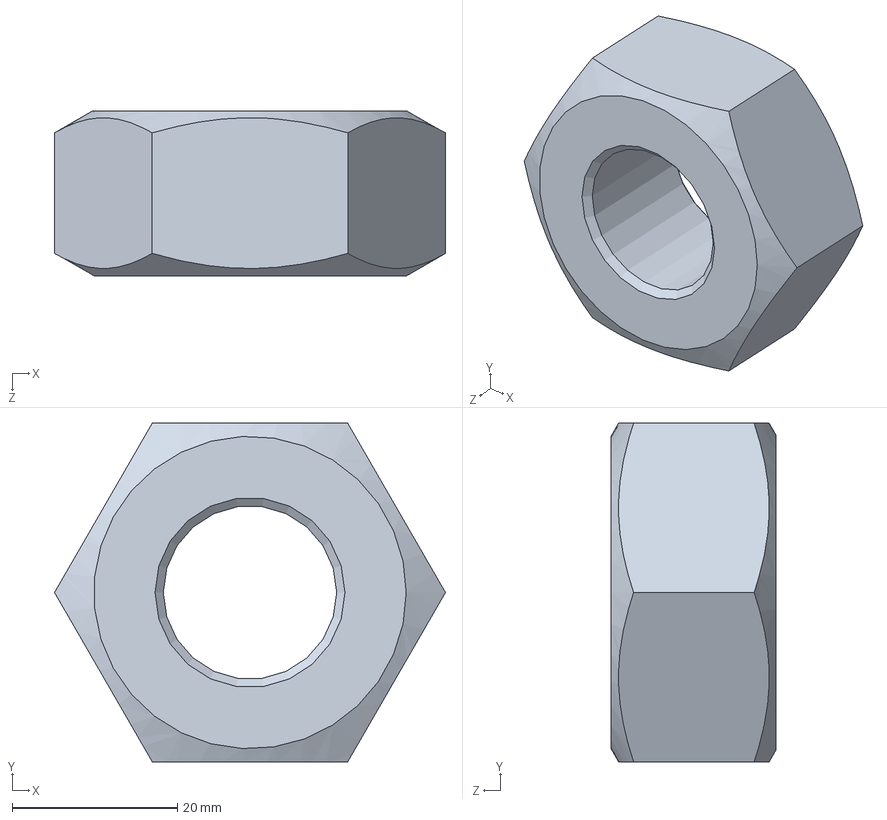
[picture p94: CAD file, 2019-07-03]
Przyrzad-W_Presz 2014/nakretka-m-24.SLDPRT
47.3 x 41.0 x 20.0 mm
