ptymek/projekt_obpla_wip/CZĘŚĆI/TULEJA_DYSTANSOWA.SLDPRT

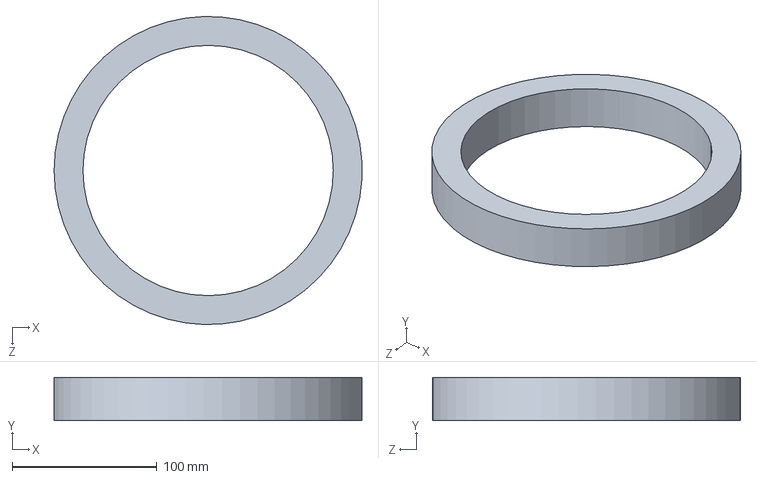
[picture p95: CAD file, 2019-07-03]
CZĘŚĆI/TULEJA_DYSTANSOWA.SLDPRT
212.8 x 30.0 x 212.9 mm
