ptymek/projekt_obpla_wip/MODELE/WYCISKANIE_PRZECIWBIEŻNE.SLDPRT

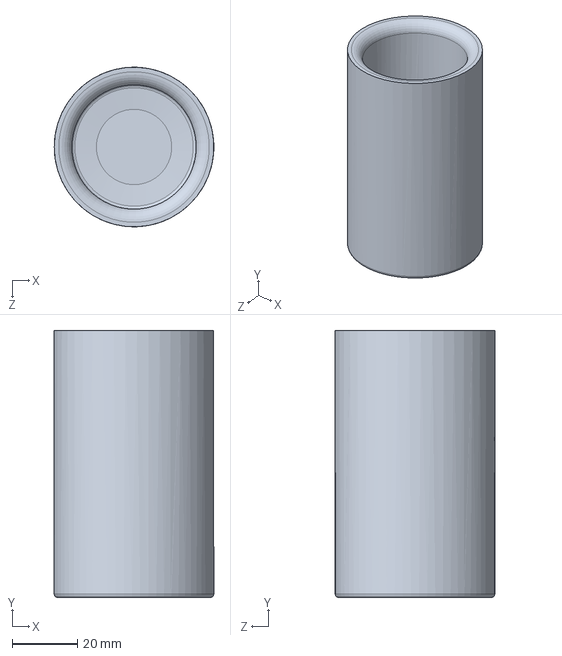
[picture p96: CAD file, 2019-07-03]
MODELE/WYCISKANIE_PRZECIWBIEŻNE.SLDPRT
48.8 x 81.7 x 48.8 mm
