ptymek/projekt_obpla_wip/Przyrzad-W_Presz 2014/sprezynka-skurczona.SLDPRT

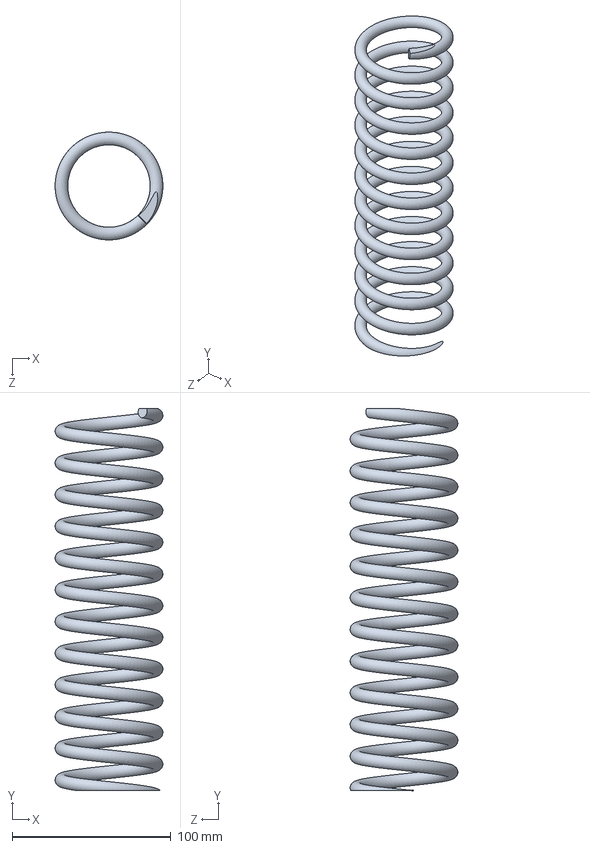
[picture p97: CAD file, 2019-07-03]
Przyrzad-W_Presz 2014/sprezynka-skurczona.SLDPRT
68.0 x 241.0 x 68.0 mm
