ptymek/projekt_obpla_wip/CZĘŚĆI/STEMPEL_TULEJA_DYSTANSOWA.SLDPRT

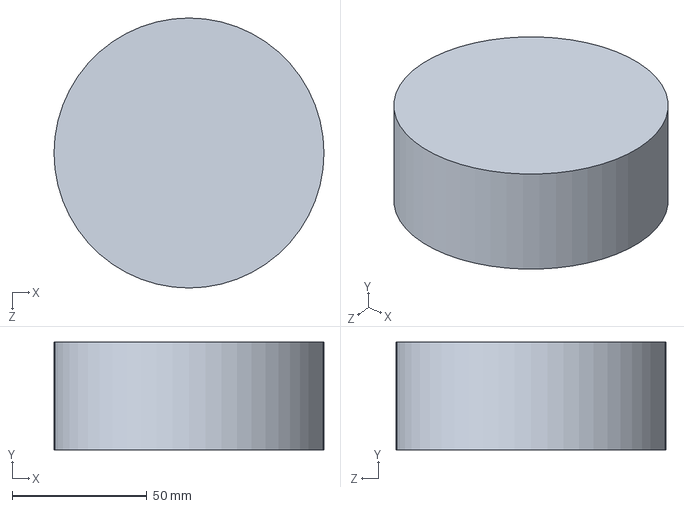
[picture p98: CAD file, 2019-07-03]
CZĘŚĆI/STEMPEL_TULEJA_DYSTANSOWA.SLDPRT
100.0 x 40.0 x 100.0 mm
