ptymek/projekt_obpla_wip/Przyrzad-W_Presz 2014/tulejka-sciagacza.SLDPRT

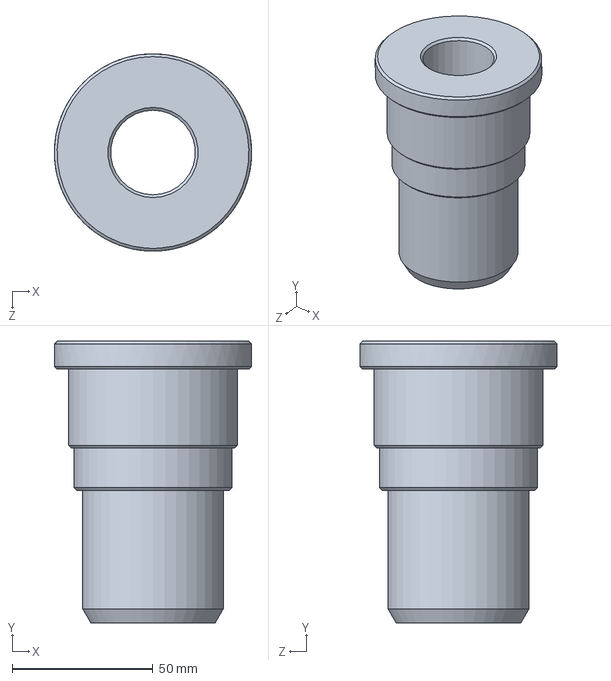
[picture p99: CAD file, 2019-07-03]
Przyrzad-W_Presz 2014/tulejka-sciagacza.SLDPRT
70.0 x 100.0 x 70.0 mm
