ptymek/projekt_obpla_wip/CZĘŚĆI/WKŁADKA_PODTRZYMUJACA_MATRYCA_MIEKKA.SLDPRT

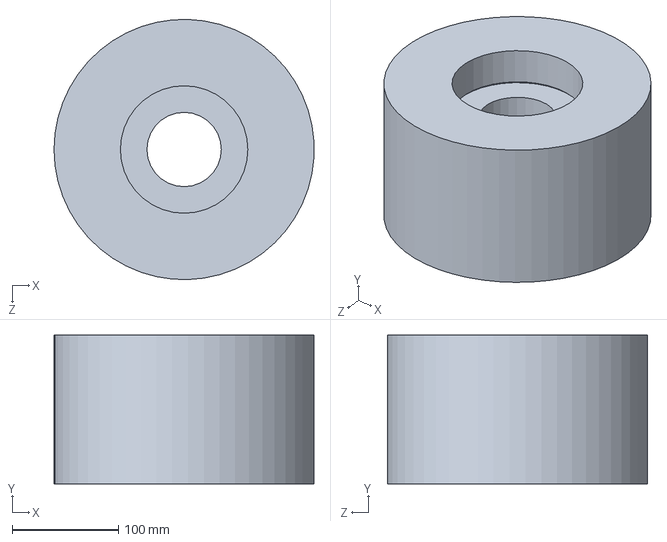
[picture p100: CAD file, 2019-07-03]
CZĘŚĆI/WKŁADKA_PODTRZYMUJACA_MATRYCA_MIEKKA.SLDPRT
244.8 x 140.0 x 244.9 mm
