ptymek/projekt_obpla_wip/CZĘŚĆI/DOCISK_STEMPLA.SLDPRT

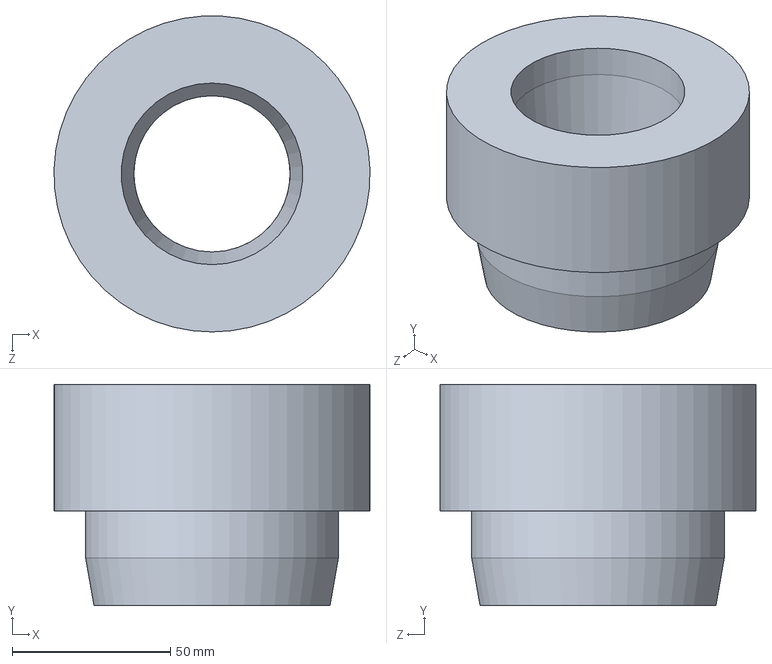
[picture p101: CAD file, 2019-07-03]
CZĘŚĆI/DOCISK_STEMPLA.SLDPRT
100.0 x 70.0 x 99.9 mm
