ptymek/projekt_obpla_wip/Przyrzad-W_Presz 2014/FPM-80.SLDPRT

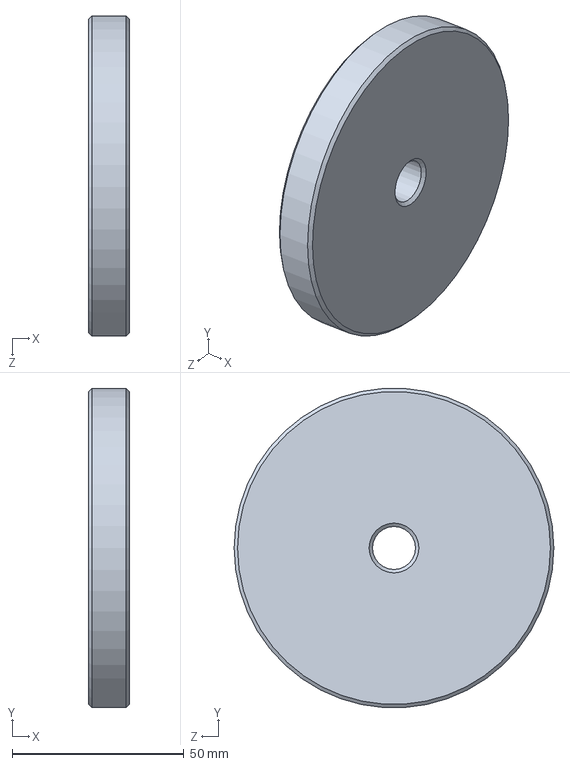
[picture p102: CAD file, 2019-07-03]
Przyrzad-W_Presz 2014/FPM-80.SLDPRT
12.0 x 92.8 x 93.0 mm
