ptymek/projekt_obpla_wip/CZĘŚĆI/WKŁADKA_PODTRZYMUJACA_MATRYCA_HARTOWANA.SLDPRT

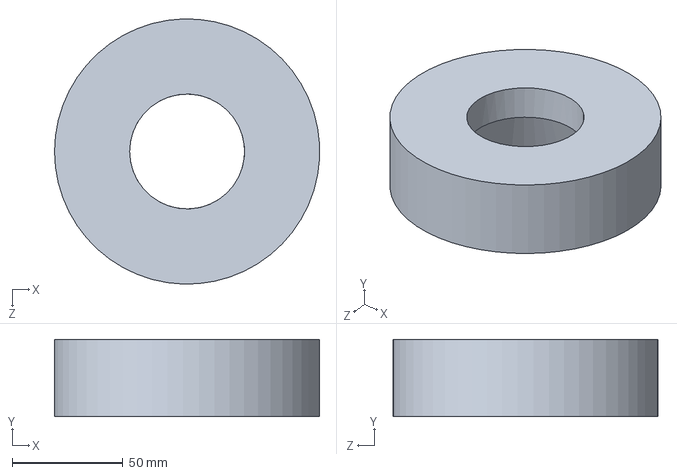
[picture p103: CAD file, 2019-07-03]
CZĘŚĆI/WKŁADKA_PODTRZYMUJACA_MATRYCA_HARTOWANA.SLDPRT
119.9 x 35.0 x 119.9 mm
