ptymek/projekt_obpla_wip/CZĘŚĆI/MATRYCA_PIERŚCIEŃ_ZEWN.SLDPRT

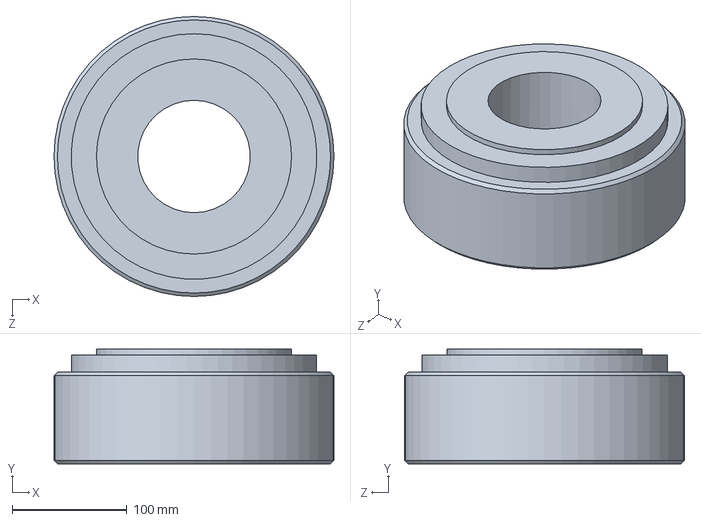
[picture p104: CAD file, 2019-07-03]
CZĘŚĆI/MATRYCA_PIERŚCIEŃ_ZEWN.SLDPRT
244.0 x 100.0 x 244.0 mm
