ptymek/projekt_obpla_wip/Przyrzad-W_Presz 2014/plyta-sciagacza-wp.SLDPRT

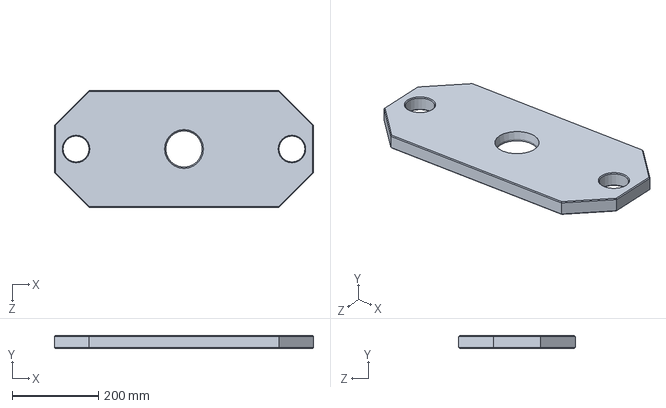
[picture p105: CAD file, 2019-07-03]
Przyrzad-W_Presz 2014/plyta-sciagacza-wp.SLDPRT
600.0 x 30.0 x 270.0 mm
