ptymek/projekt_obpla_wip/CZĘŚĆI/POPYCHACZ_WYPYCHACZA.SLDPRT

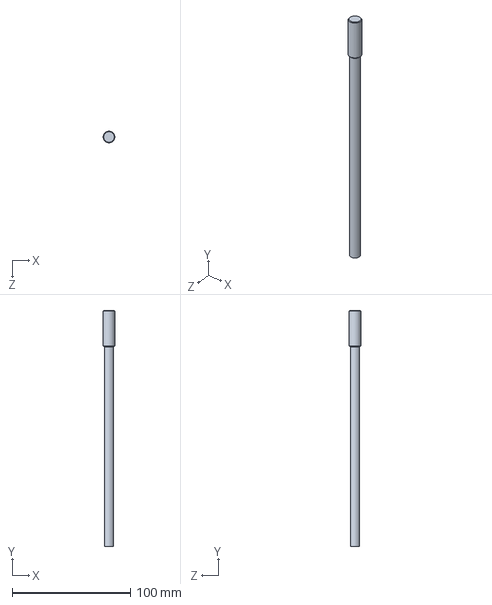
[picture p106: CAD file, 2019-07-03]
CZĘŚĆI/POPYCHACZ_WYPYCHACZA.SLDPRT
10.0 x 200.0 x 10.0 mm
