ptymek/projekt_obpla_wip/CZĘŚĆI/TULEJA_STEMPEL_SCIAGACZ.SLDPRT

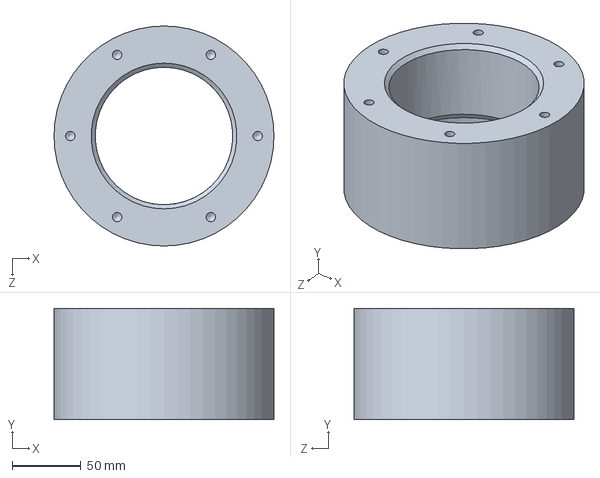
[picture p107: CAD file, 2019-07-03]
CZĘŚĆI/TULEJA_STEMPEL_SCIAGACZ.SLDPRT
160.0 x 81.0 x 160.0 mm
