ptymek/projekt_obpla_wip/CZĘŚĆI/STEMPEL.SLDPRT

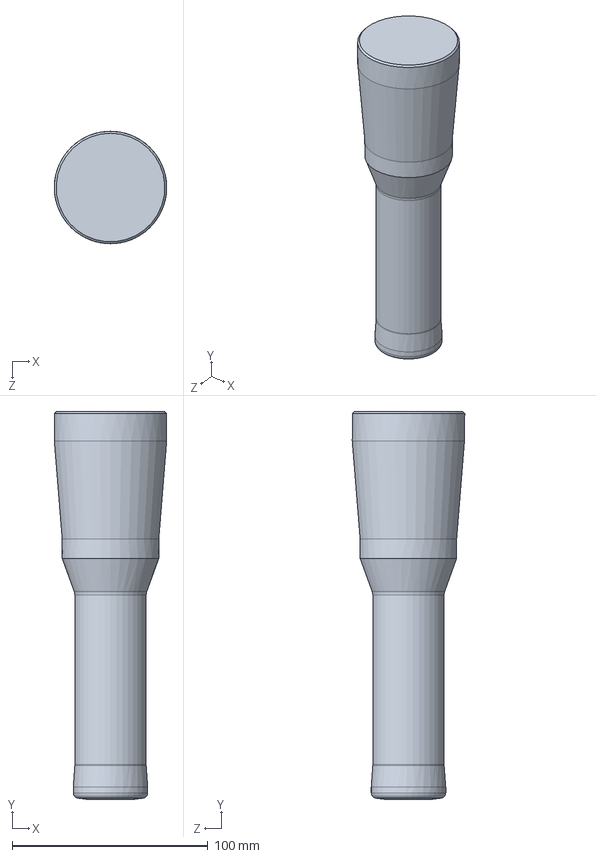
[picture p108: CAD file, 2019-07-03]
CZĘŚĆI/STEMPEL.SLDPRT
57.4 x 198.0 x 57.4 mm
