ptymek/projekt_obpla_wip/CZĘŚĆI/WYPYCHACZ.SLDPRT

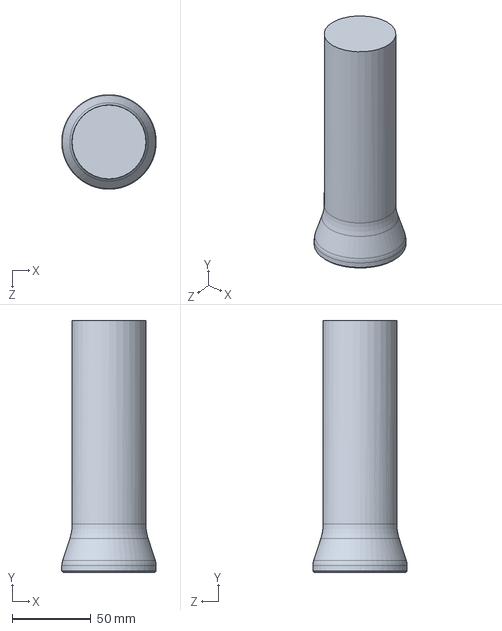
[picture p109: CAD file, 2019-07-03]
CZĘŚĆI/WYPYCHACZ.SLDPRT
60.0 x 160.0 x 60.0 mm
