ptymek/projekt_obpla_wip/Przyrzad-W_Presz 2014/moc-slupa-sciag.SLDPRT

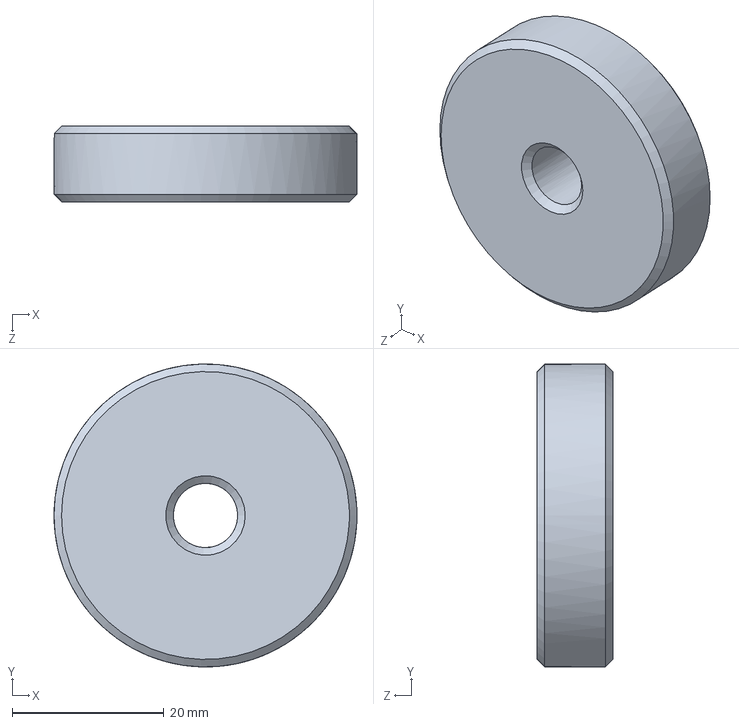
[picture p110: CAD file, 2019-07-03]
Przyrzad-W_Presz 2014/moc-slupa-sciag.SLDPRT
40.0 x 40.0 x 10.0 mm
