ptymek/projekt_obpla_wip/Przyrzad-W_Presz 2014/slup-80.SLDPRT

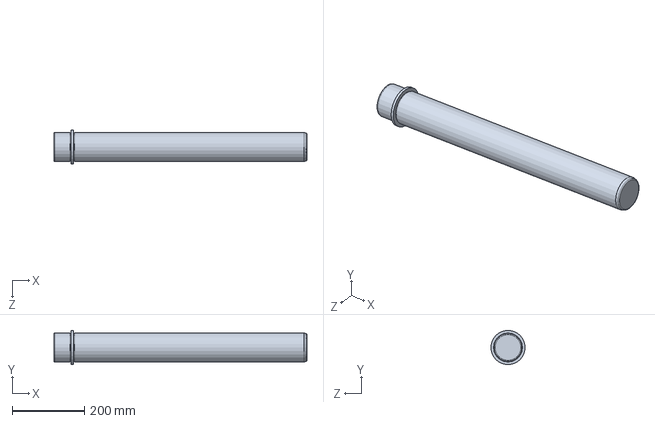
[picture p111: CAD file, 2019-07-03]
Przyrzad-W_Presz 2014/slup-80.SLDPRT
700.0 x 95.0 x 95.0 mm
