ptymek/projekt_obpla_wip/Przyrzad-W_Presz 2014/sr-am-M12x30.SLDPRT

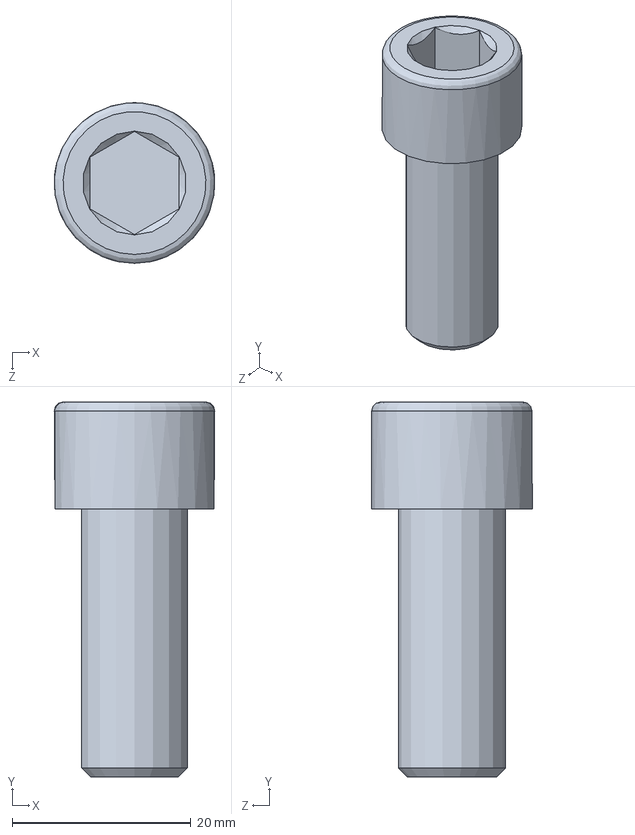
[picture p112: CAD file, 2019-07-03]
Przyrzad-W_Presz 2014/sr-am-M12x30.SLDPRT
18.0 x 42.0 x 18.0 mm
