ptymek/projekt_obpla_wip/Przyrzad-W_Presz 2014/płyta-gorna-wp.SLDPRT

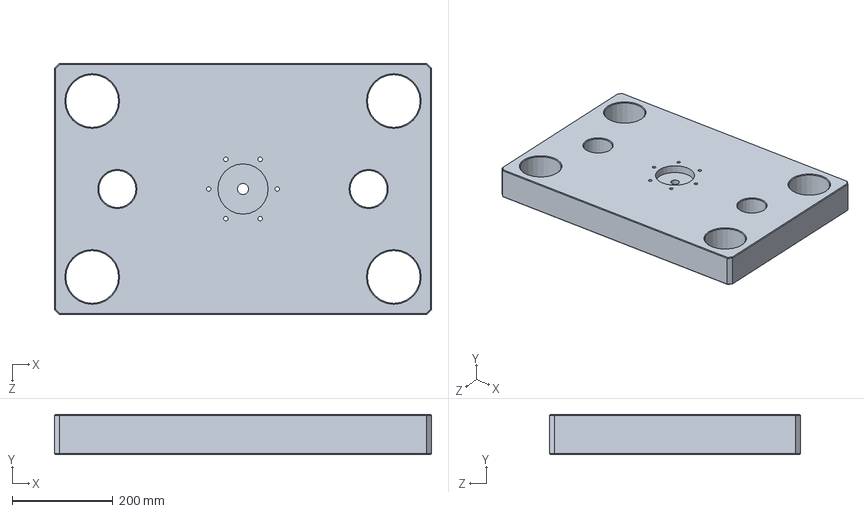
[picture p113: CAD file, 2019-07-03]
Przyrzad-W_Presz 2014/płyta-gorna-wp.SLDPRT
750.0 x 80.0 x 500.0 mm
