ptymek/projekt_obpla_wip/Przyrzad-W_Presz 2014/podk-M24.SLDPRT

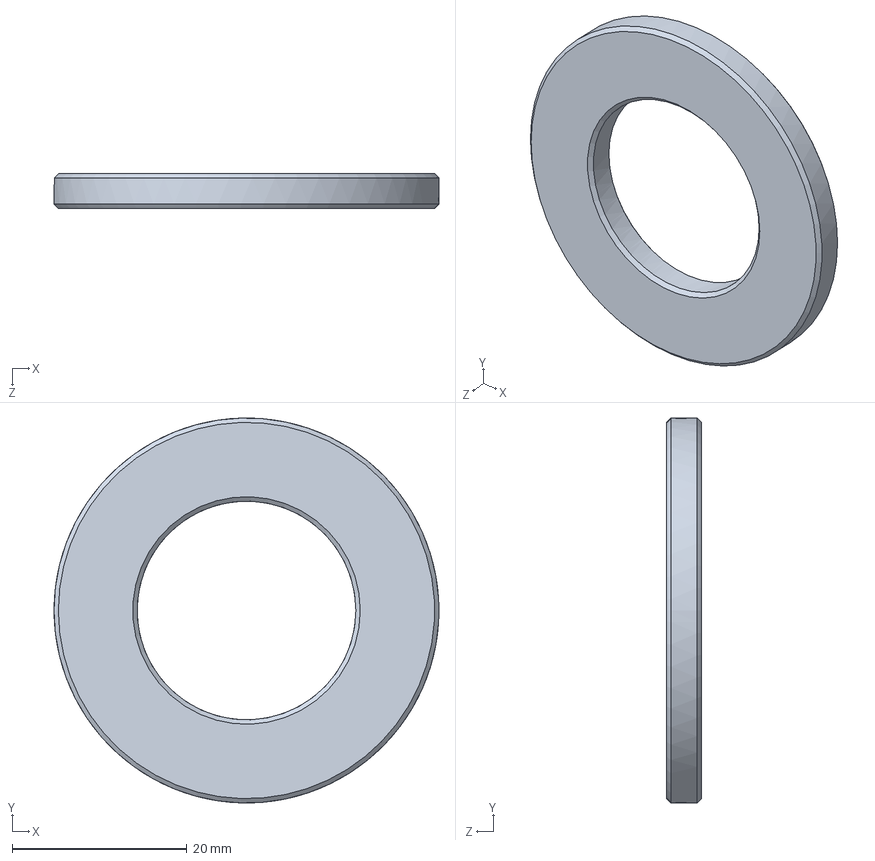
[picture p114: CAD file, 2019-07-03]
Przyrzad-W_Presz 2014/podk-M24.SLDPRT
44.0 x 44.0 x 4.00 mm
