ptymek/projekt_obpla_wip/(list of files, cad)

Other CAD files:
CZĘŚĆI/MATRYCA_ZŁOŻENIE_DOLNA.SLDASM
MODELE/POZYCJA_DOLNA.SLDASM
MODELE/PROSTOWANIE_DNA.SLDPRT
Przyrzad-W_Presz 2014/plyta-dolna_wp.SLDPRT
Przyrzad-W_Presz 2014/M8x100.SLDPRT
Przyrzad-W_Presz 2014/M8x25.SLDPRT
Przyrzad-W_Presz 2014/M8x50.SLDPRT
Przyrzad-W_Presz 2014/M8x80.SLDPRT
RYSUNKI/GOTOWY_WYRÓB.SLDDRW
RYSUNKI/MATRYCA_ZŁOŻENIE_TECHNICZNY.SLDDRW
RYSUNKI/PROCES_TECHNOLOGICZNY.SLDDRW
RYSUNKI/STEMPEL.SLDDRW
