ptymek/projekt_obpla_wip/PDF/GOTOWY_WYRÓB_DRUK.pdf

46,08
38,04 | 5° 102,40

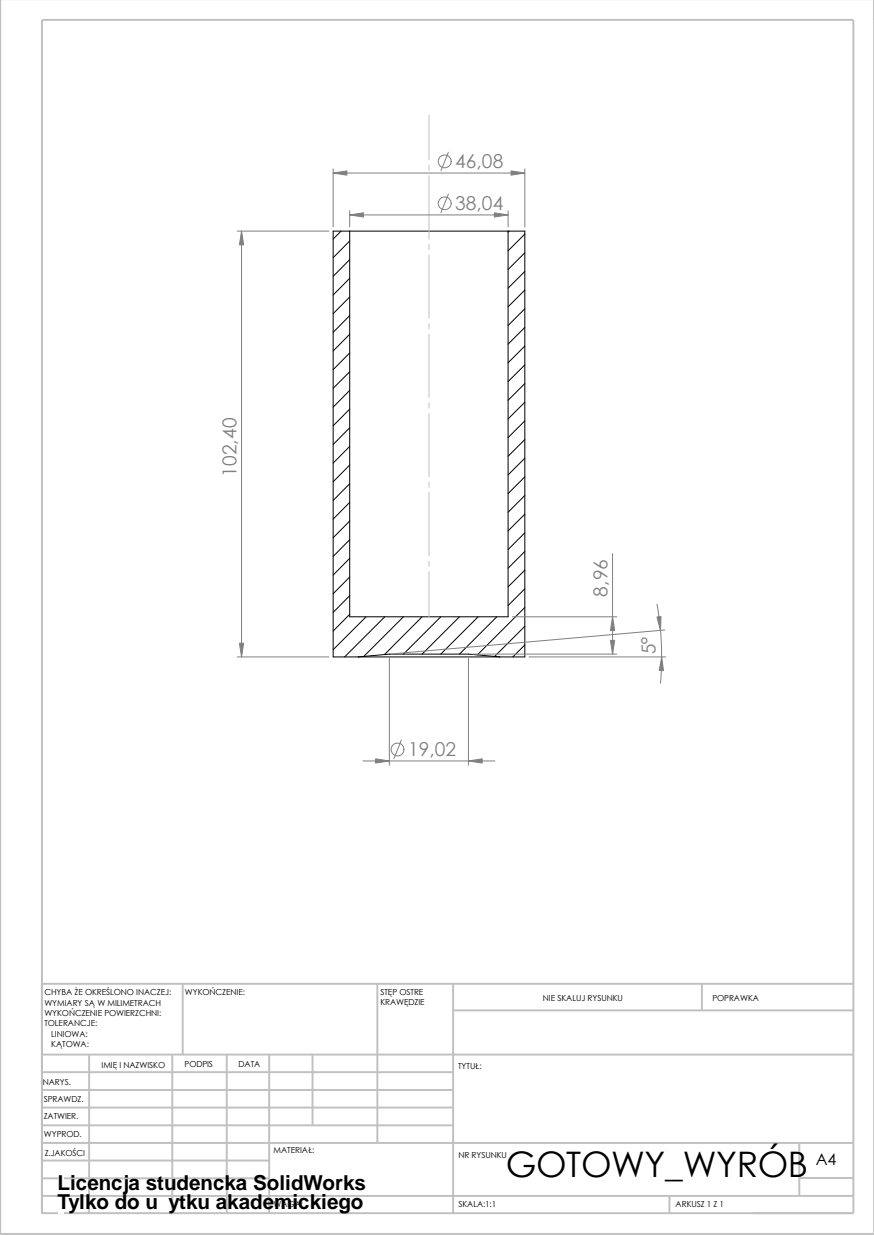
[picture p115: page 1]
STP OSTRE KRAWDZIE; WYKOCZENIE:; POPRAWKA

NIE SKALUJ RYSUNKU CHYBA E OKRELONO INACZEJ:
WYMIARY S W MILIMETRACH
WYKOCZENIE POWIERZCHNI: TOLERANCJE:
LINIOWA:
KTOWA:

IMI I NAZWISKO | PODPIS | DATA | TYTU: GOTOWY_WYRÓB A4
NARYS.
SPRAWDZ. ZATWIER.

Z.JAKOCI WYPROD.
Licencja studencka SolidWorks Tylko do użytku akademickiego

MATERIA: | NR RYSUNKU

WAGA: | SKALA:1:1 | ARKUSZ 1 Z 1
