ptymek/projekt_obpla_wip/PDF/MATRYCA_DRUK.pdf

szlif.
0,63

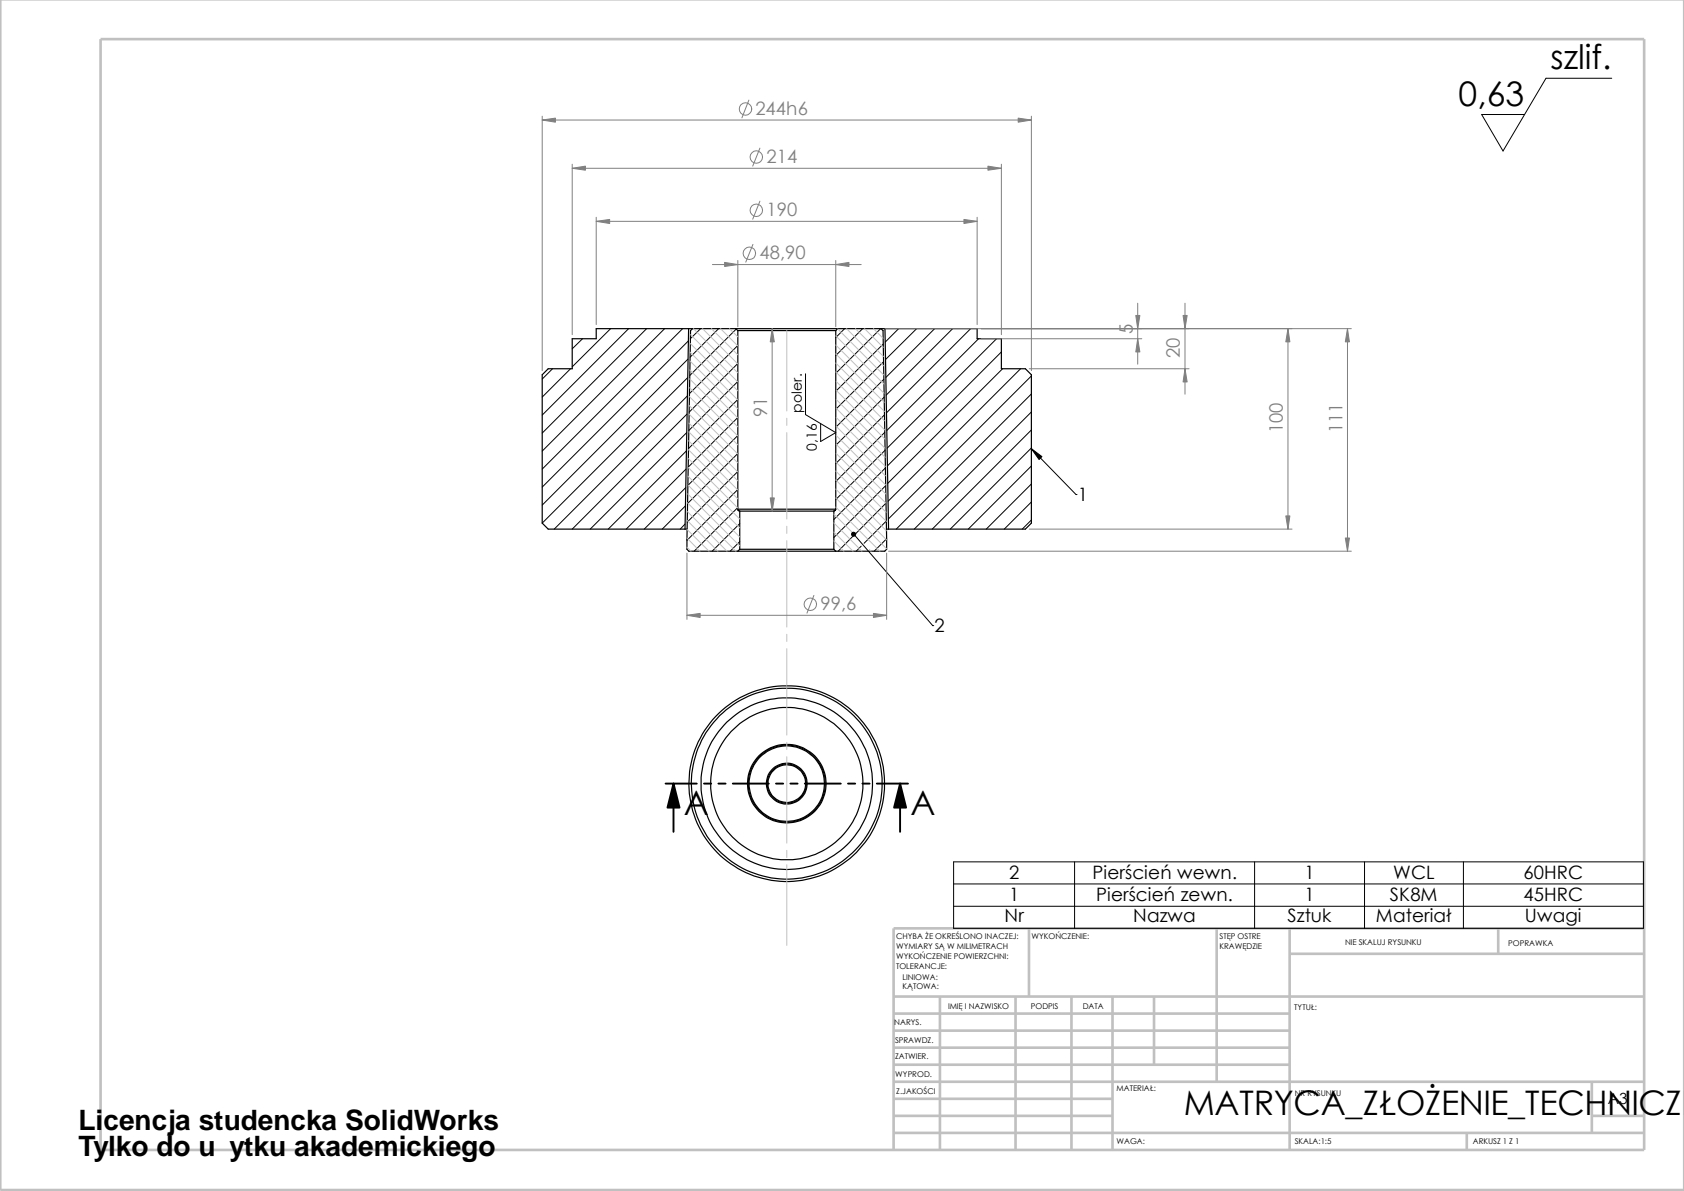
[picture p116: page 1]
Nazwa; Sztuk; Materia; Uwagi WYKOCZENIE:; KTOWA:; ZATWIER. SPRAWDZ.; MATRYCA_ZOENIE_TECHNICZNY; LINIOWA:; 1 poler. 0,16

2 | Piercie wewn. | 1 | WCL | 60HRC
1 | Piercie zewn. | 1 | SK8M | 45HRC

CHYBA E OKRELONO INACZEJ: WYMIARY S W MILIMETRACH WYKOCZENIE POWIERZCHNI: TOLERANCJE:

STP OSTRE
POPRAWKA KRAWDZIE

NIE SKALUJ RYSUNKU

IMI I NAZWISKO | PODPIS | DATA | TYTU:

NARYS.

Z.JAKOCI WYPROD.

MATERIA: WAGA: | NR RYSUNKU | A3

Licencja studencka SolidWorks Tylko do użytku akademickiego

SKALA:1:5 | ARKUSZ 1 Z 1
