ptymek/projekt_obpla_wip/PDF/PROCES_TECHNOLOGICZNY_DRUK.pdf

Wyciganie | Prostowanie dna | Obcicie naddatku

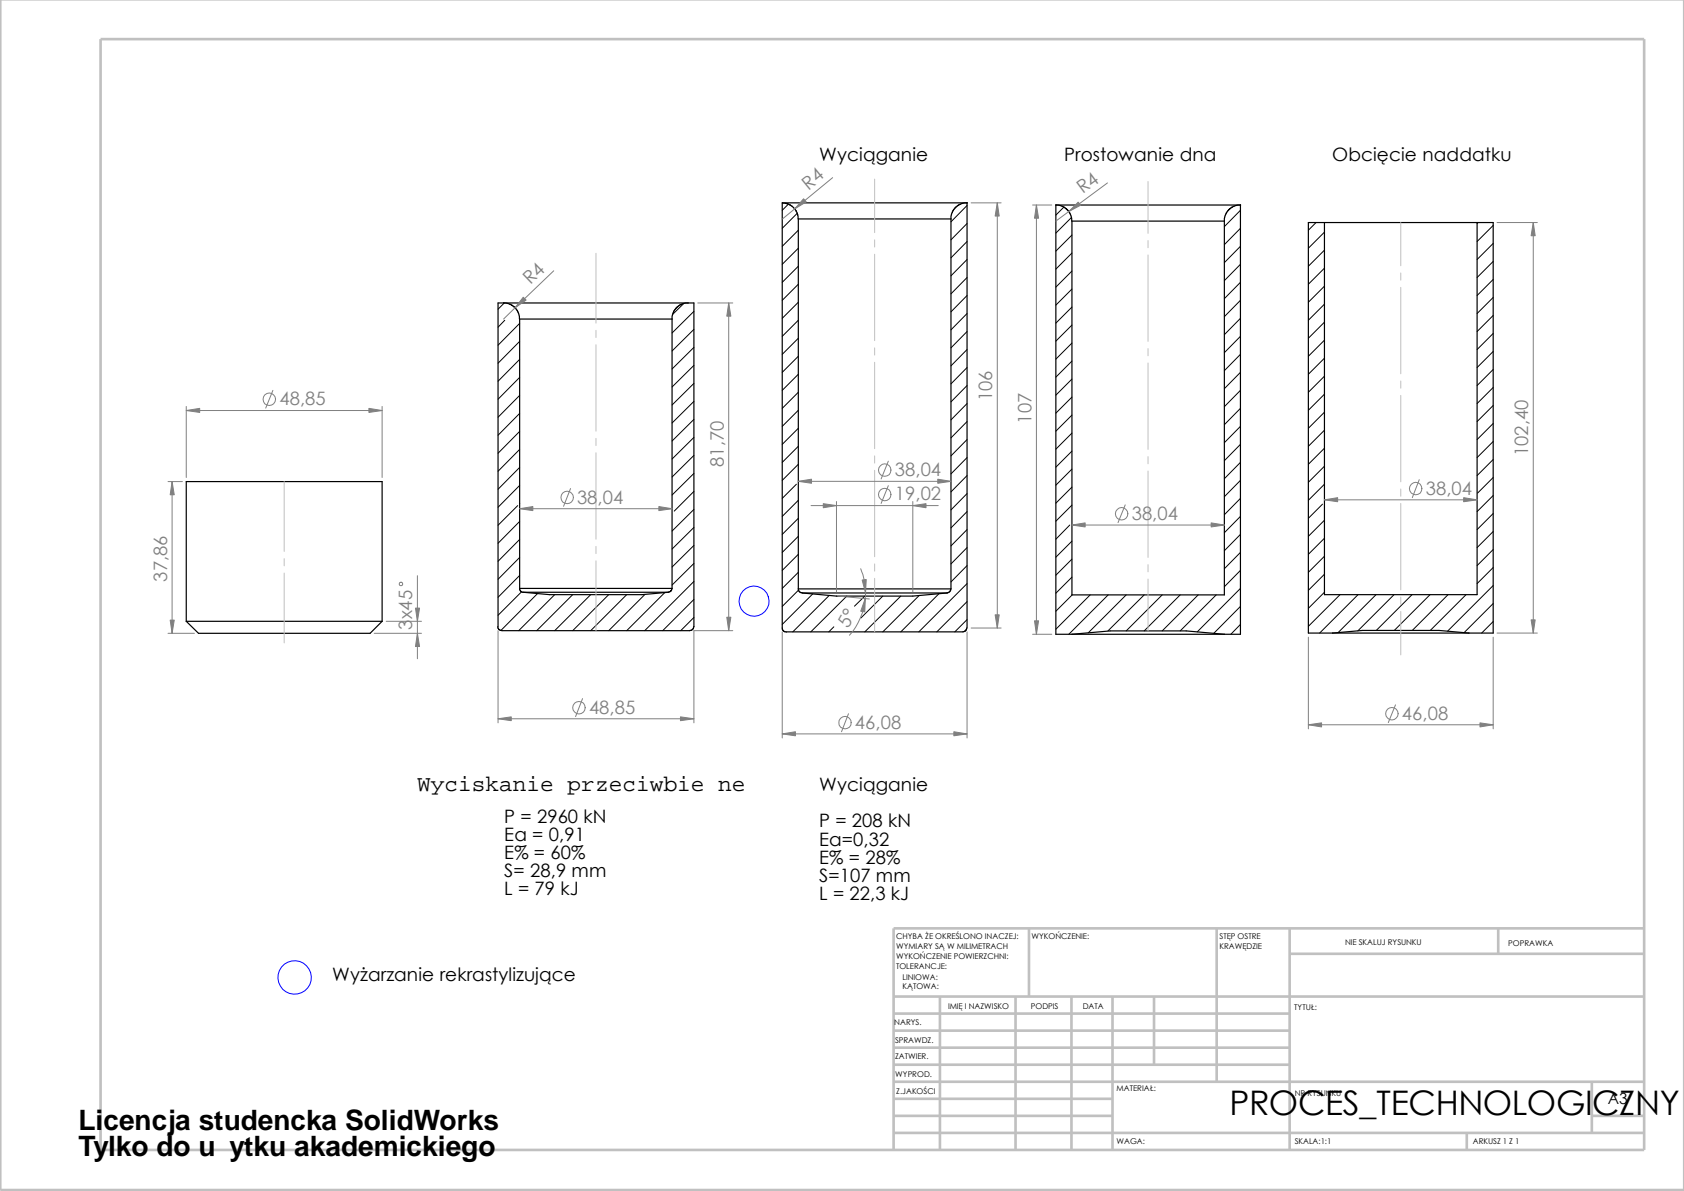
[picture p117: page 1]
ZATWIER. SPRAWDZ.; PROCES_TECHNOLOGICZNY; SKALA:1:1; ARKUSZ 1 Z 1; NIE SKALUJ RYSUNKU; POPRAWKA; STP OSTRE; KTOWA:; WYKOCZENIE:; KRAWDZIE CHYBA E OKRELONO INACZEJ: WYMIARY S W MILIMETRACH WYKOCZENIE POWIERZCHNI: TOLERANCJE:; LINIOWA:; Wyciskanie przeciwbieżne P = 2960 kN Ea = 0,91; Wyciganie P = 208 kN Ea=0,32 E% = 28% S=107 mm

Wyarzanie rekrastylizujce

IMI I NAZWISKO | PODPIS | DATA | TYTU:

NARYS.

WYPROD.
Z.JAKOCI | MATERIA: WAGA: | NR RYSUNKU | A3

Licencja studencka SolidWorks Tylko do użytku akademickiego
