ptymek/projekt_obpla_wip/PDF/SCHEMAT_PRACY_DRUK.pdf

A A

B B

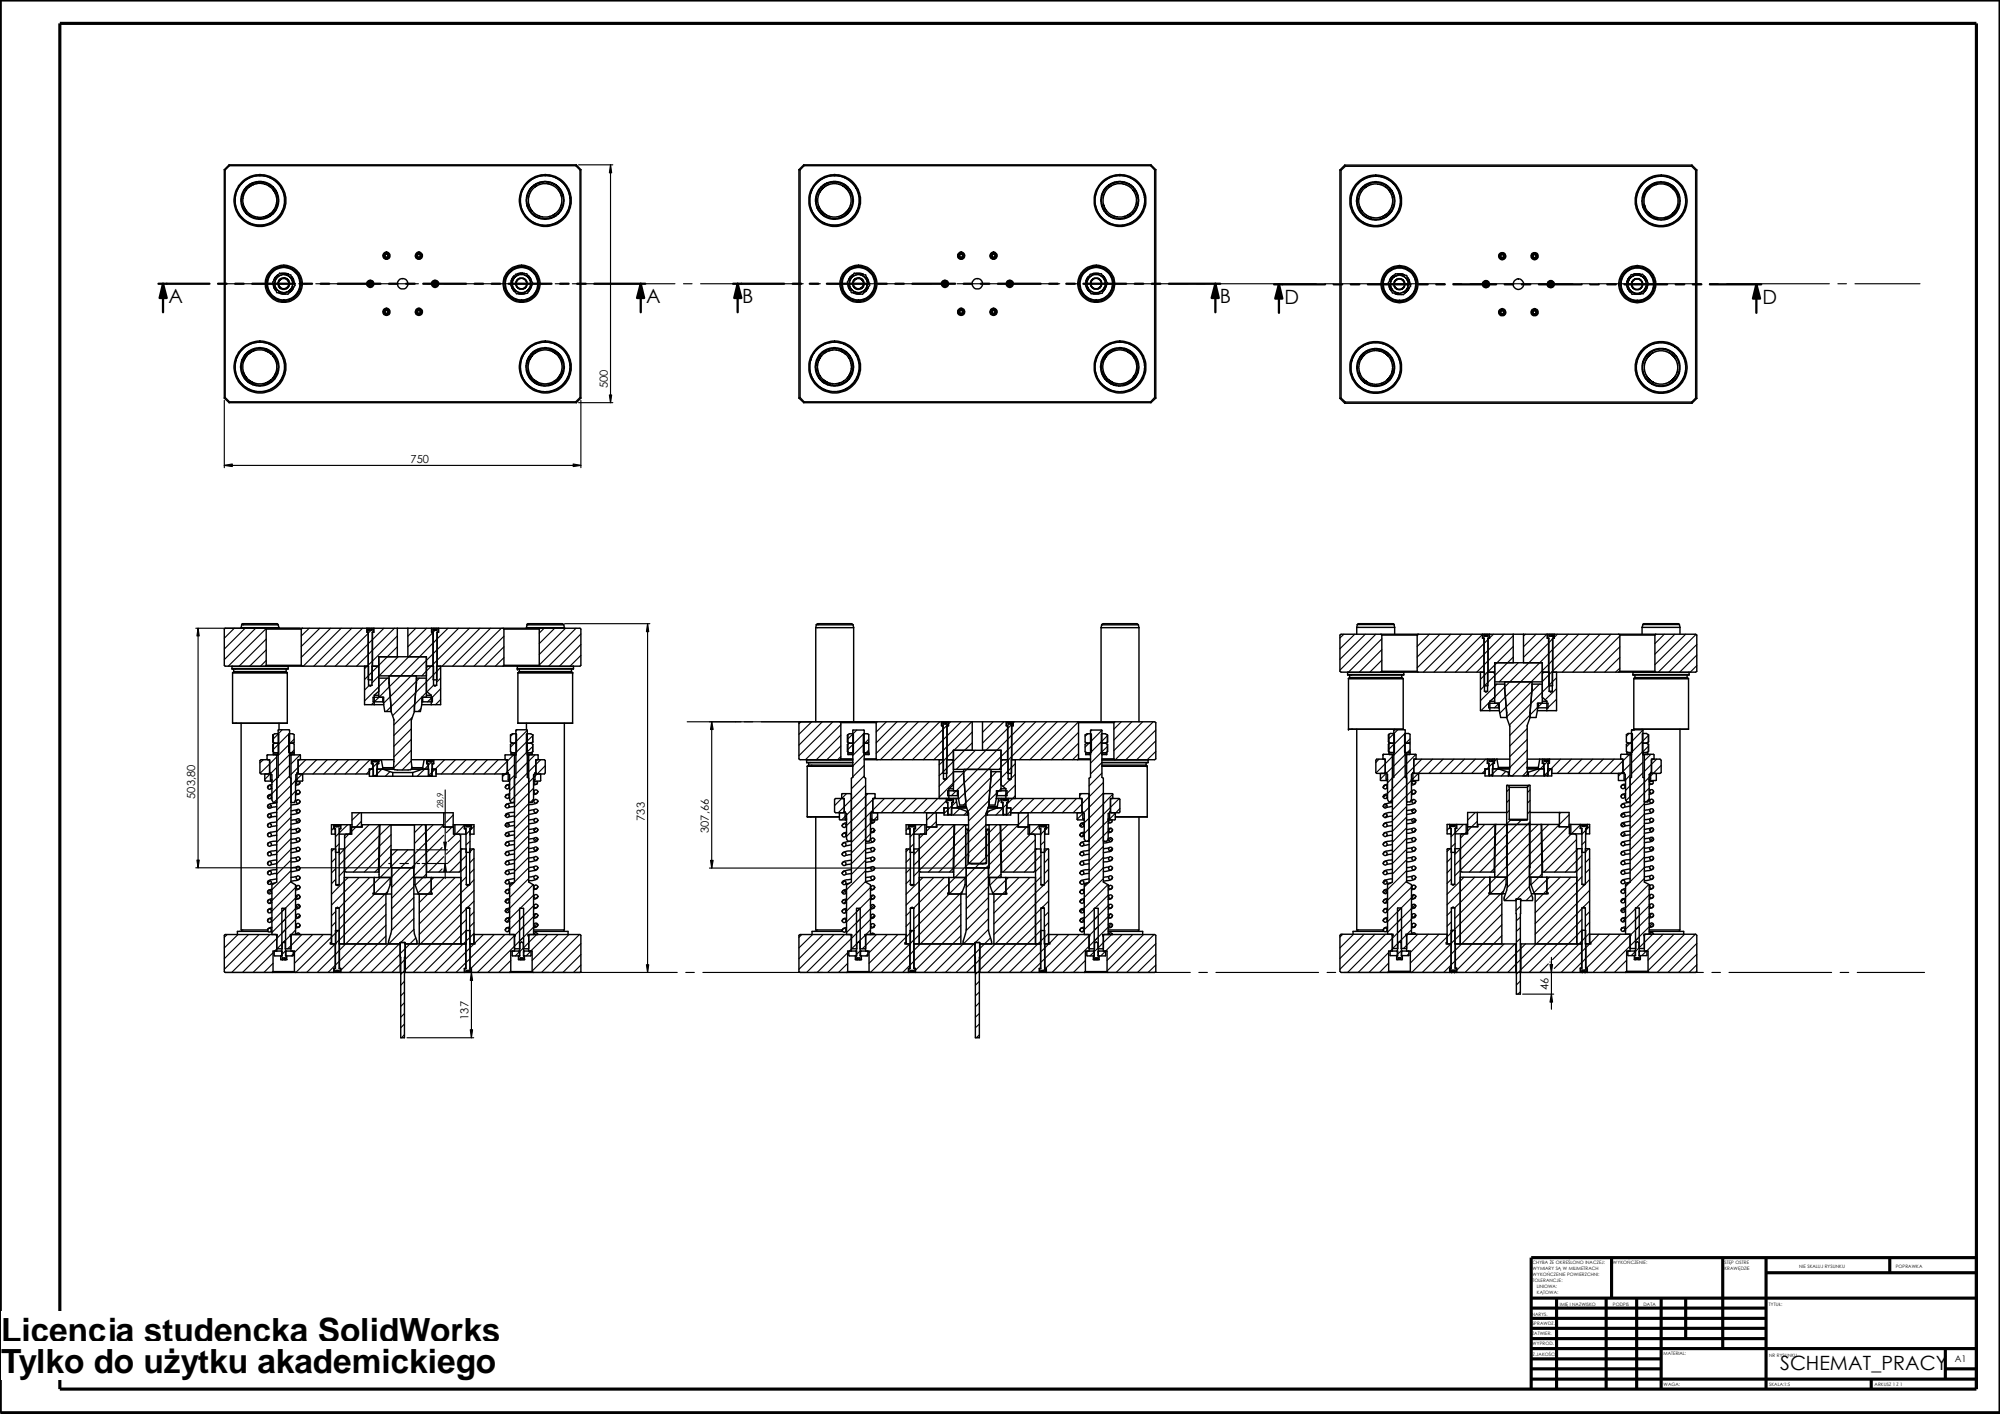
[picture p118: page 1]
WAGA:; SKALA:1:5; ARKUSZ 1 Z 1; NIE SKALUJ RYSUNKU; POPRAWKA; WYKOŃCZENIE:; KRAWĘDZIE; CHYBA ŻE OKREŚLONO INACZEJ:; STĘP OSTRE

WYMIARY SĄ W MILIMETRACH
WYKOŃCZENIE POWIERZCHNI:
TOLERANCJE:
LINIOWA:
KĄTOWA:

IMIĘ I NAZWISKO | DATA PODPIS | | | | TYTUŁ:

Licencja studencka SolidWorks Tylko do użytku akademickiego

NARYS.

SPRAWDZ.

ZATWIER.

WYPROD.

Z.JAKOŚCI | | | MATERIAL: | NR RYSUNKU SCHEMAT_PRACY | A1
