ptymek/projekt_obpla_wip/PDF/STEMPEL_DRUK.pdf

szlif.
0,63

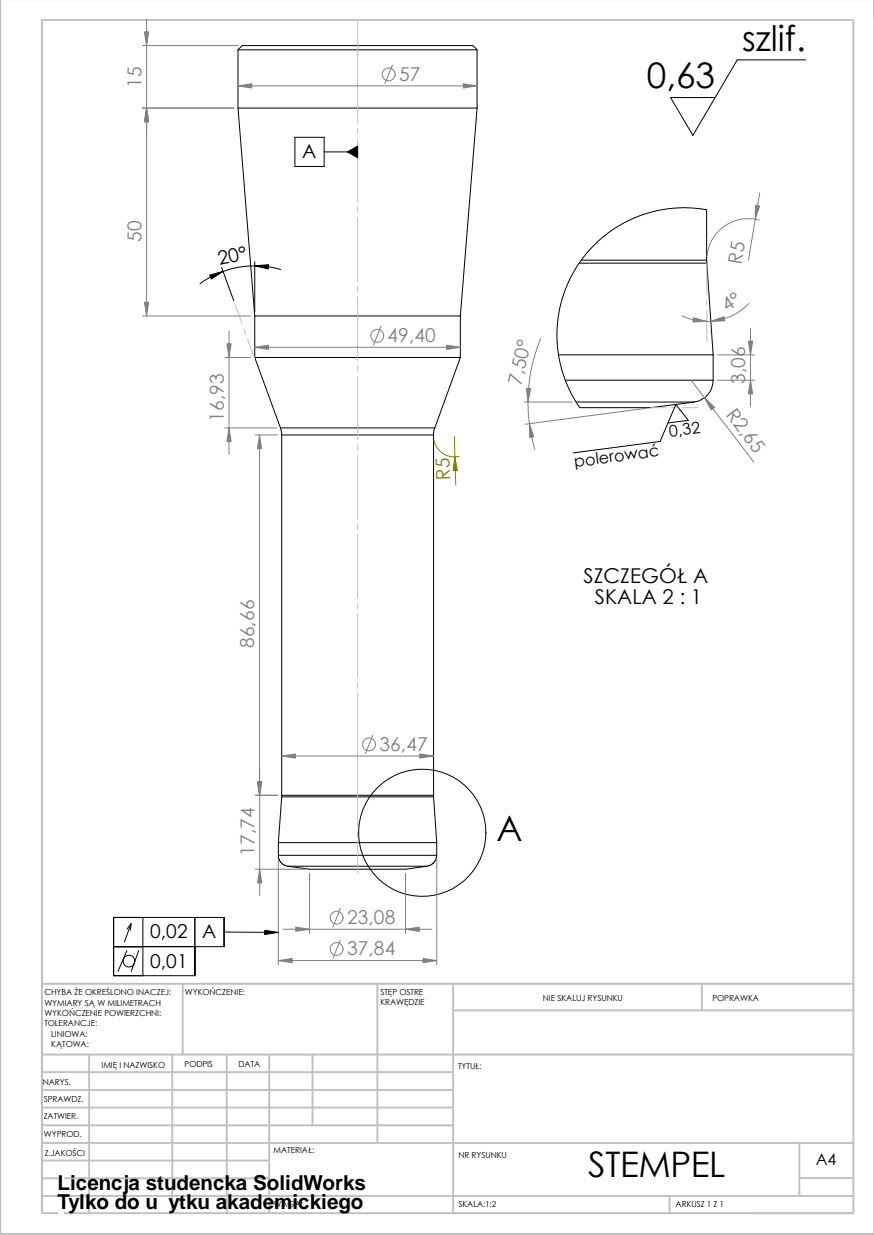
[picture p119: page 1]
NIE SKALUJ RYSUNKU; POPRAWKA CHYBA E OKRELONO INACZEJ:; SZCZEGÓ A SKALA 2 : 1; polerowa

0,02 | A
0,01

WYMIARY S W MILIMETRACH WYKOCZENIE POWIERZCHNI: TOLERANCJE: LINIOWA: KTOWA: | WYKOCZENIE: | STP OSTRE KRAWDZIE

IMI I NAZWISKO | PODPIS | DATA | TYTU: STEMPEL
NARYS.
ZATWIER. SPRAWDZ.

Z.JAKOCI WYPROD.
Licencja studencka SolidWorks Tylko do użytku akademickiego

MATERIA: WAGA: | NR RYSUNKU | A4

SKALA:1:2 | ARKUSZ 1 Z 1
